miu-ll/robot-2/imagenes/explosionada_perfil.png

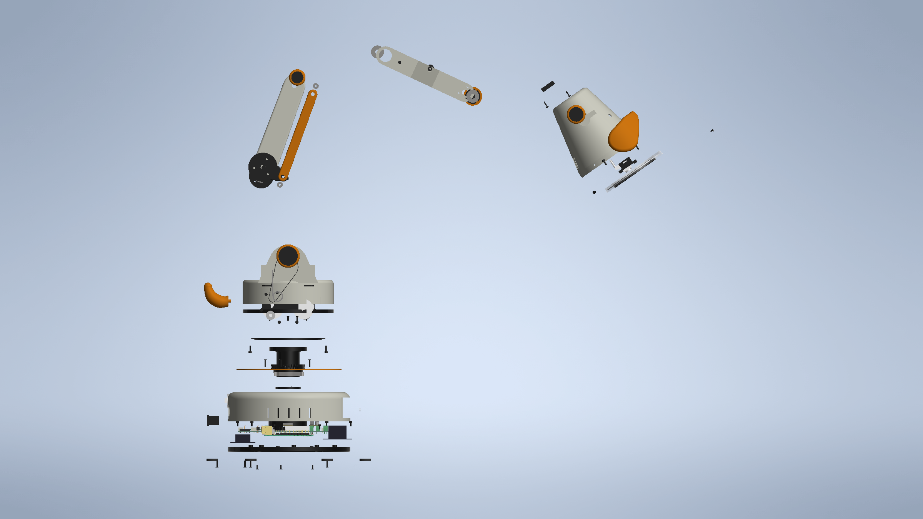
imagenes/explosionada_perfil.png
