miu-ll/robot-2/imagenes/foto_producto_alto.png

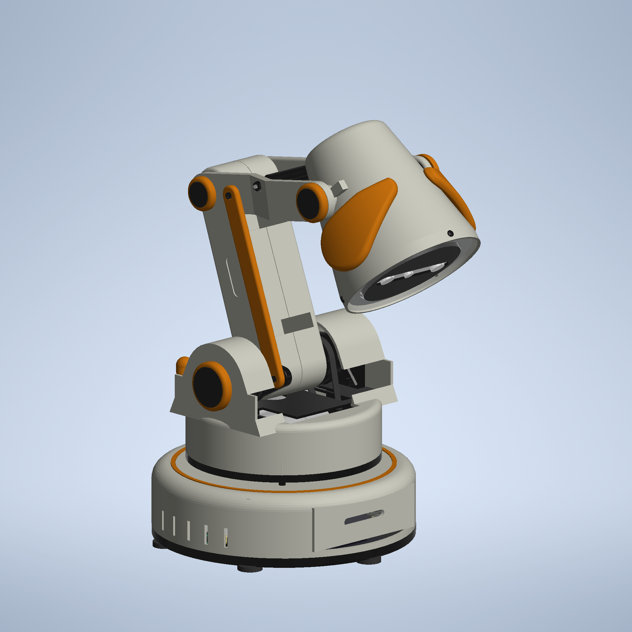
imagenes/foto_producto_alto.png
