miu-ll/robot-2/imagenes/explosionada_iso.png

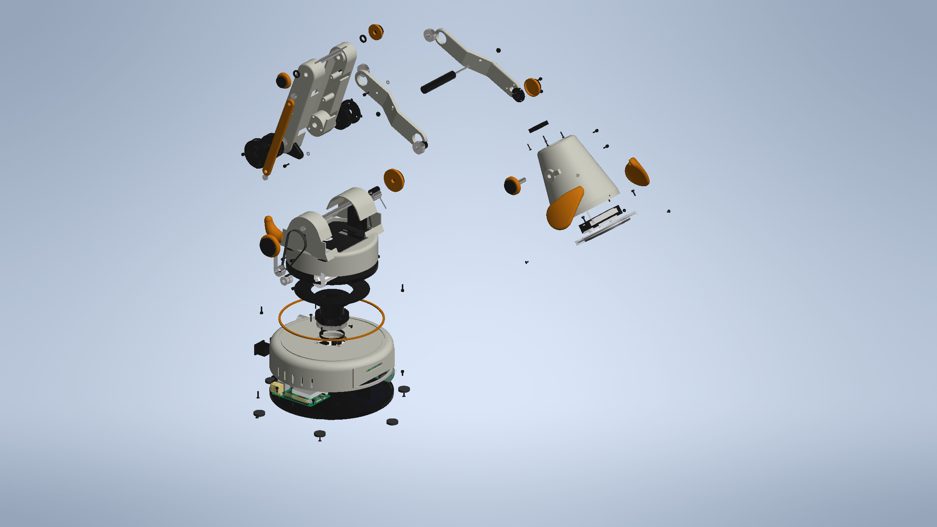
imagenes/explosionada_iso.png
