miu-ll/robot-2/imagenes/foto_producto_3-4.png

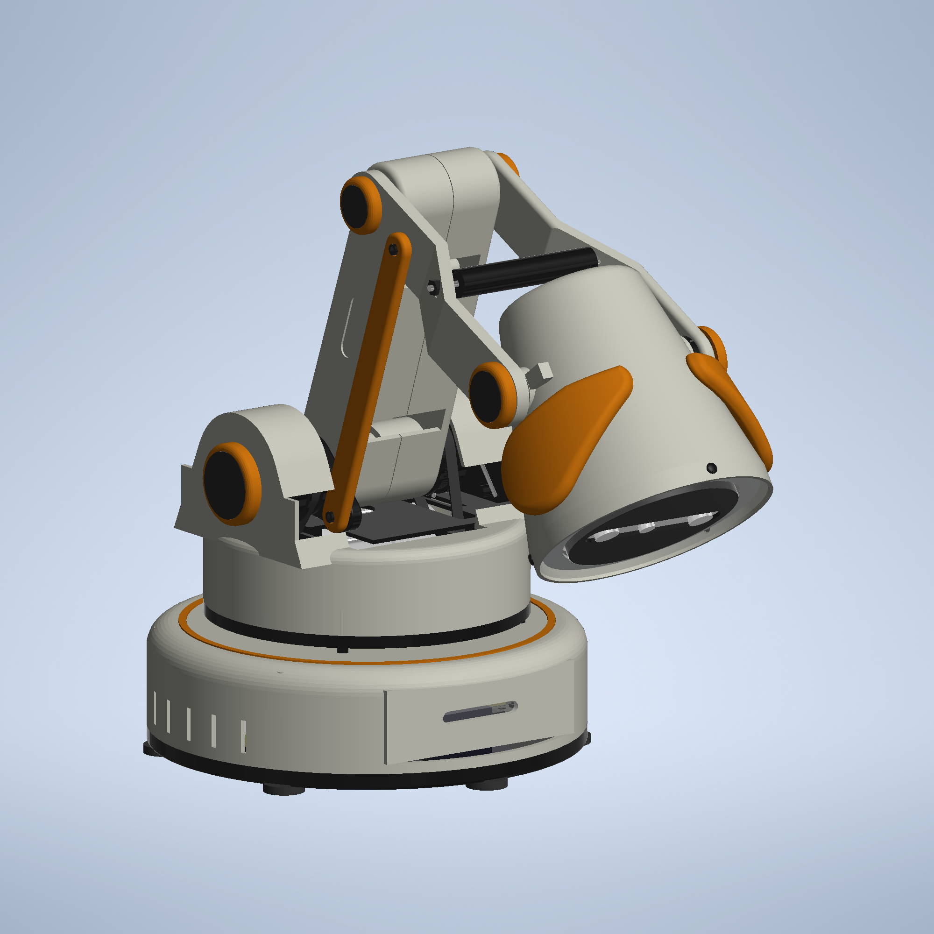
imagenes/foto_producto_3-4.png
