miu-ll/robot-2/imagenes/foto_producto_frente.png

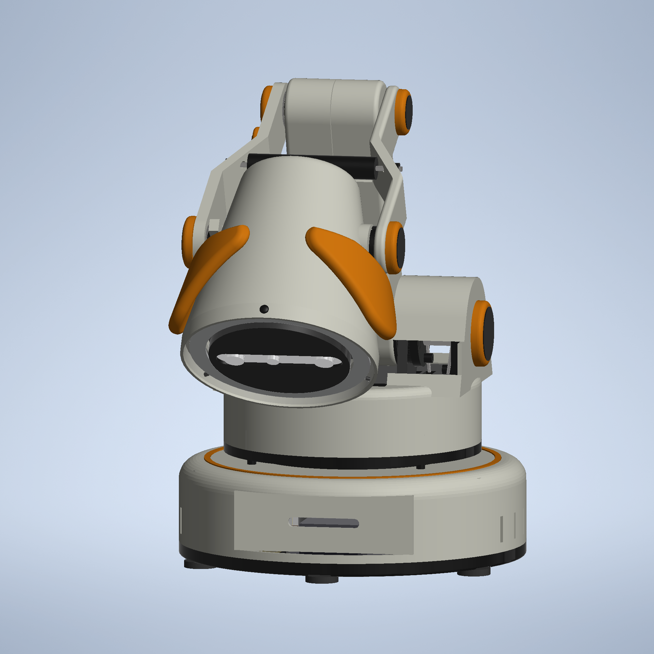
imagenes/foto_producto_frente.png
