miu-ll/robot-2/imagenes/rangos/rango_anotado_q1.png

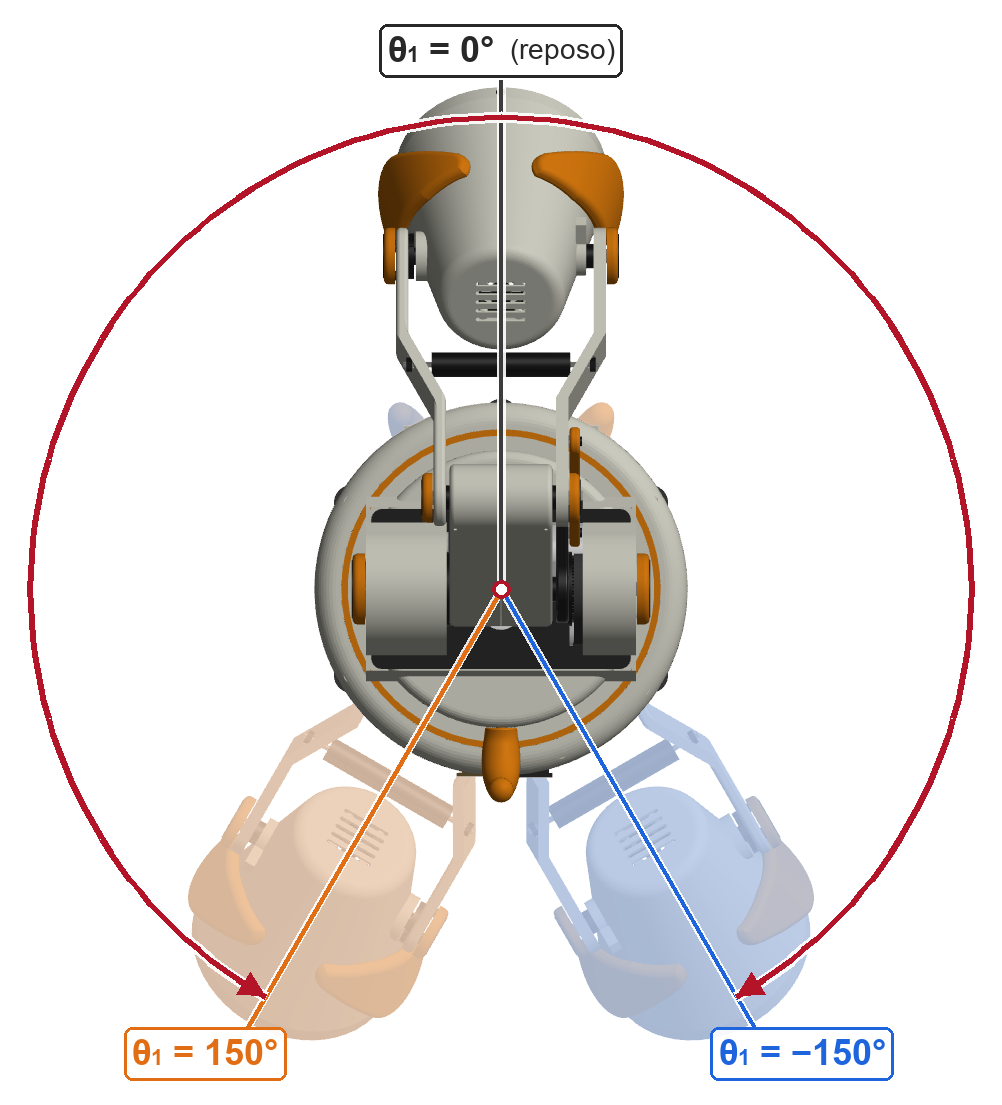
imagenes/rangos/rango_anotado_q1.png
