miu-ll/robot-2/imagenes/rangos/rango_anotado_q2.png

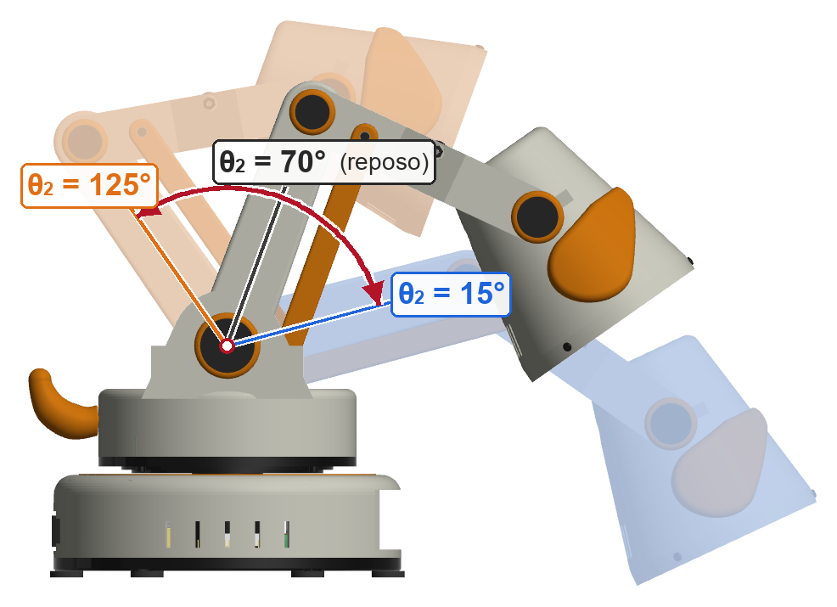
imagenes/rangos/rango_anotado_q2.png
