miu-ll/robot-2/imagenes/sistemas_dh.png

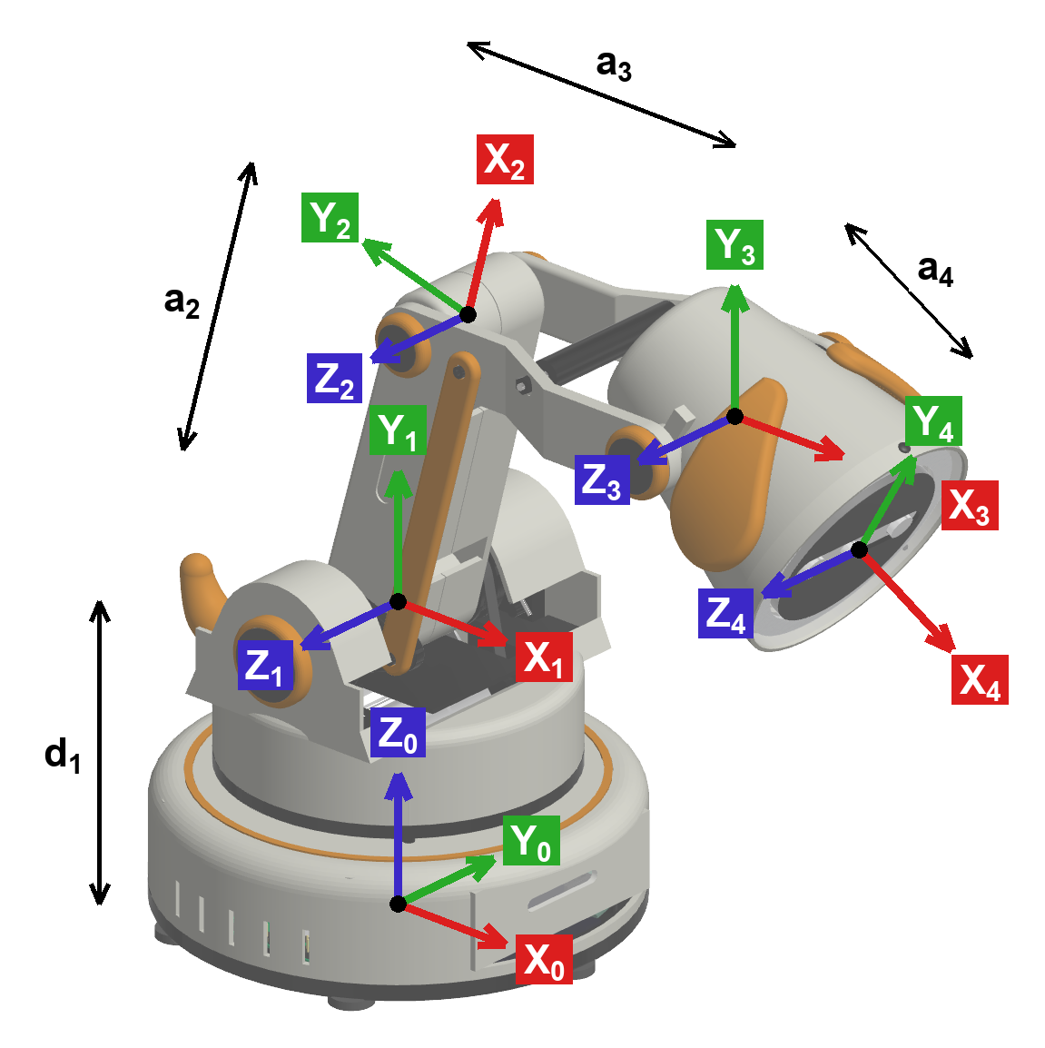
imagenes/sistemas_dh.png
