miu-ll/robot-2/imagenes/vistas/vista_frontal.png

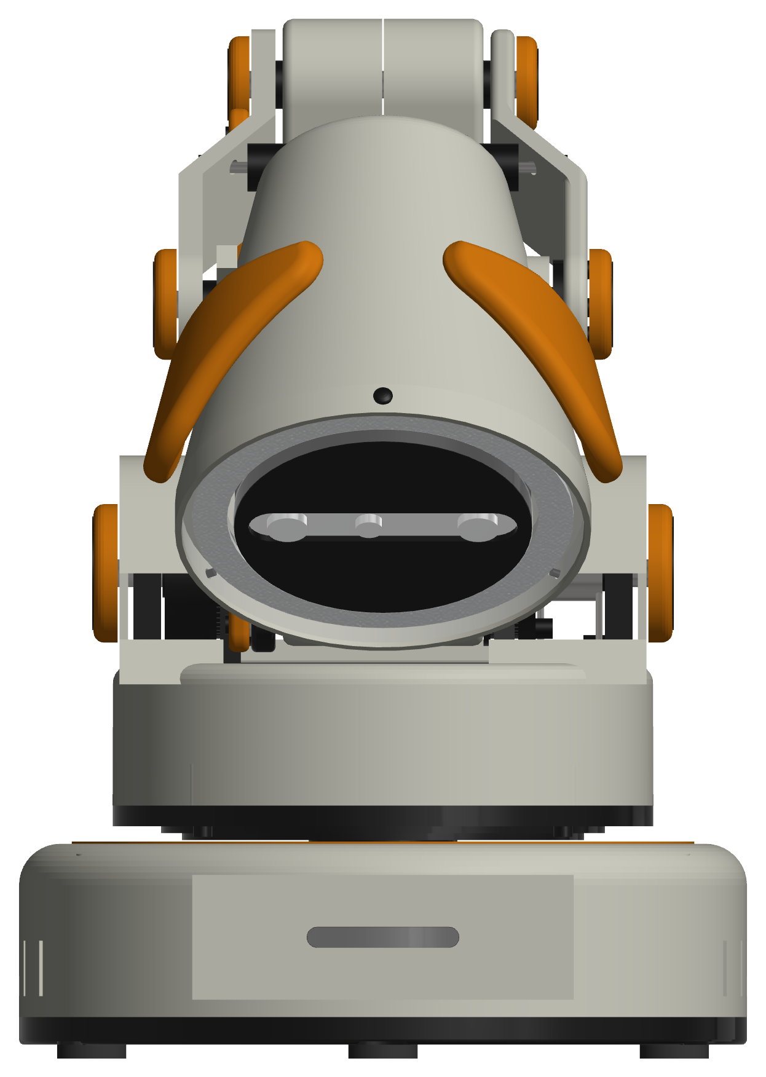
imagenes/vistas/vista_frontal.png
