miu-ll/robot-2/imagenes/vistas/vista_isometrica.png

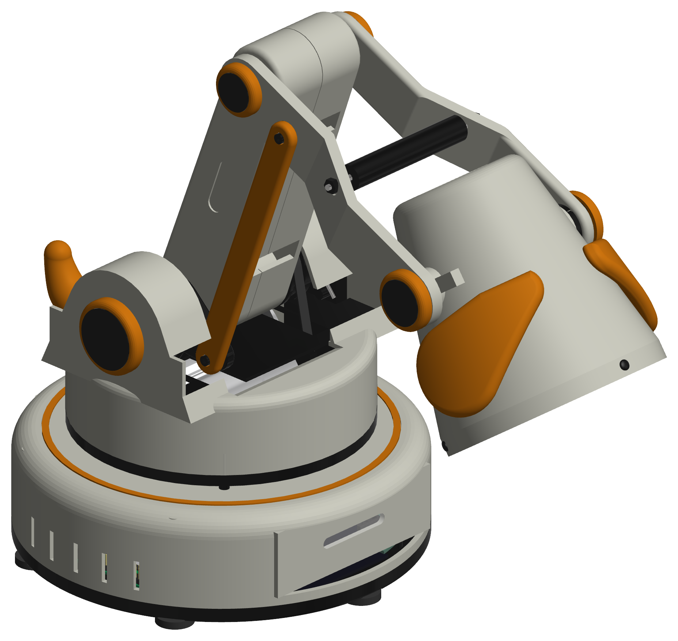
imagenes/vistas/vista_isometrica.png
