miu-ll/robot-2/imagenes/vistas/vista_perfil.png

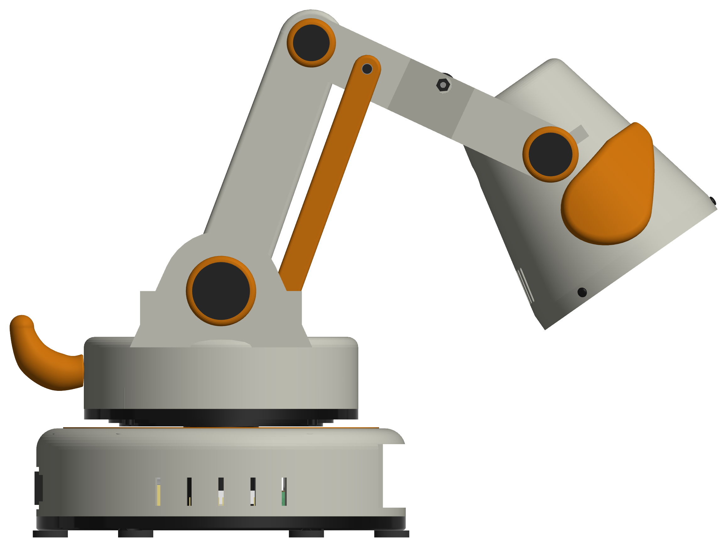
imagenes/vistas/vista_perfil.png
