miu-ll/robot-2/imagenes/vistas/vista_superior.png

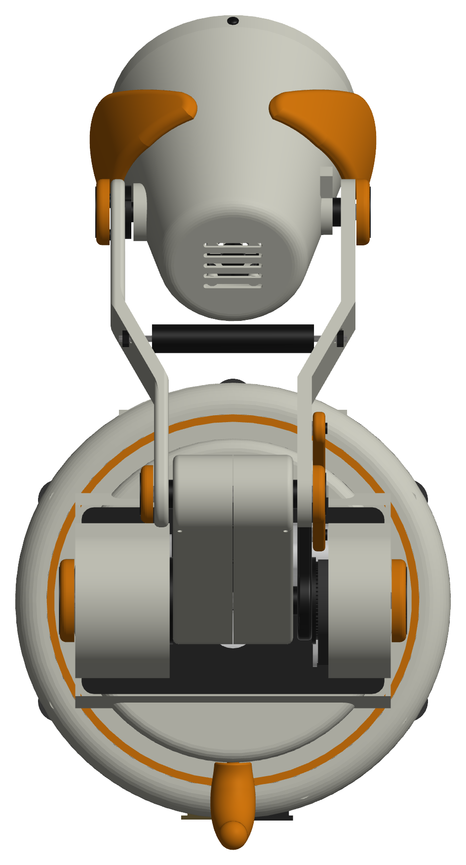
imagenes/vistas/vista_superior.png
