miu-ll/robot-2/electronica/Fabricacion/Lampara_4R_placa.step

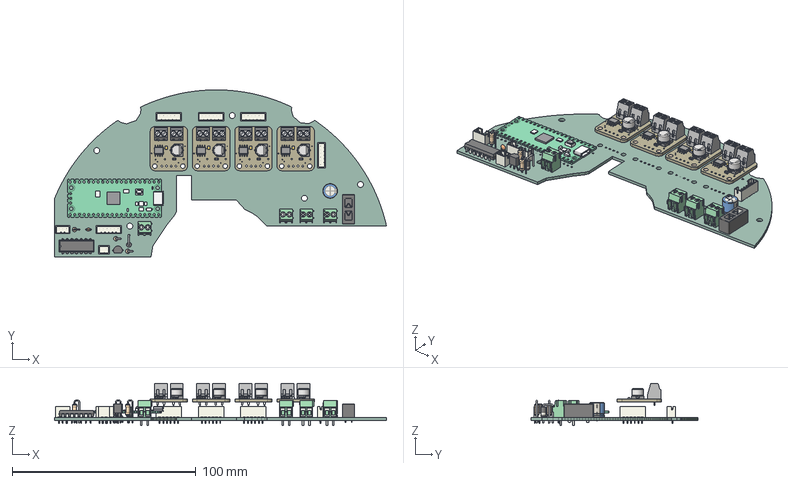
[picture p15: CAD file, 2026-10-04]
electronica/Fabricacion/Lampara_4R_placa.step
180.7 x 91.0 x 23.1 mm
Board x 4
HSOP8 x 4
0805-NO x 4
PANASONIC_D x 4
0805-THM x 4
TERMBLOCK_1X2-3.5MM x 8
TerminalBlock_Phoenix_PT-1,5-2-3.5-H_1x02_P3.50mm_Horizontal x 4
JST_PH_B2B-PH-K_1x02_P2.00mm_Vertical
CP_Radial_D8.0mm_P3.50mm
Fuseholder_Blade_Mini_Keystone_3568
JST_PH_B6B-PH-K_1x06_P2.00mm_Vertical x 5
R_Axial_DIN0207_L6.3mm_D2.5mm_P2.54mm_Vertical x 3
C_Disc_D3.0mm_W1.6mm_P2.50mm
JST_PH_B3B-PH-K_1x03_P2.00mm_Vertical
TO-92_Inline_Wide
DIP-14_W7.62mm
D_DO-41_SOD81_P5.08mm_Vertical_AnodeUp
Lampara_4R_PCB
