miu-ll/robot-2/electronica/modelos_3d/3190_DRV8871_Breakout.step

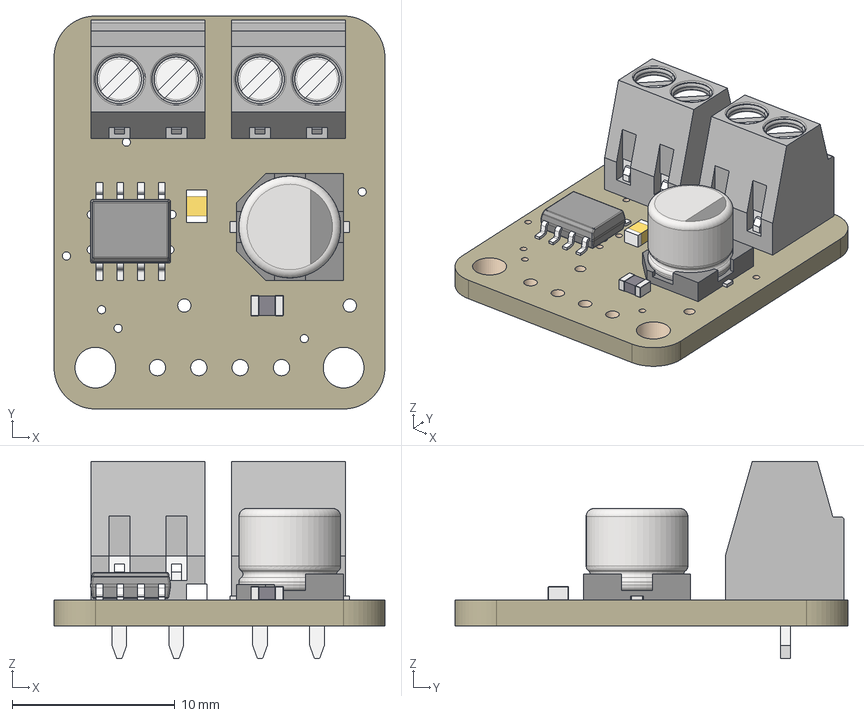
[picture p16: CAD file, 2026-10-04]
electronica/modelos_3d/3190_DRV8871_Breakout.step
20.3 x 24.1 x 12.1 mm
Board
DRV8871
0.1uF/50V
22uF/63V
30K
POWER x 2
