miu-ll/robot-2/electronica/modelos_3d/Pico-R3_color.step

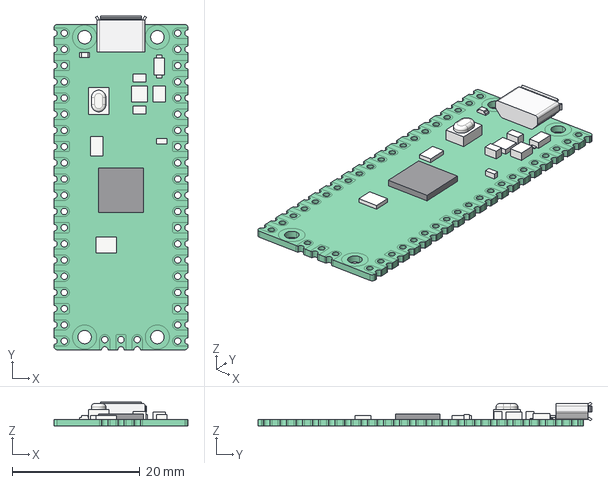
[picture p17: CAD file, 2026-10-04]
electronica/modelos_3d/Pico-R3_color.step
21.0 x 52.3 x 3.73 mm
