miu-ll/robot-2/imagenes/montaje/montaje_sub_1.png

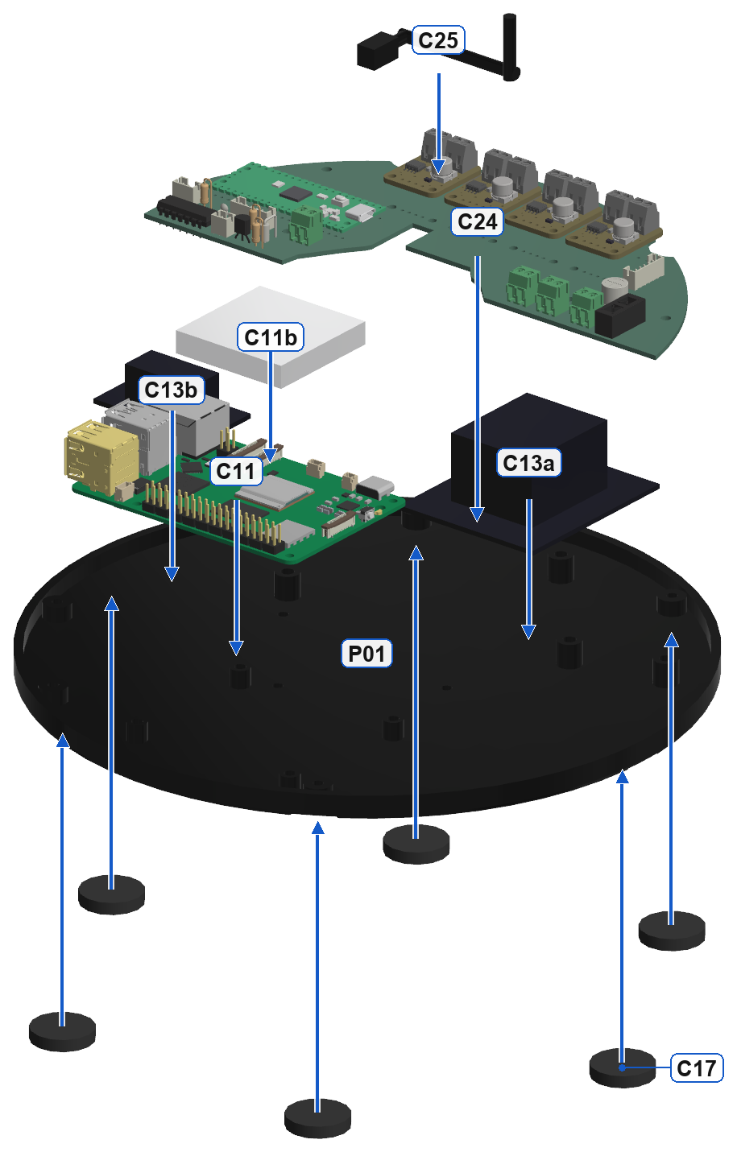
imagenes/montaje/montaje_sub_1.png
