miu-ll/robot-2/imagenes/montaje/montaje_sub_2.png

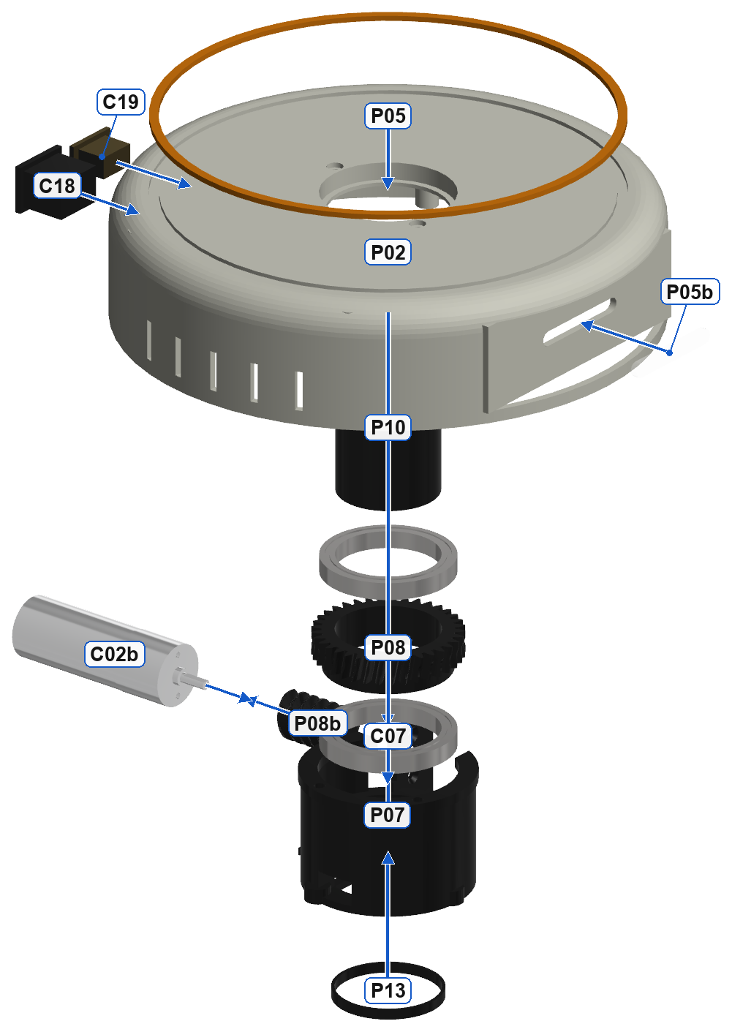
imagenes/montaje/montaje_sub_2.png
