miu-ll/robot-2/imagenes/montaje/montaje_sub_3.png

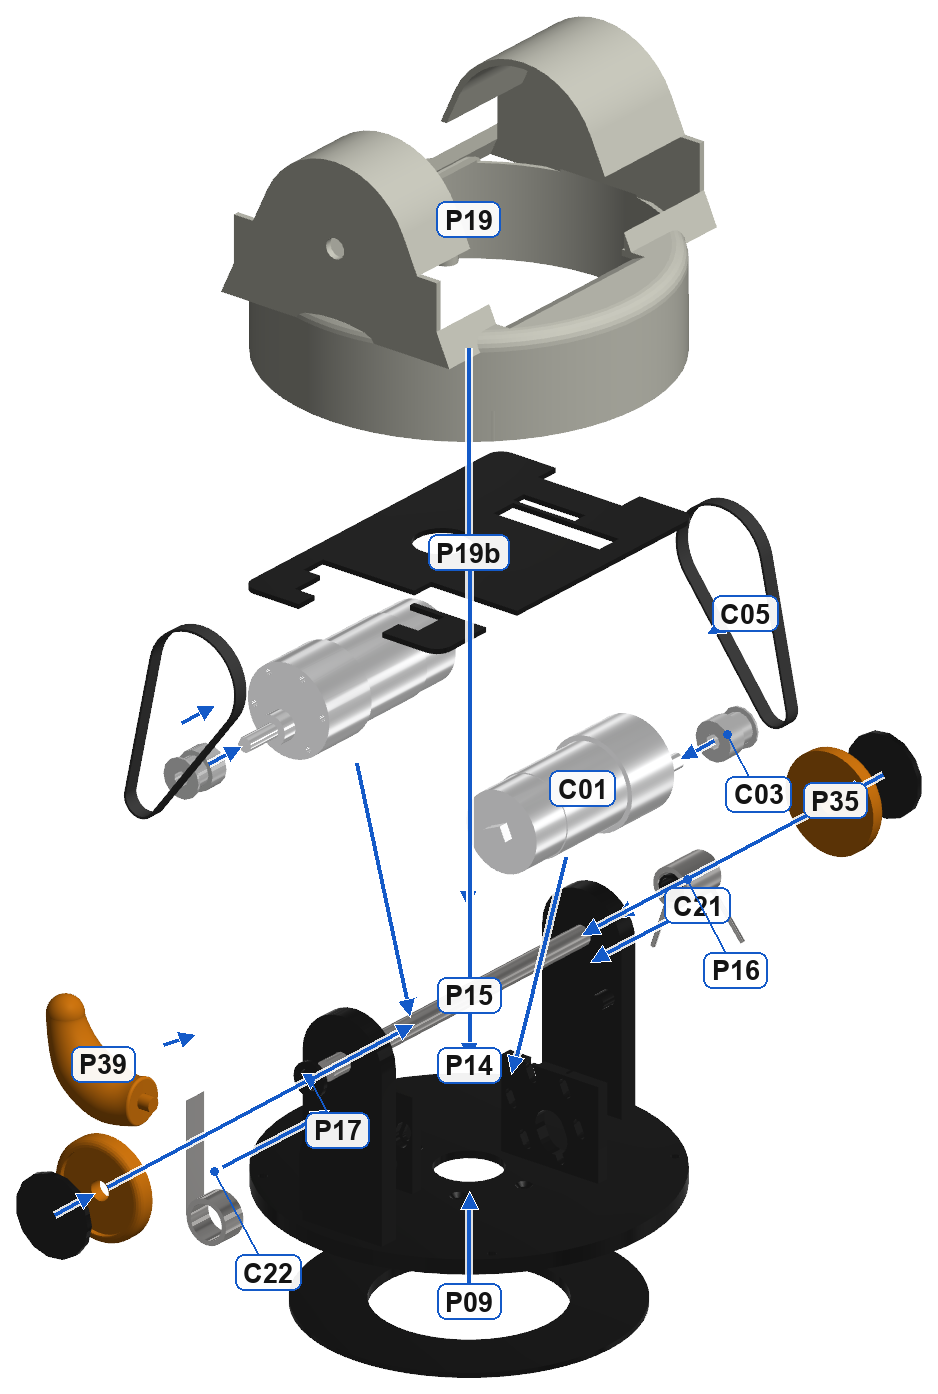
imagenes/montaje/montaje_sub_3.png
