miu-ll/robot-2/imagenes/montaje/montaje_sub_4.png

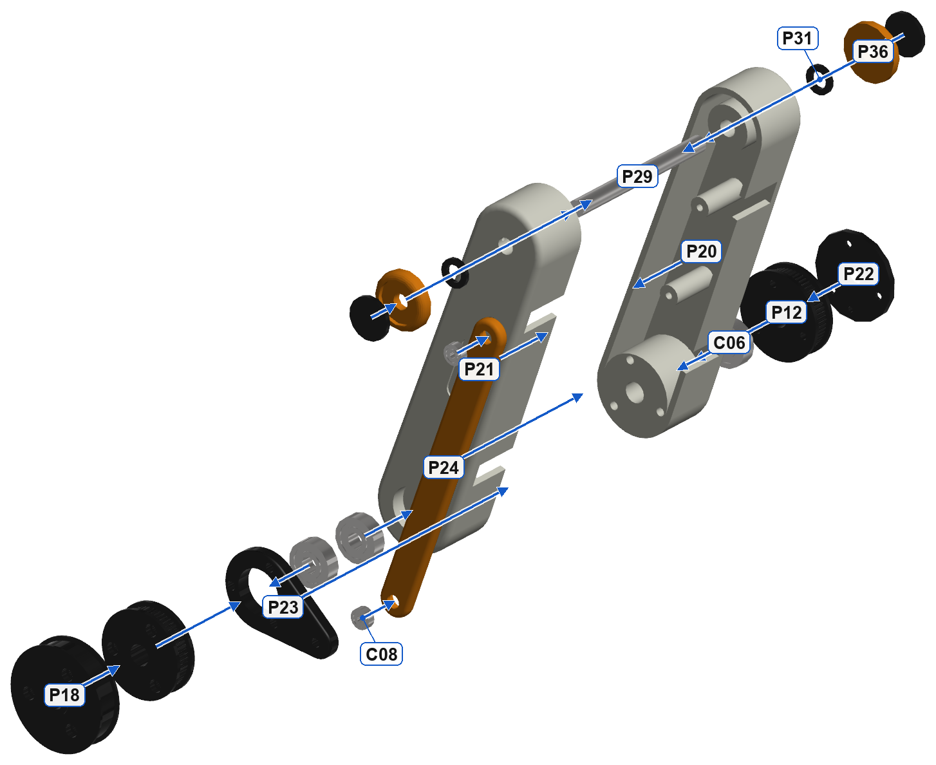
imagenes/montaje/montaje_sub_4.png
