miu-ll/robot-2/imagenes/montaje/montaje_sub_5.png

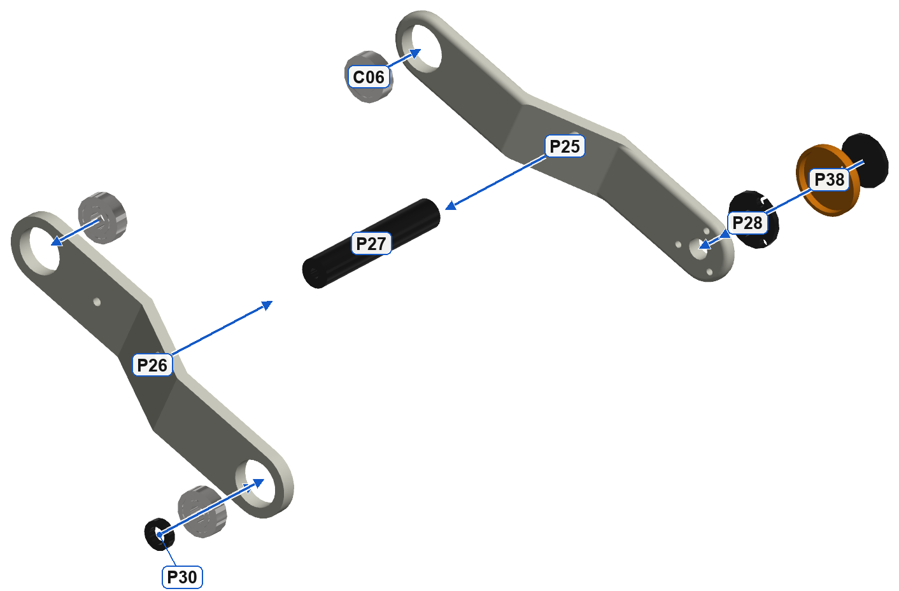
imagenes/montaje/montaje_sub_5.png
