miu-ll/robot-2/imagenes/montaje/montaje_sub_6.png

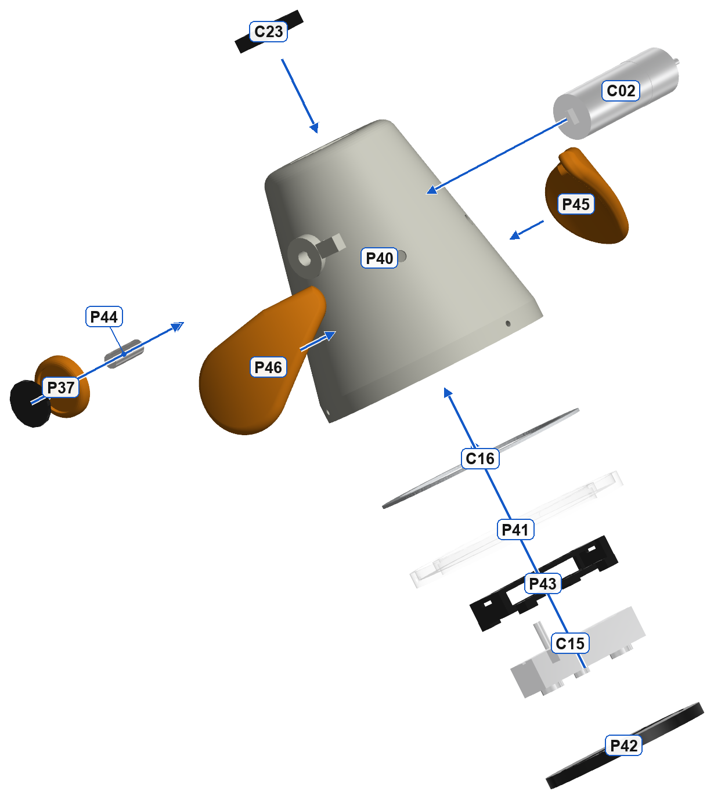
imagenes/montaje/montaje_sub_6.png
