miu-ll/robot-2/electronica/Lampara_4R_esquematico.pdf

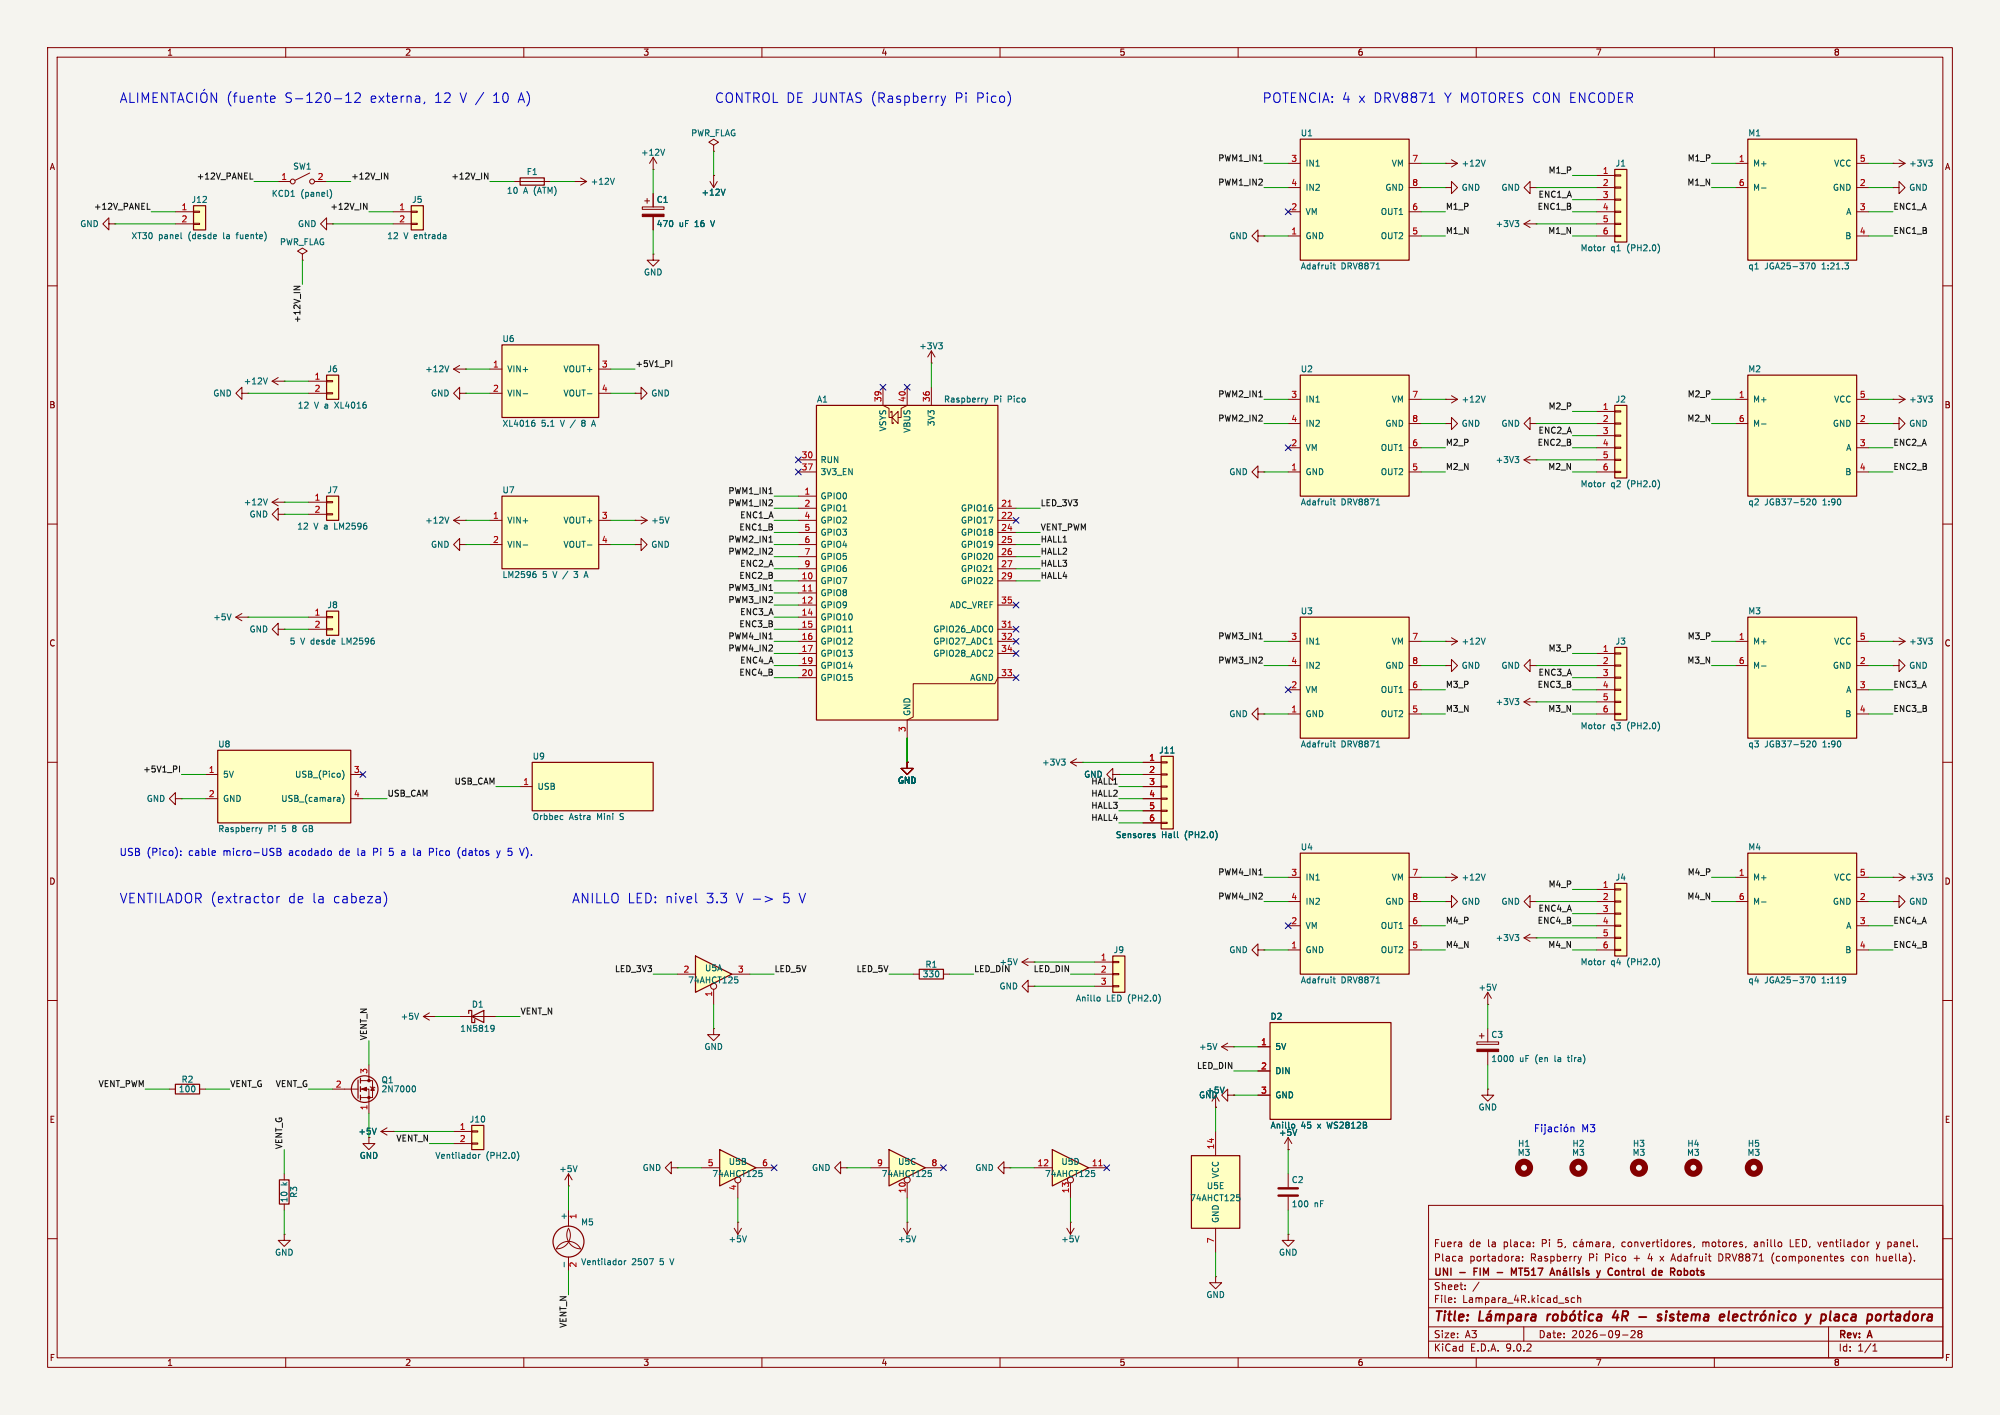
[picture p24: page 1]

POTENCIA: 4 x DRV8871 Y MOTORES CON ENCODER
PWM1_IN2 PWM2_IN1 PWM1_IN1

J12 XT30 panel (desde la fuente)

+3V3 USB 1 U9 Orbbec Astra Mini S

3 3V3 36 GPIO16 21 GPIO17 22 GPIO18 24 GPIO19 25 GPIO20 26 GPIO21 27 GPIO22 29 ADC_VREF 35 GPIO26_ADC0 31 GPIO27_ADC1 32 GPIO28_ADC2 34 AGND 33 A1 Raspberry Pi Pico GND

1000 uF (en la tira) GND

Id: 1/1 Title: þÿLámpara þÿrobótica 4R - sistema þÿelectrónico y placa portadora
