miu-ll/robot-2/planos/Planos_piezas_Lampara_4R.pdf

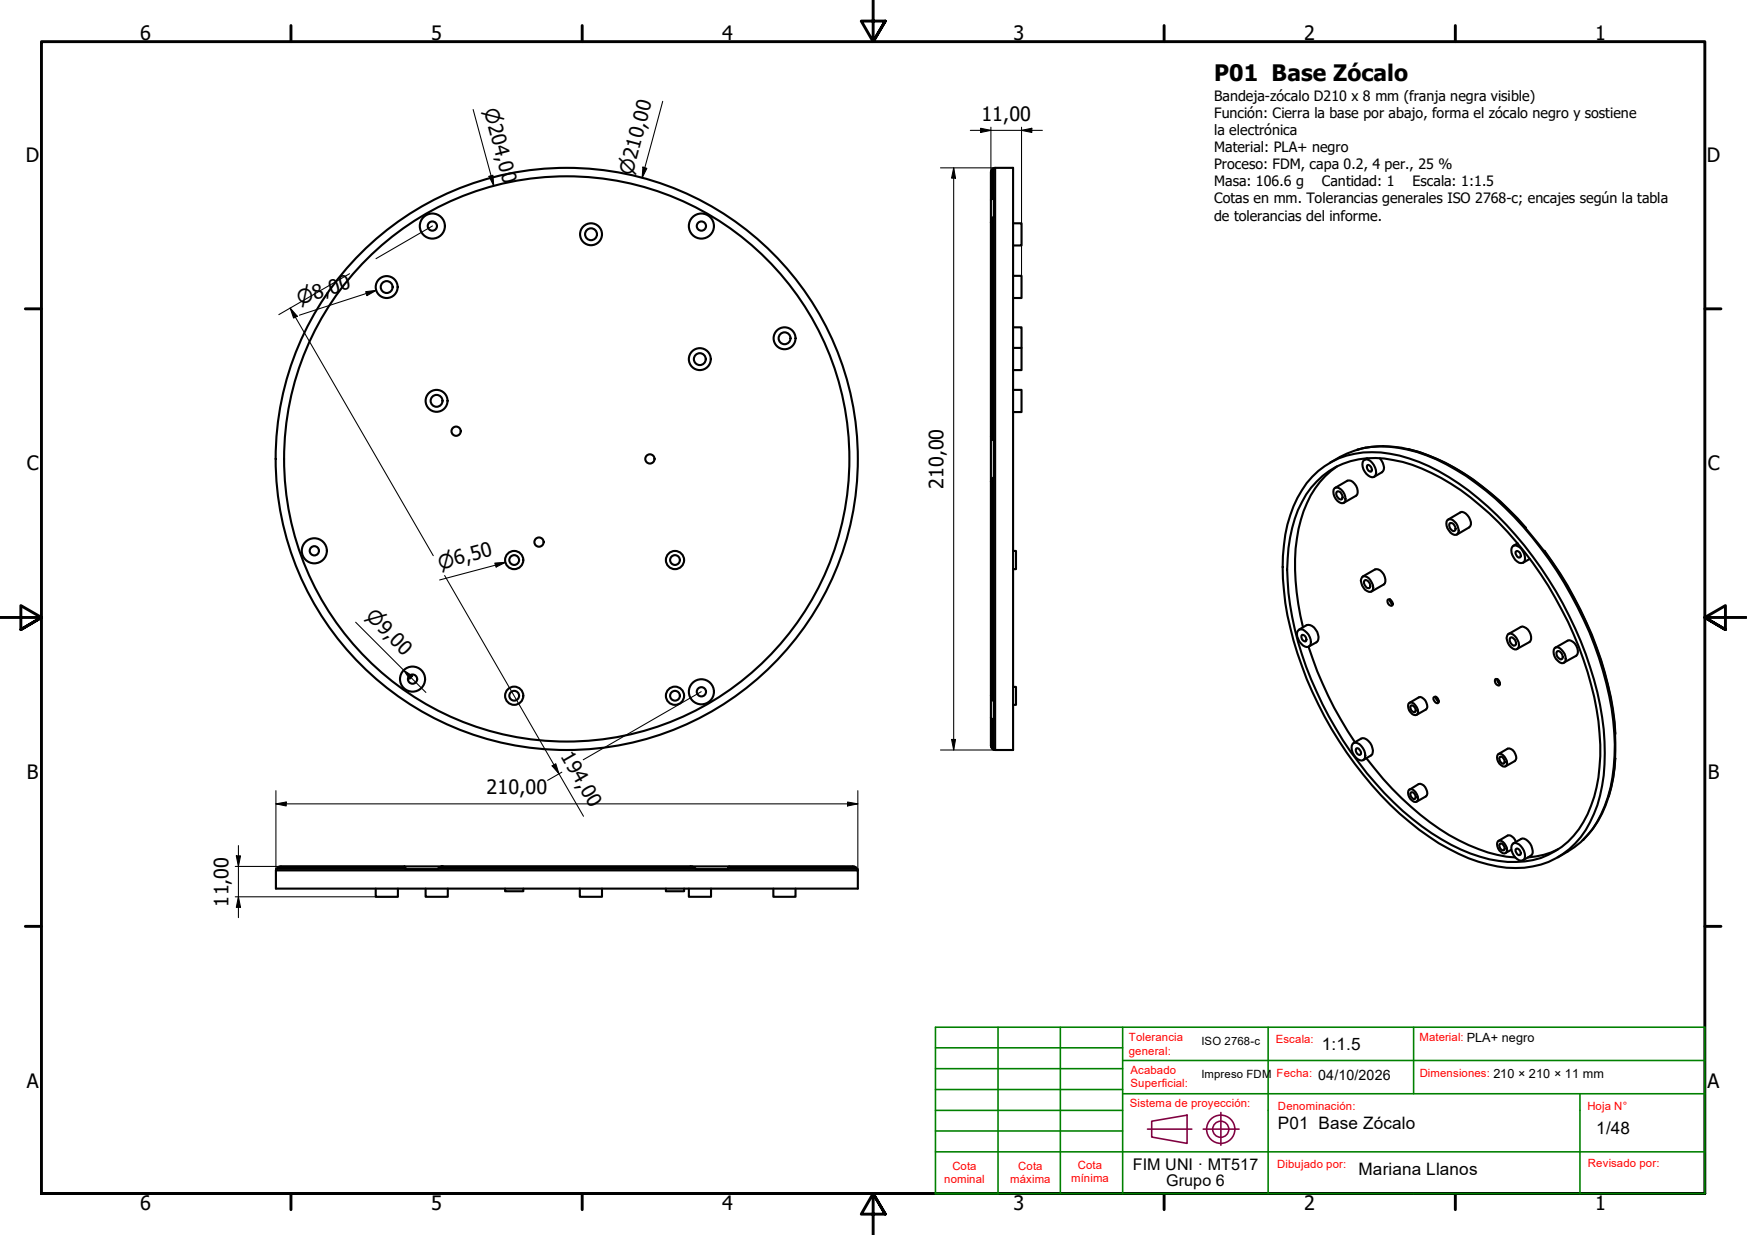
[picture p25: page 1]
Revisado por: ibujado por:; Mariana Llanos; FIM UNI · MT517 Grupo 6; P01 Base Zócalo; Masa: 106.6 g; Cantidad: 1; Escala: 1:1.5

Bandeja-zócalo D210 x 8 mm (franja negra visible)
Función: Cierra la base por abajo, forma el zócalo negro y sostiene
la electrónica
Material: PLA+ negro
Proceso: FDM, capa 0.2, 4 per., 25 %
Cotas en mm. Tolerancias generales ISO 2768-c; encajes según la tabla
de tolerancias del informe.

Tolerancia ISO 2768-c general: | Escala: 1:1.5 | Material: PLA+ negro

Acabado Impreso FDM Superficial: | Fecha: 04/10/2026 | Dimensiones: 210 × 210 × 11 mm

Sistema de proyección: | Denominación: P01 Base Zócalo | Hoja N° 1/48

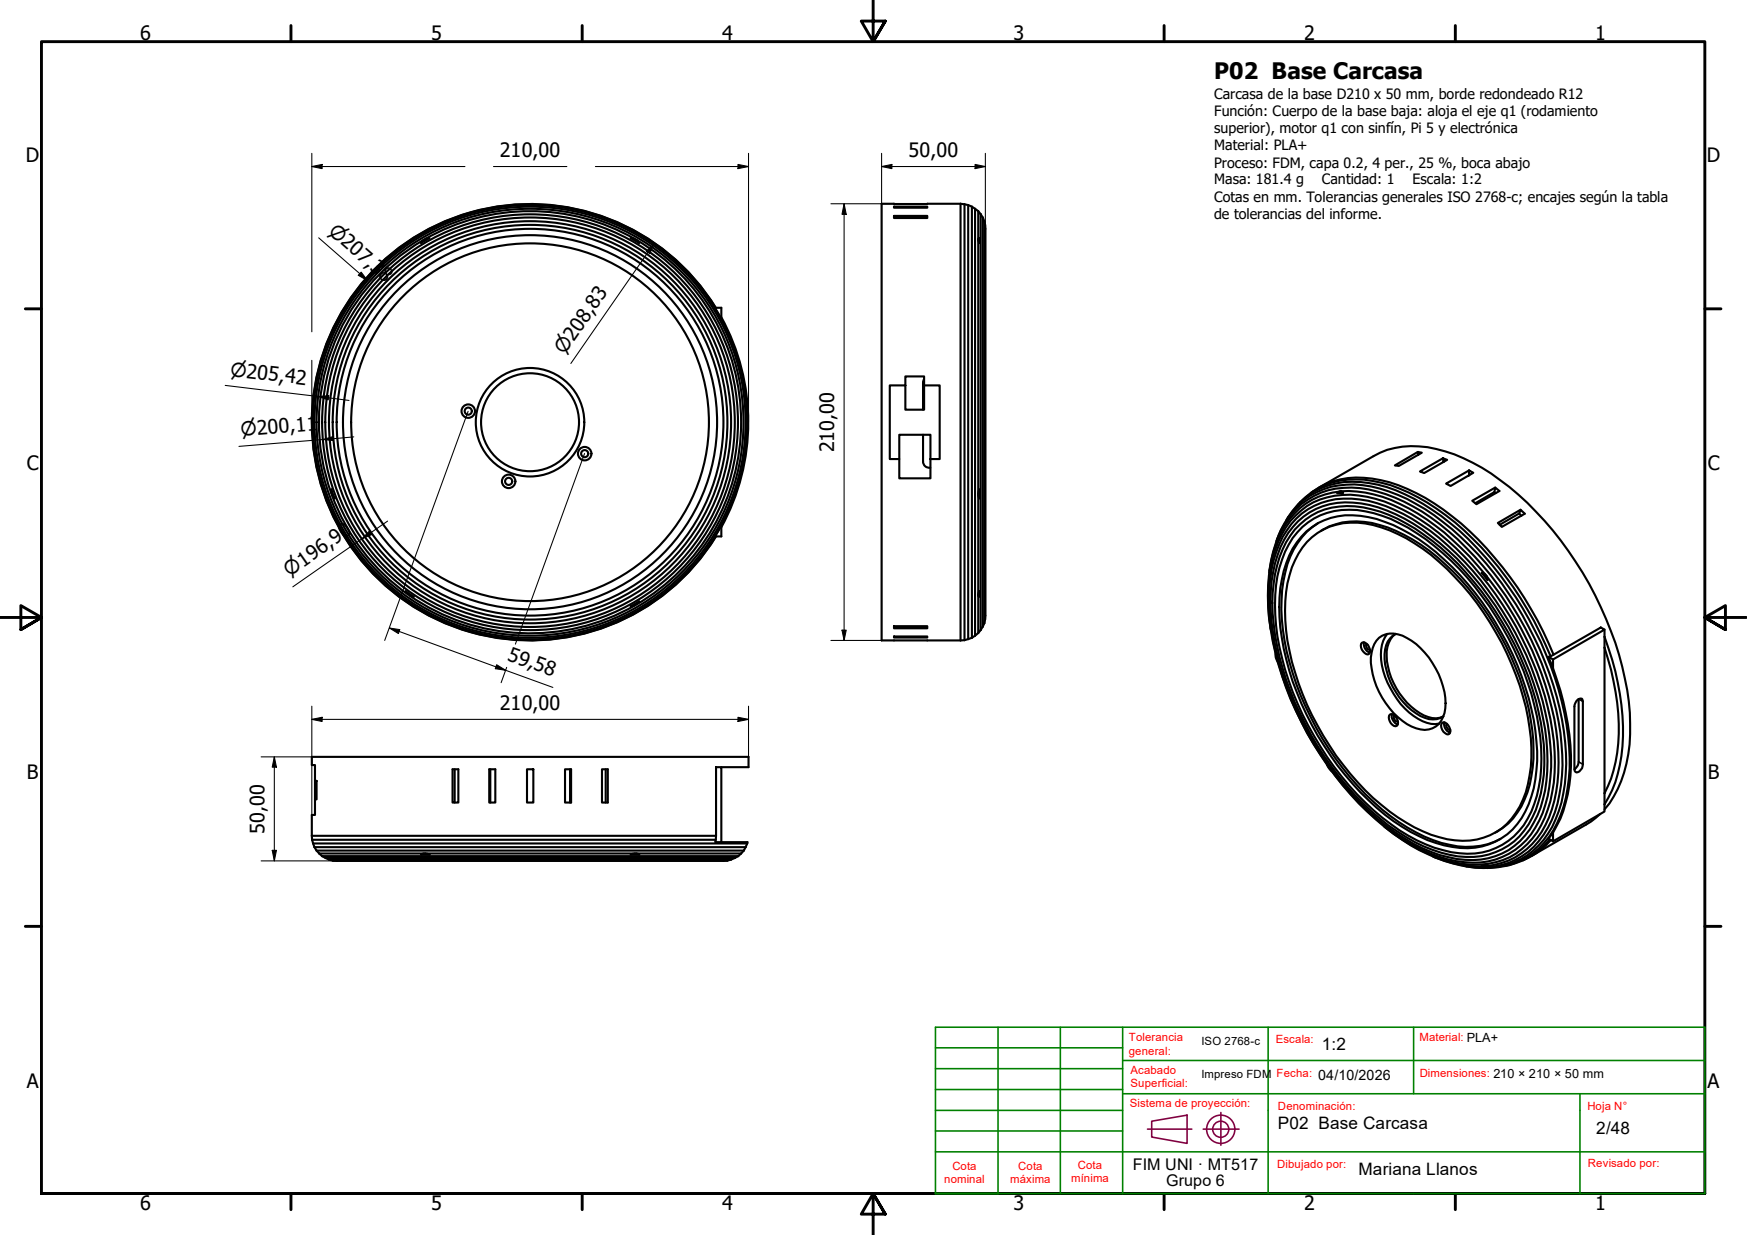
[picture p26: page 2]
Masa: 181.4 g; Cantidad: 1; Escala: 1:2

P02 Base Carcasa
Carcasa de la base D210 x 50 mm, borde redondeado R12
Función: Cuerpo de la base baja: aloja el eje q1 (rodamiento
superior), motor q1 con sinfín, Pi 5 y electrónica
Material: PLA+
Proceso: FDM, capa 0.2, 4 per., 25 %, boca abajo
Cotas en mm. Tolerancias generales ISO 2768-c; encajes según la tabla
de tolerancias del informe.

Tolerancia ISO 2768-c general: | Escala: 1:2 | Material: PLA+

Acabado Impreso FDM Superficial: | Fecha: 04/10/2026 | Dimensiones: 210 × 210 × 50 mm

Sistema de proyección: | Denominación: P02 Base Carcasa | Hoja N° 2/48

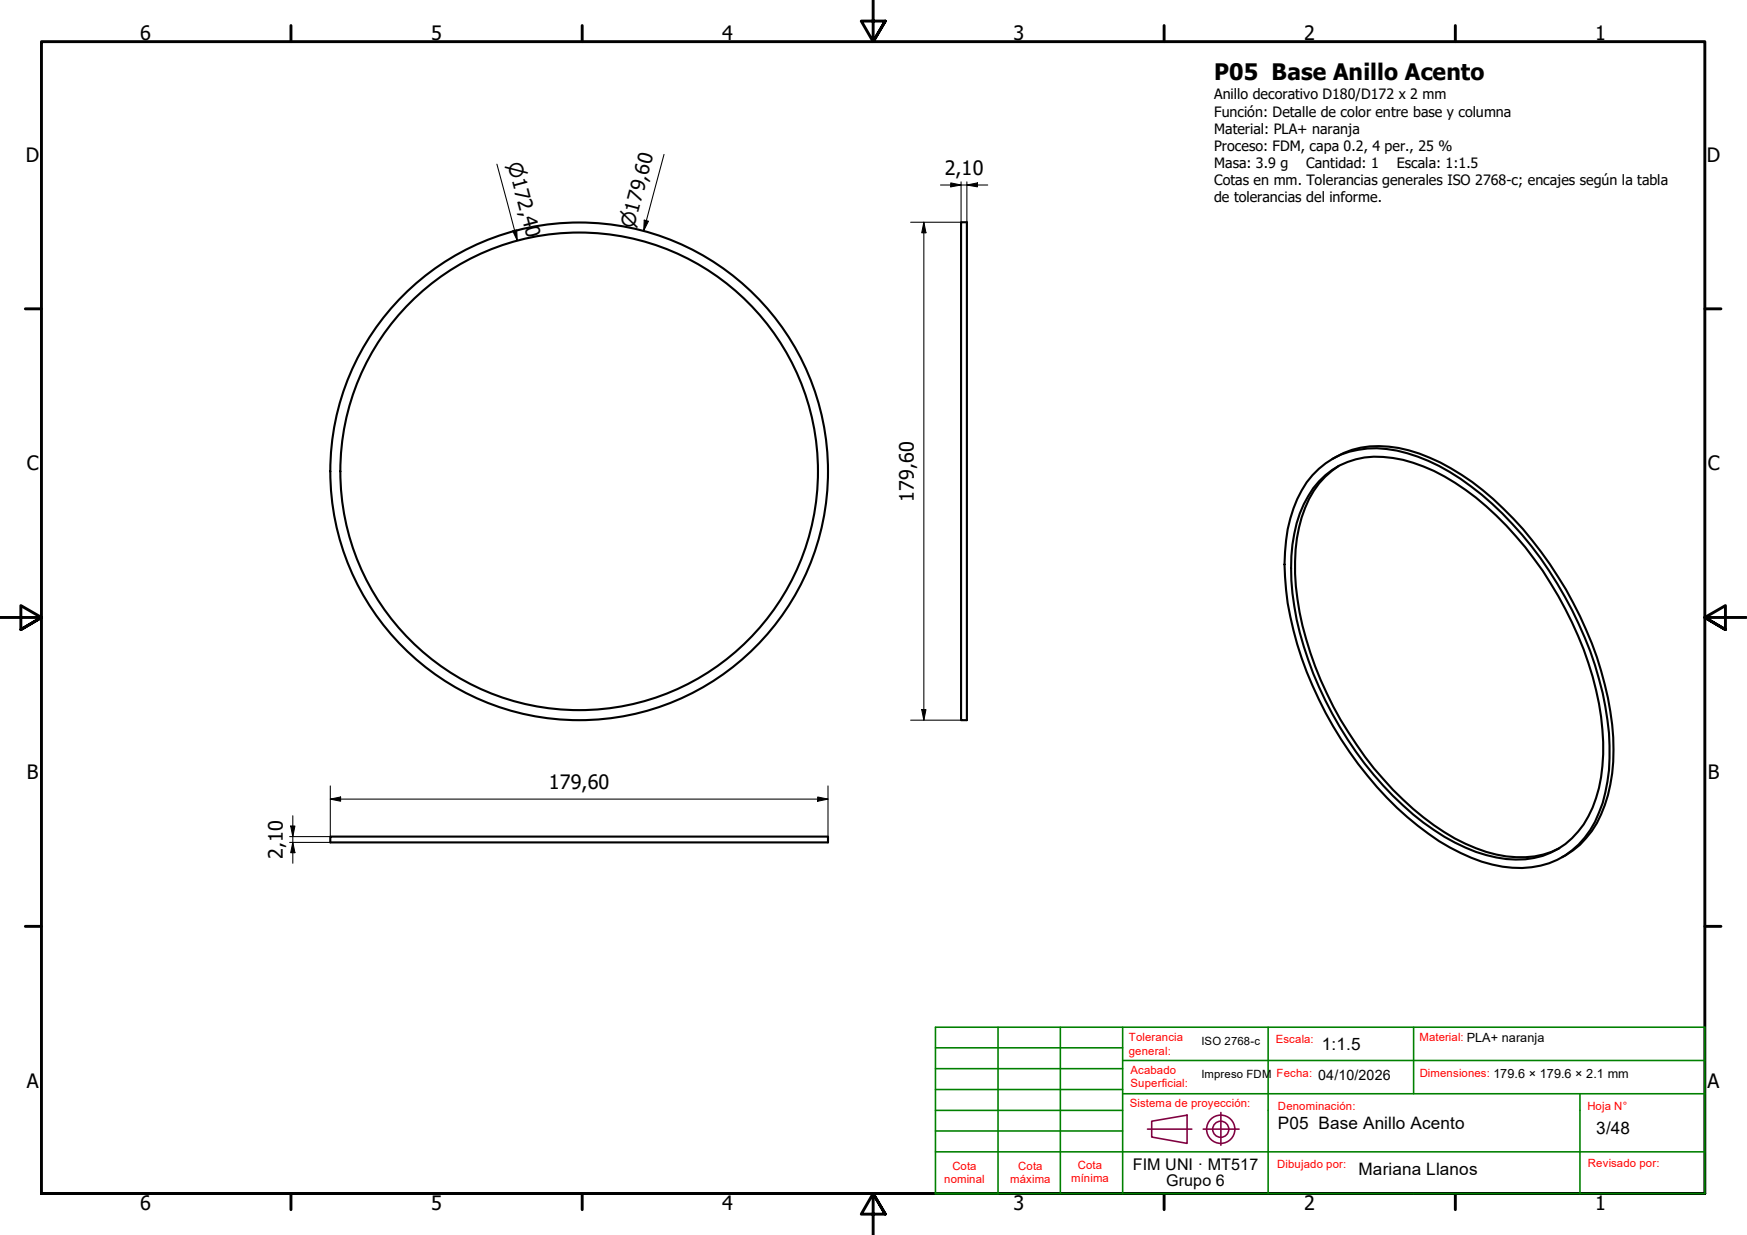
[picture p27: page 3]
Masa: 3.9 g; Cantidad: 1; Escala: 1:1.5

P05 Base Anillo Acento
Anillo decorativo D180/D172 x 2 mm
Función: Detalle de color entre base y columna
Material: PLA+ naranja
Proceso: FDM, capa 0.2, 4 per., 25 %
Cotas en mm. Tolerancias generales ISO 2768-c; encajes según la tabla
de tolerancias del informe.

Tolerancia ISO 2768-c general: | Escala: 1:1.5 | Material: PLA+ naranja

Acabado Impreso FDM Superficial: | Fecha: 04/10/2026 | Dimensiones: 179.6 × 179.6 × 2.1 mm

Sistema de proyección: | Denominación: P05 Base Anillo Acento | Hoja N° 3/48

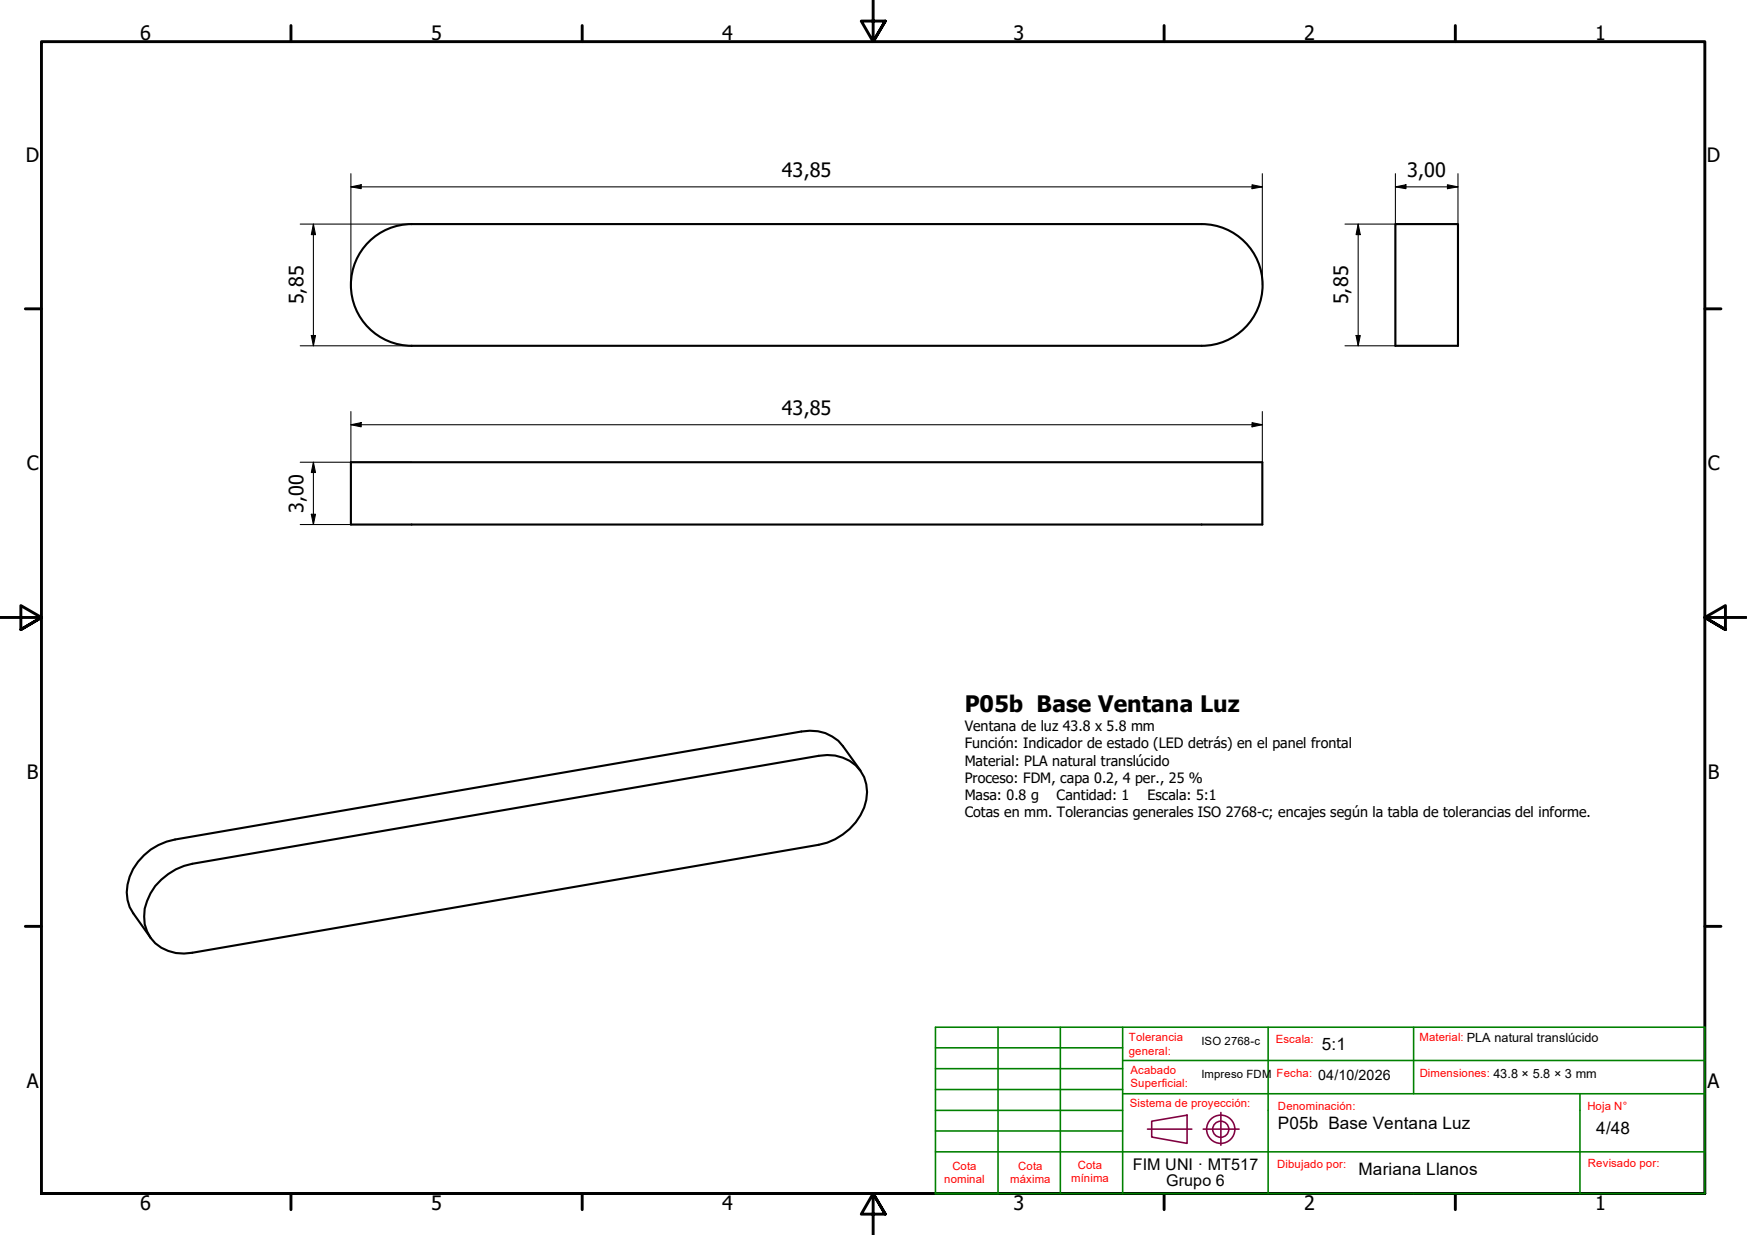
[picture p28: page 4]
Masa: 0.8 g; Cantidad: 1; Escala: 5:1

P05b Base Ventana Luz
Ventana de luz 43.8 x 5.8 mm
Función: Indicador de estado (LED detrás) en el panel frontal
Material: PLA natural translúcido
Proceso: FDM, capa 0.2, 4 per., 25 %
Cotas en mm. Tolerancias generales ISO 2768-c; encajes según la tabla de tolerancias del informe.

Tolerancia ISO 2768-c general: | Escala: 5:1 | Material: PLA natural translúcido

Acabado Impreso FDM Superficial: | Fecha: 04/10/2026 | Dimensiones: 43.8 × 5.8 × 3 mm

Sistema de proyección: | Denominación: P05b Base Ventana Luz | Hoja N° 4/48

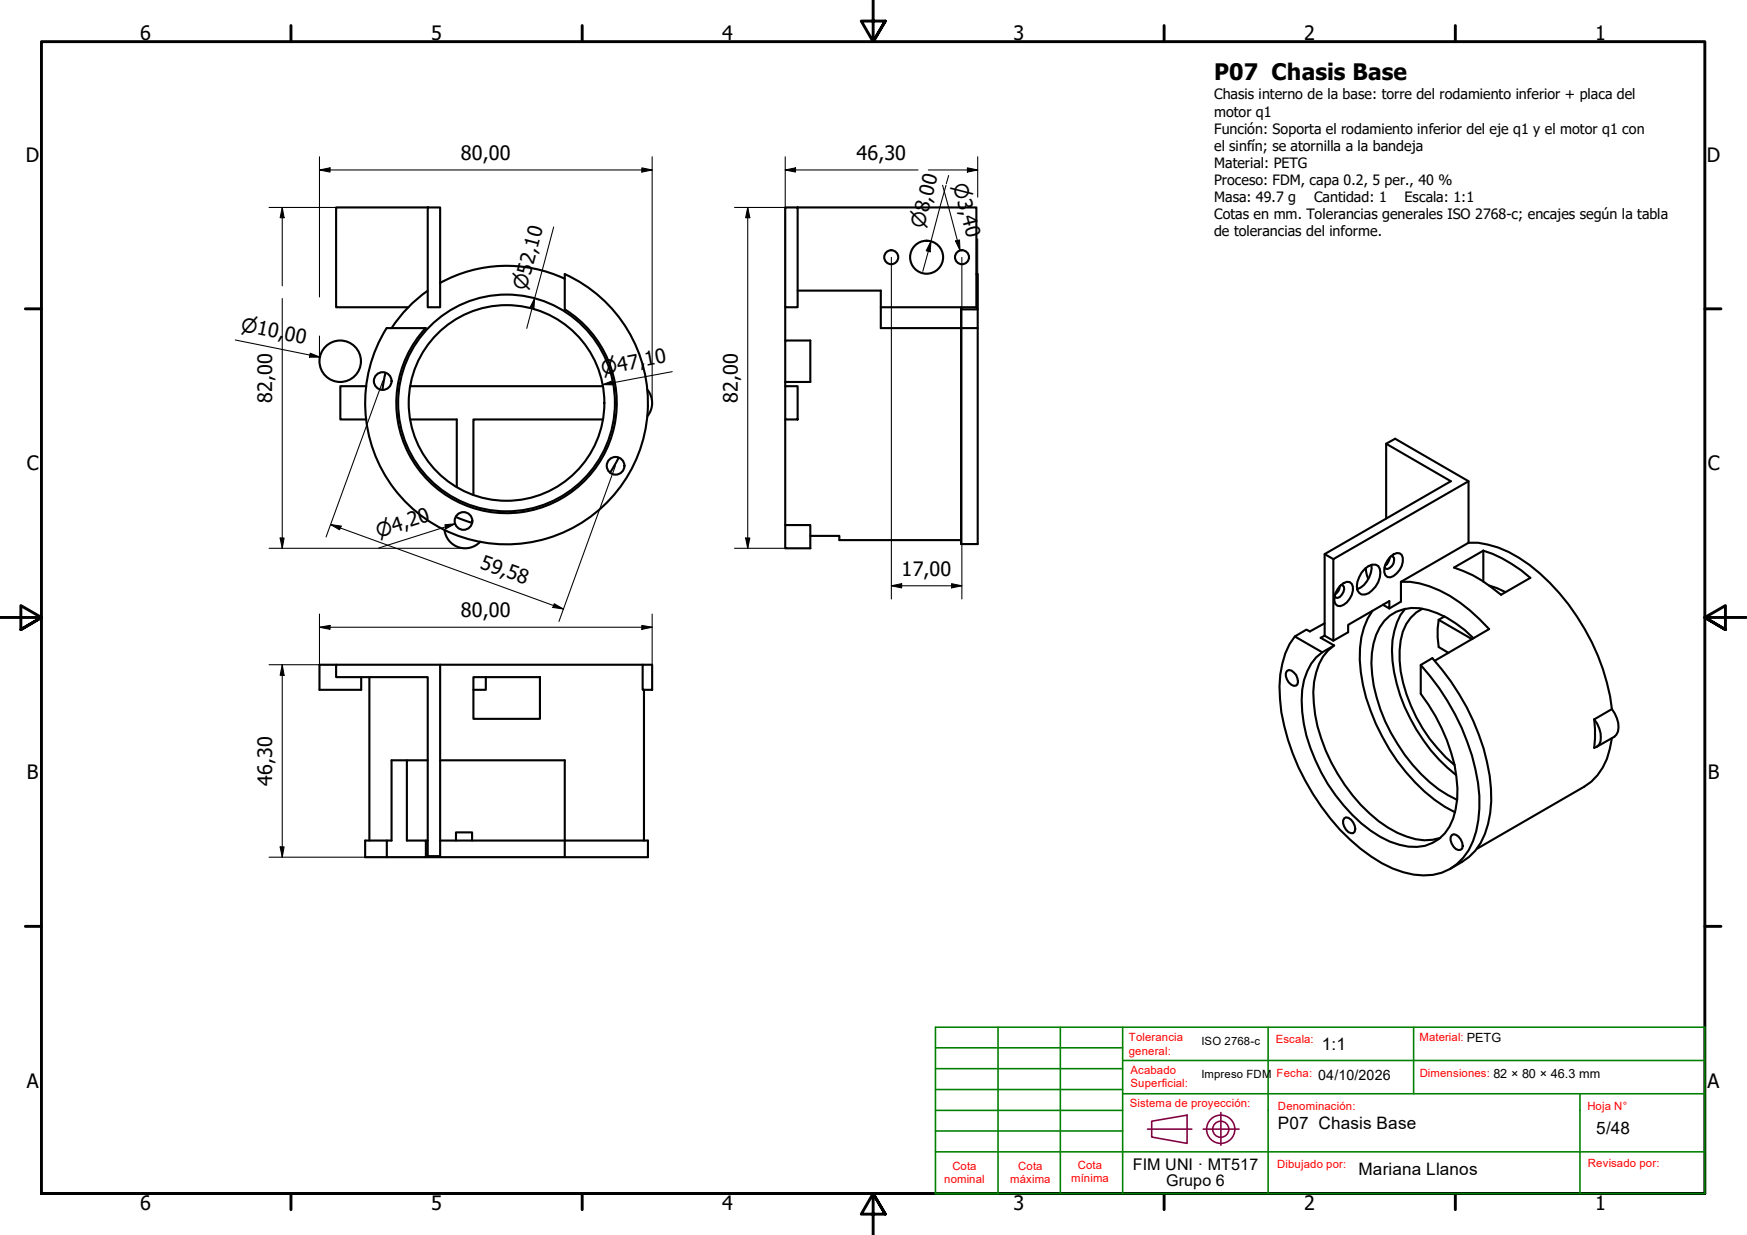
[picture p29: page 5]
Masa: 49.7 g; Cantidad: 1; Escala: 1:1

P07 Chasis Base
Chasis interno de la base: torre del rodamiento inferior + placa del
motor q1
Función: Soporta el rodamiento inferior del eje q1 y el motor q1 con
el sinfín; se atornilla a la bandeja
Material: PETG
Proceso: FDM, capa 0.2, 5 per., 40 %
Cotas en mm. Tolerancias generales ISO 2768-c; encajes según la tabla
de tolerancias del informe.

Tolerancia ISO 2768-c general: | Escala: 1:1 | Material: PETG

Acabado Impreso FDM Superficial: | Fecha: 04/10/2026 | Dimensiones: 82 × 80 × 46.3 mm

Sistema de proyección: | Denominación: P07 Chasis Base | Hoja N° 5/48

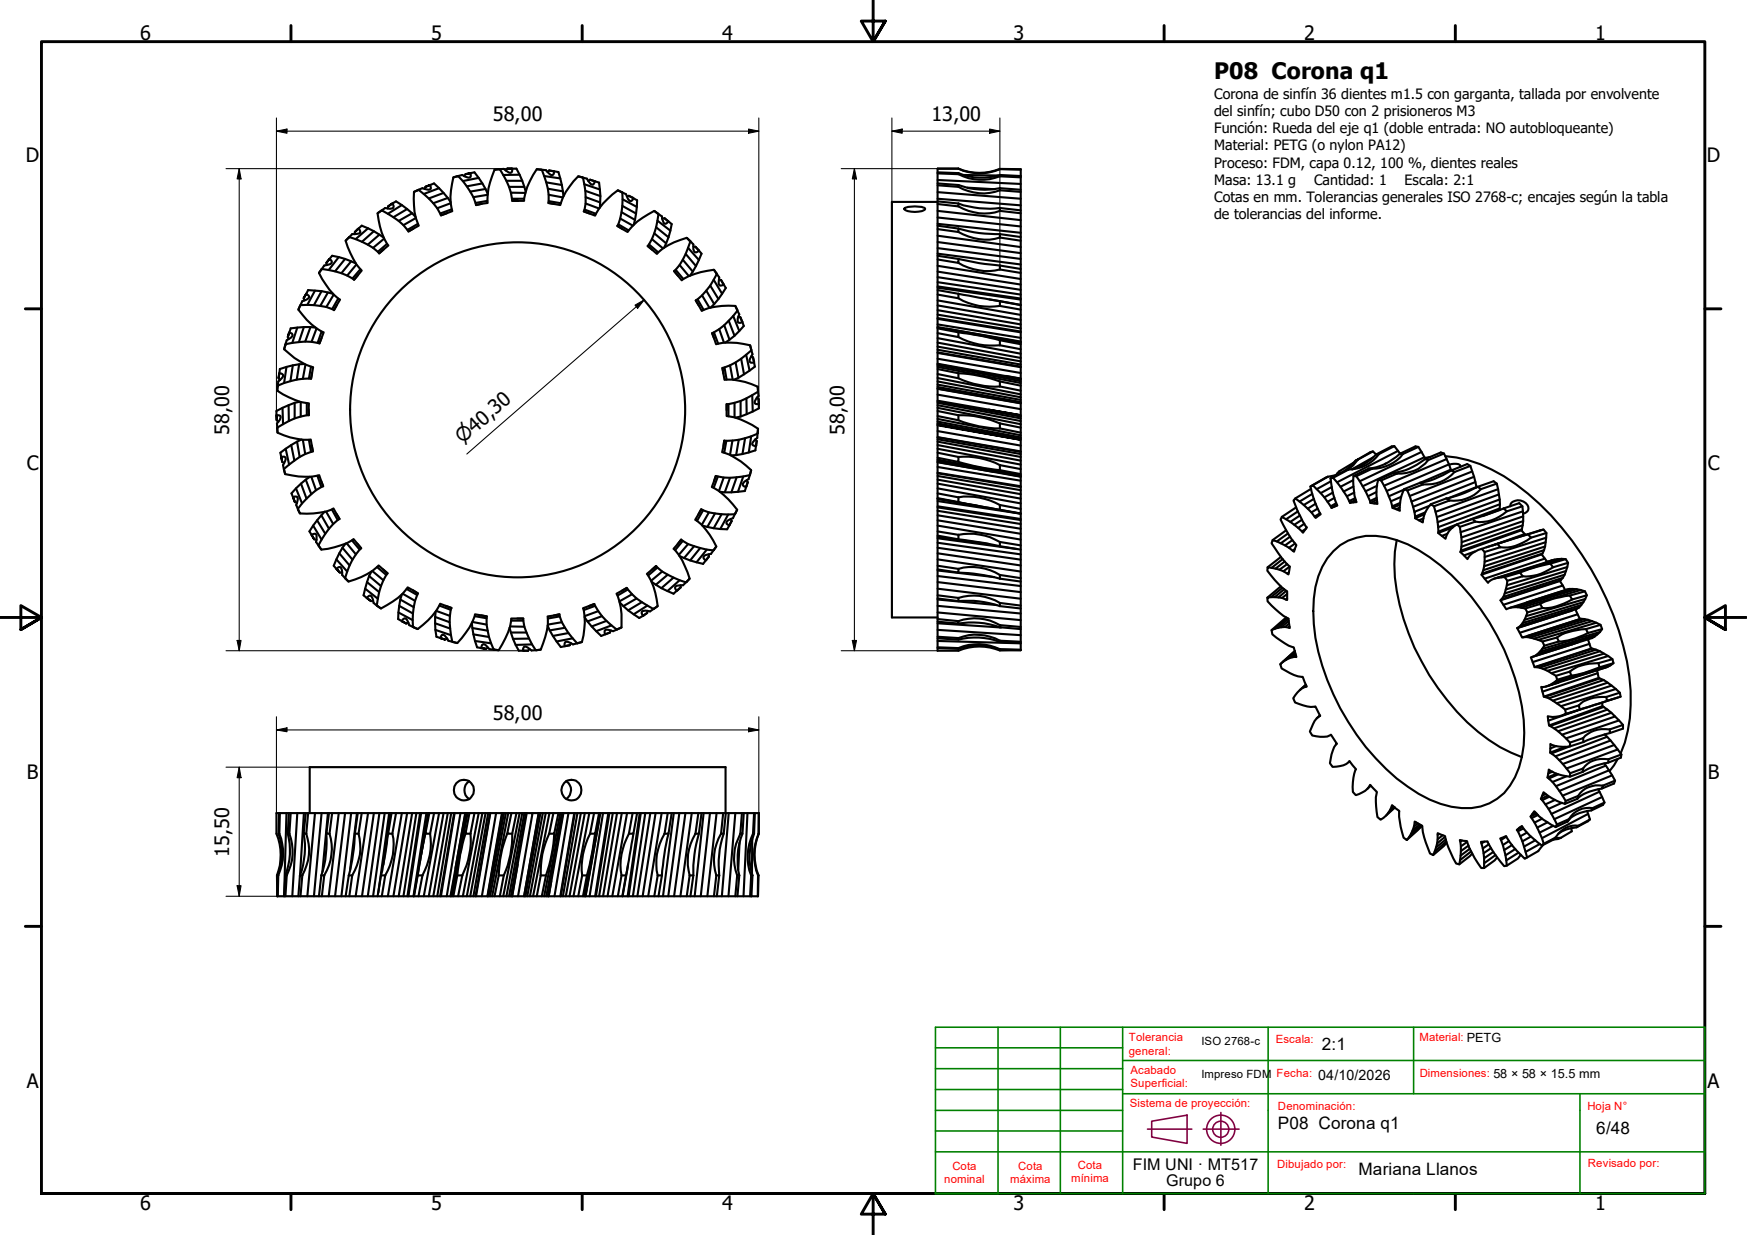
[picture p30: page 6]
Masa: 13.1 g; Cantidad: 1; Escala: 2:1

P08 Corona q1
Corona de sinfín 36 dientes m1.5 con garganta, tallada por envolvente
del sinfín; cubo D50 con 2 prisioneros M3
Función: Rueda del eje q1 (doble entrada: NO autobloqueante)
Material: PETG (o nylon PA12)
Proceso: FDM, capa 0.12, 100 %, dientes reales
Cotas en mm. Tolerancias generales ISO 2768-c; encajes según la tabla
de tolerancias del informe.

Tolerancia ISO 2768-c general: | Escala: 2:1 | Material: PETG

Acabado Impreso FDM Superficial: | Fecha: 04/10/2026 | Dimensiones: 58 × 58 × 15.5 mm

Sistema de proyección: | Denominación: P08 Corona q1 | Hoja N° 6/48

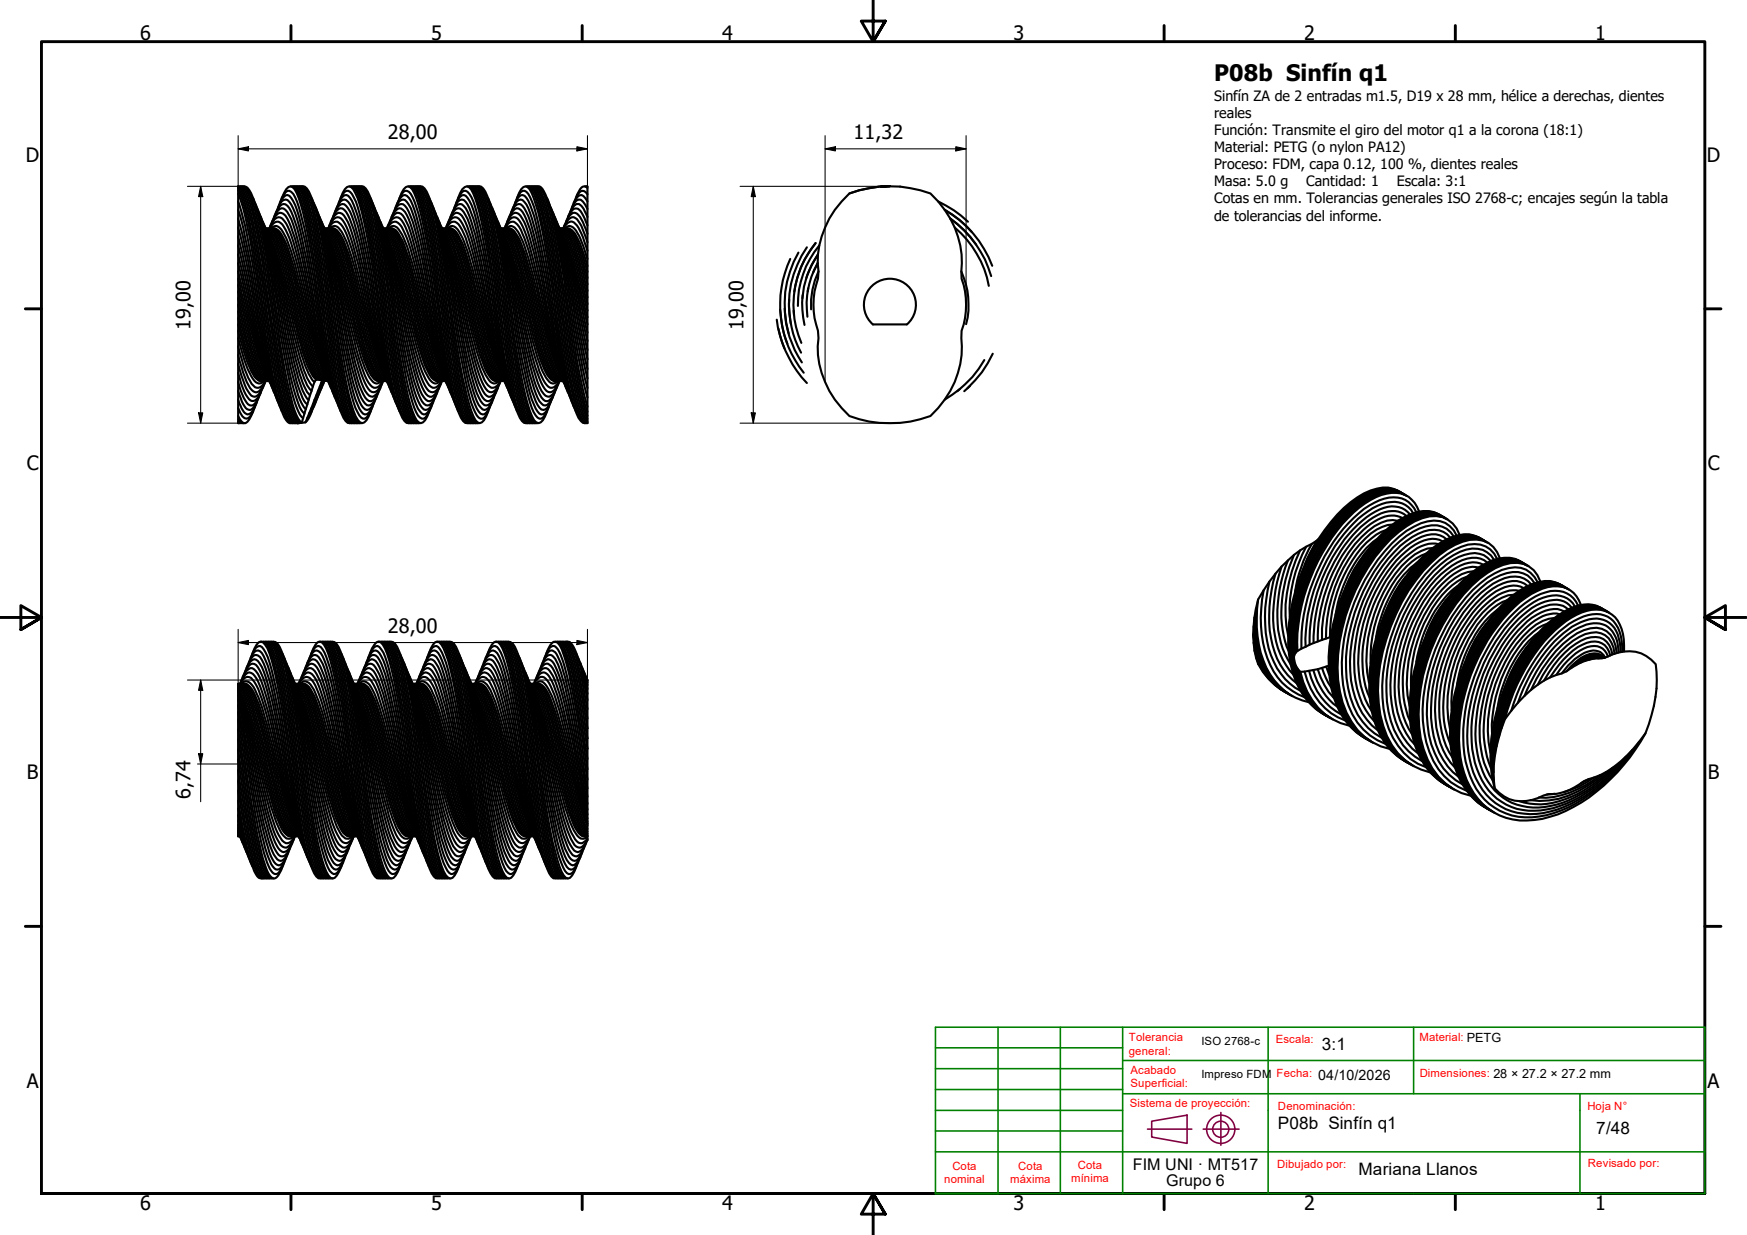
[picture p31: page 7]
P08b Sinfín q1; Masa: 5.0 g; Cantidad: 1; Escala: 3:1

Sinfín ZA de 2 entradas m1.5, D19 x 28 mm, hélice a derechas, dientes
reales
Función: Transmite el giro del motor q1 a la corona (18:1)
Material: PETG (o nylon PA12)
Proceso: FDM, capa 0.12, 100 %, dientes reales
Cotas en mm. Tolerancias generales ISO 2768-c; encajes según la tabla
de tolerancias del informe.

Tolerancia ISO 2768-c general: | Escala: 3:1 | Material: PETG

Acabado Impreso FDM Superficial: | Fecha: 04/10/2026 | Dimensiones: 28 × 27.2 × 27.2 mm

Sistema de proyección: | Denominación: P08b Sinfín q1 | Hoja N° 7/48

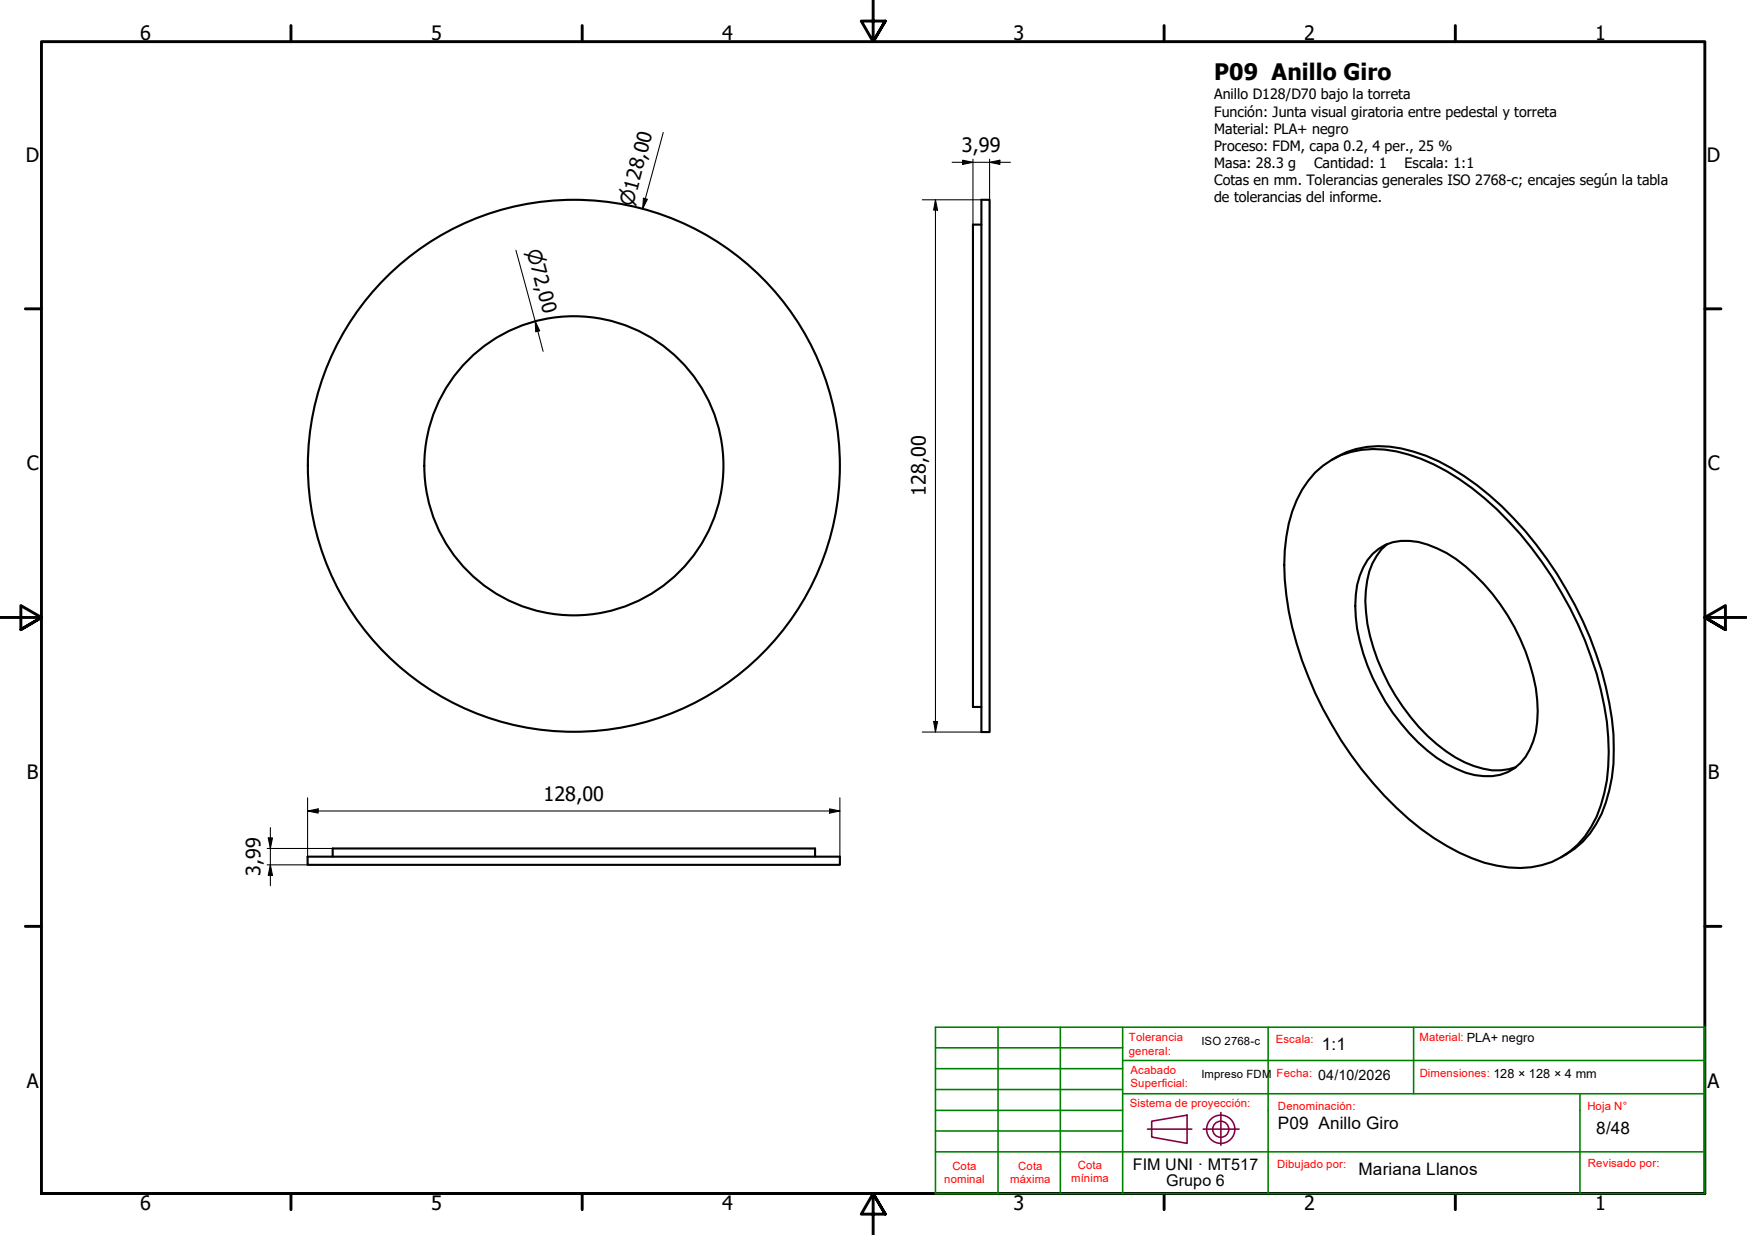
[picture p32: page 8]
Masa: 28.3 g; Cantidad: 1; Escala: 1:1

P09 Anillo Giro
Anillo D128/D70 bajo la torreta
Función: Junta visual giratoria entre pedestal y torreta
Material: PLA+ negro
Proceso: FDM, capa 0.2, 4 per., 25 %
Cotas en mm. Tolerancias generales ISO 2768-c; encajes según la tabla
de tolerancias del informe.

Tolerancia ISO 2768-c general: | Escala: 1:1 | Material: PLA+ negro

Acabado Impreso FDM Superficial: | Fecha: 04/10/2026 | Dimensiones: 128 × 128 × 4 mm

Sistema de proyección: | Denominación: P09 Anillo Giro | Hoja N° 8/48

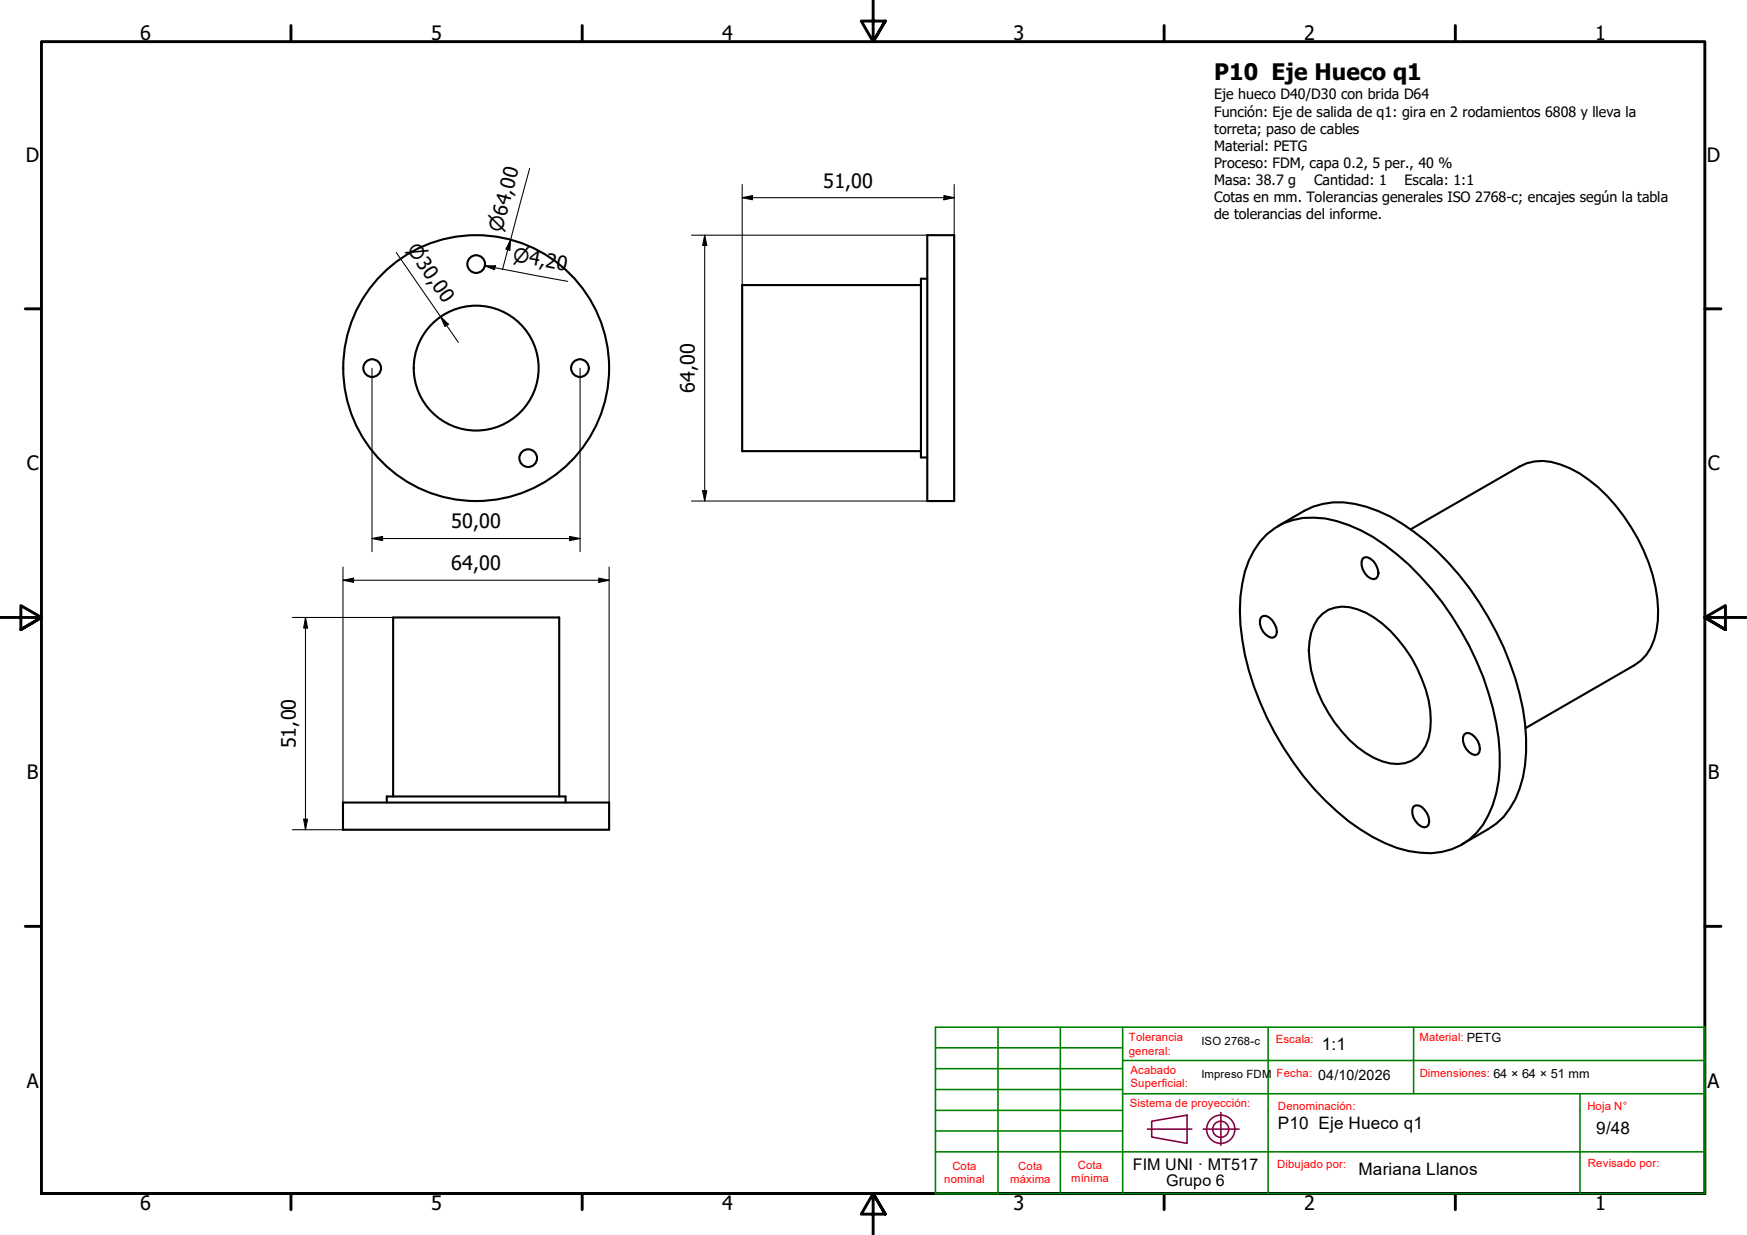
[picture p33: page 9]
Masa: 38.7 g; Cantidad: 1; Escala: 1:1

P10 Eje Hueco q1
Eje hueco D40/D30 con brida D64
Función: Eje de salida de q1: gira en 2 rodamientos 6808 y lleva la
torreta; paso de cables
Material: PETG
Proceso: FDM, capa 0.2, 5 per., 40 %
Cotas en mm. Tolerancias generales ISO 2768-c; encajes según la tabla
de tolerancias del informe.

Tolerancia ISO 2768-c general: | Escala: 1:1 | Material: PETG

Acabado Impreso FDM Superficial: | Fecha: 04/10/2026 | Dimensiones: 64 × 64 × 51 mm

Sistema de proyección: | Denominación: P10 Eje Hueco q1 | Hoja N° 9/48

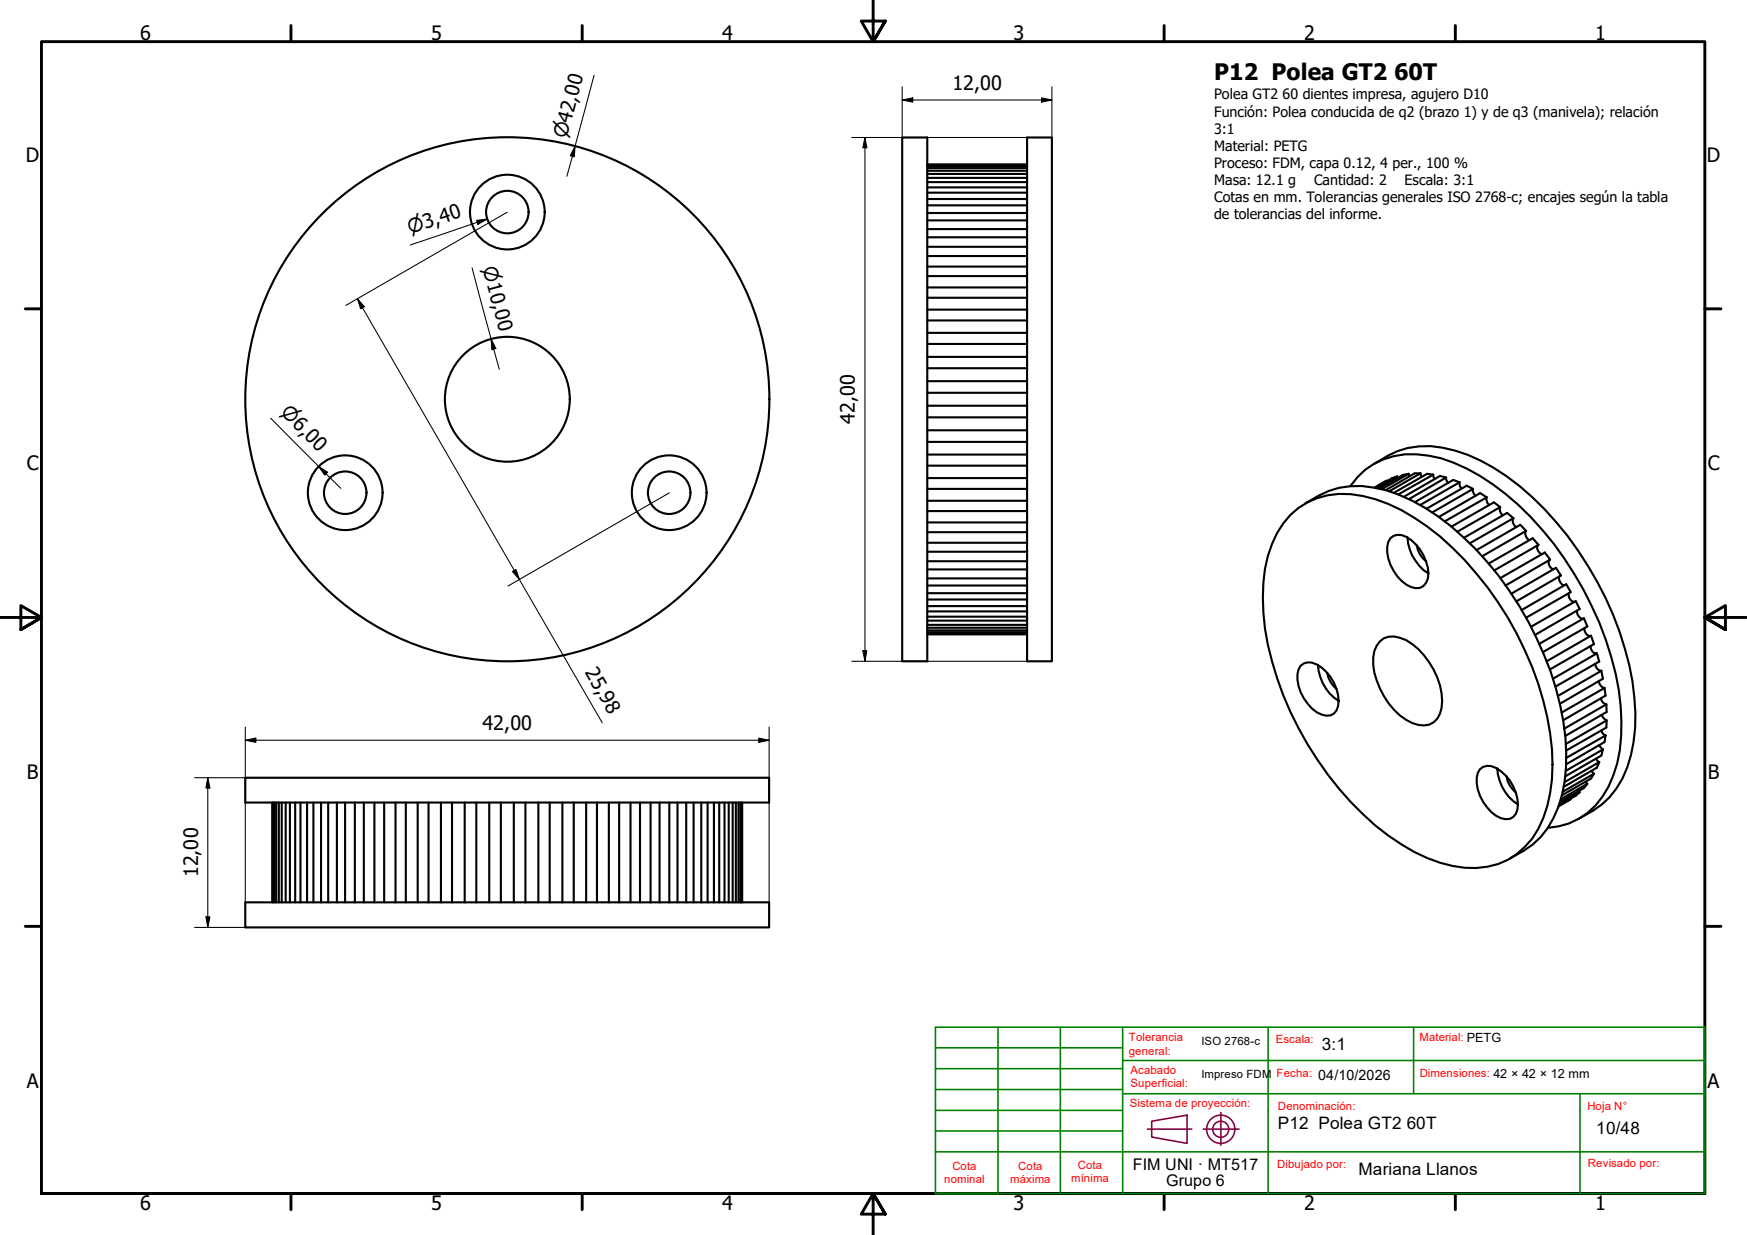
[picture p34: page 10]
Masa: 12.1 g; Cantidad: 2; Escala: 3:1

P12 Polea GT2 60T
Polea GT2 60 dientes impresa, agujero D10
Función: Polea conducida de q2 (brazo 1) y de q3 (manivela); relación
Material: PETG
Proceso: FDM, capa 0.12, 4 per., 100 %
Cotas en mm. Tolerancias generales ISO 2768-c; encajes según la tabla
de tolerancias del informe.

Tolerancia ISO 2768-c general: | Escala: 3:1 | Material: PETG

Acabado Impreso FDM Superficial: | Fecha: 04/10/2026 | Dimensiones: 42 × 42 × 12 mm

Sistema de proyección: | Denominación: P12 Polea GT2 60T | Hoja N° 10/48

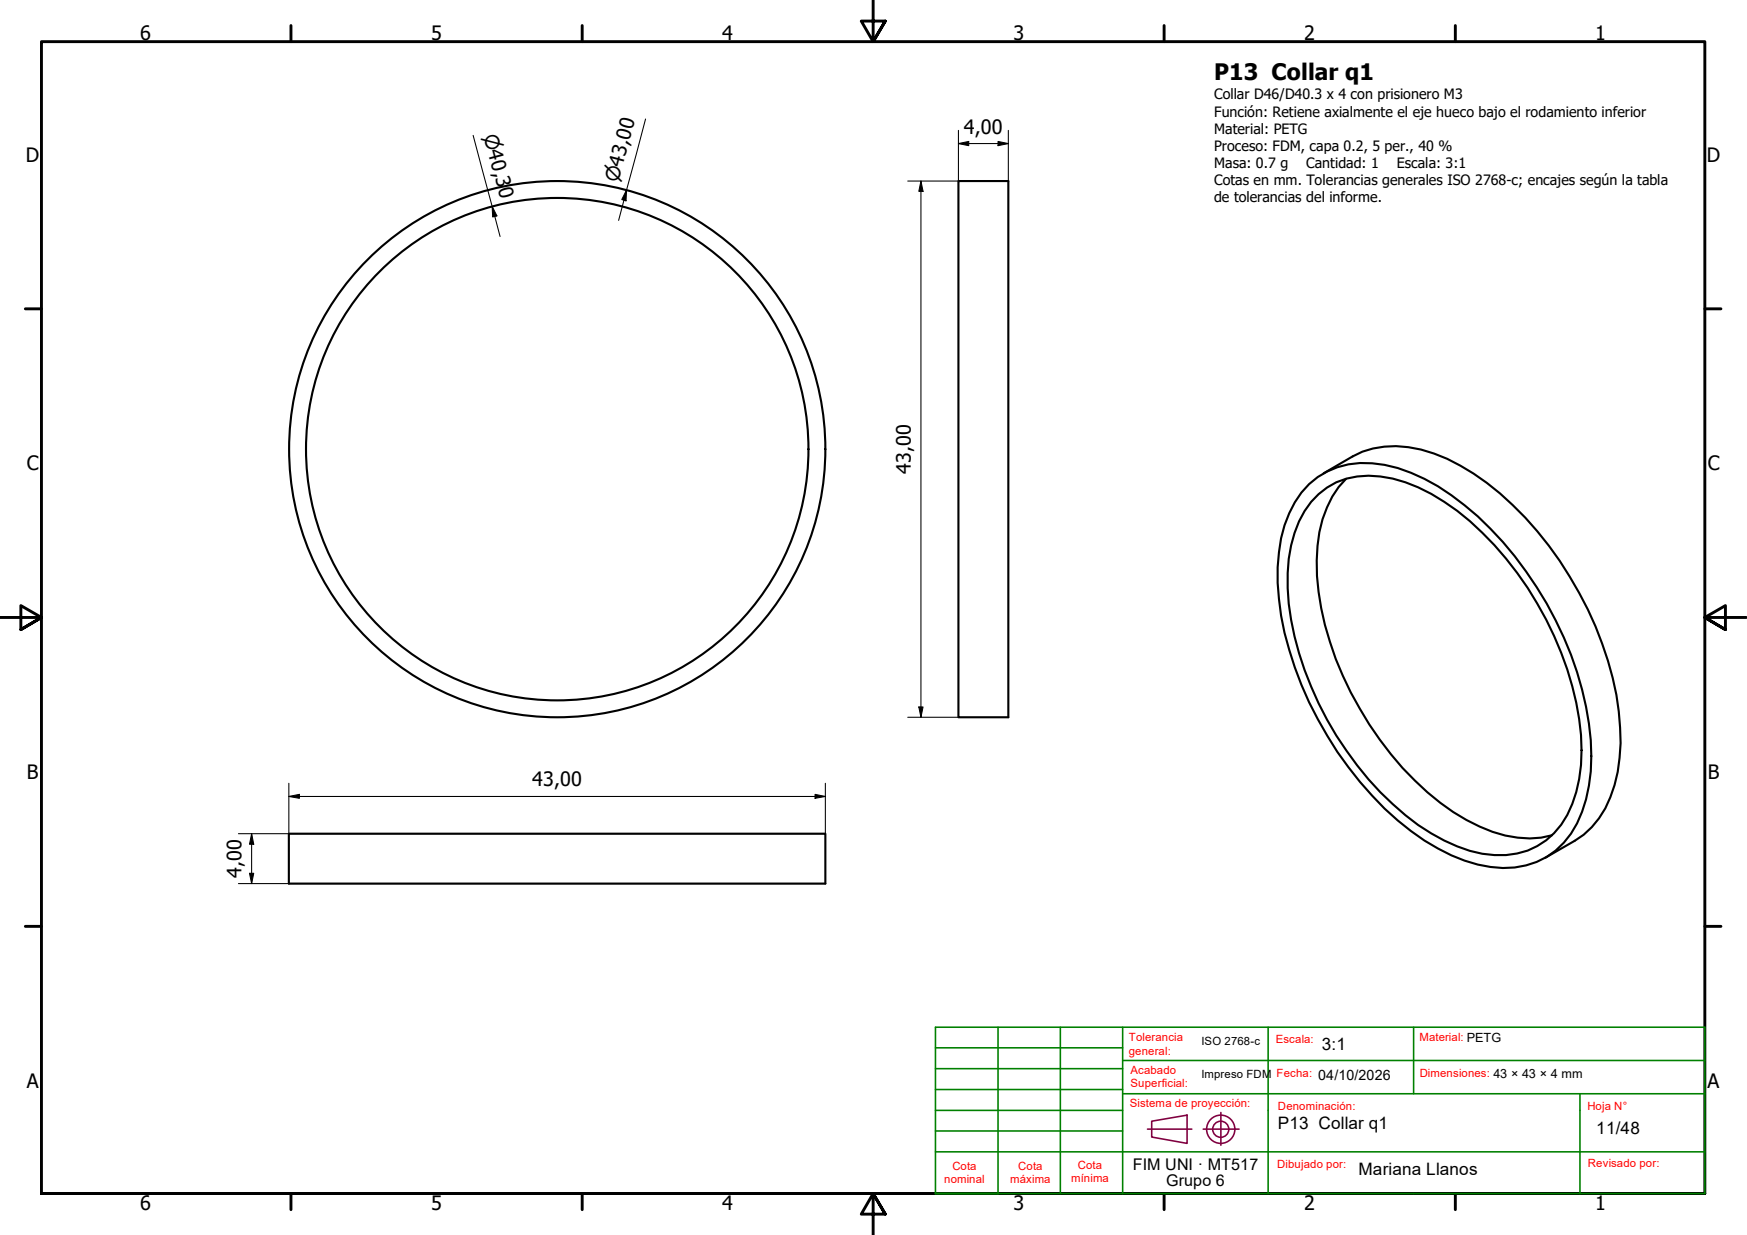
[picture p35: page 11]
Masa: 0.7 g; Cantidad: 1; Escala: 3:1

P13 Collar q1
Collar D46/D40.3 x 4 con prisionero M3
Función: Retiene axialmente el eje hueco bajo el rodamiento inferior
Material: PETG
Proceso: FDM, capa 0.2, 5 per., 40 %
Cotas en mm. Tolerancias generales ISO 2768-c; encajes según la tabla
de tolerancias del informe.

Tolerancia ISO 2768-c general: | Escala: 3:1 | Material: PETG

Acabado Impreso FDM Superficial: | Fecha: 04/10/2026 | Dimensiones: 43 × 43 × 4 mm

Sistema de proyección: | Denominación: P13 Collar q1 | Hoja N° 11/48

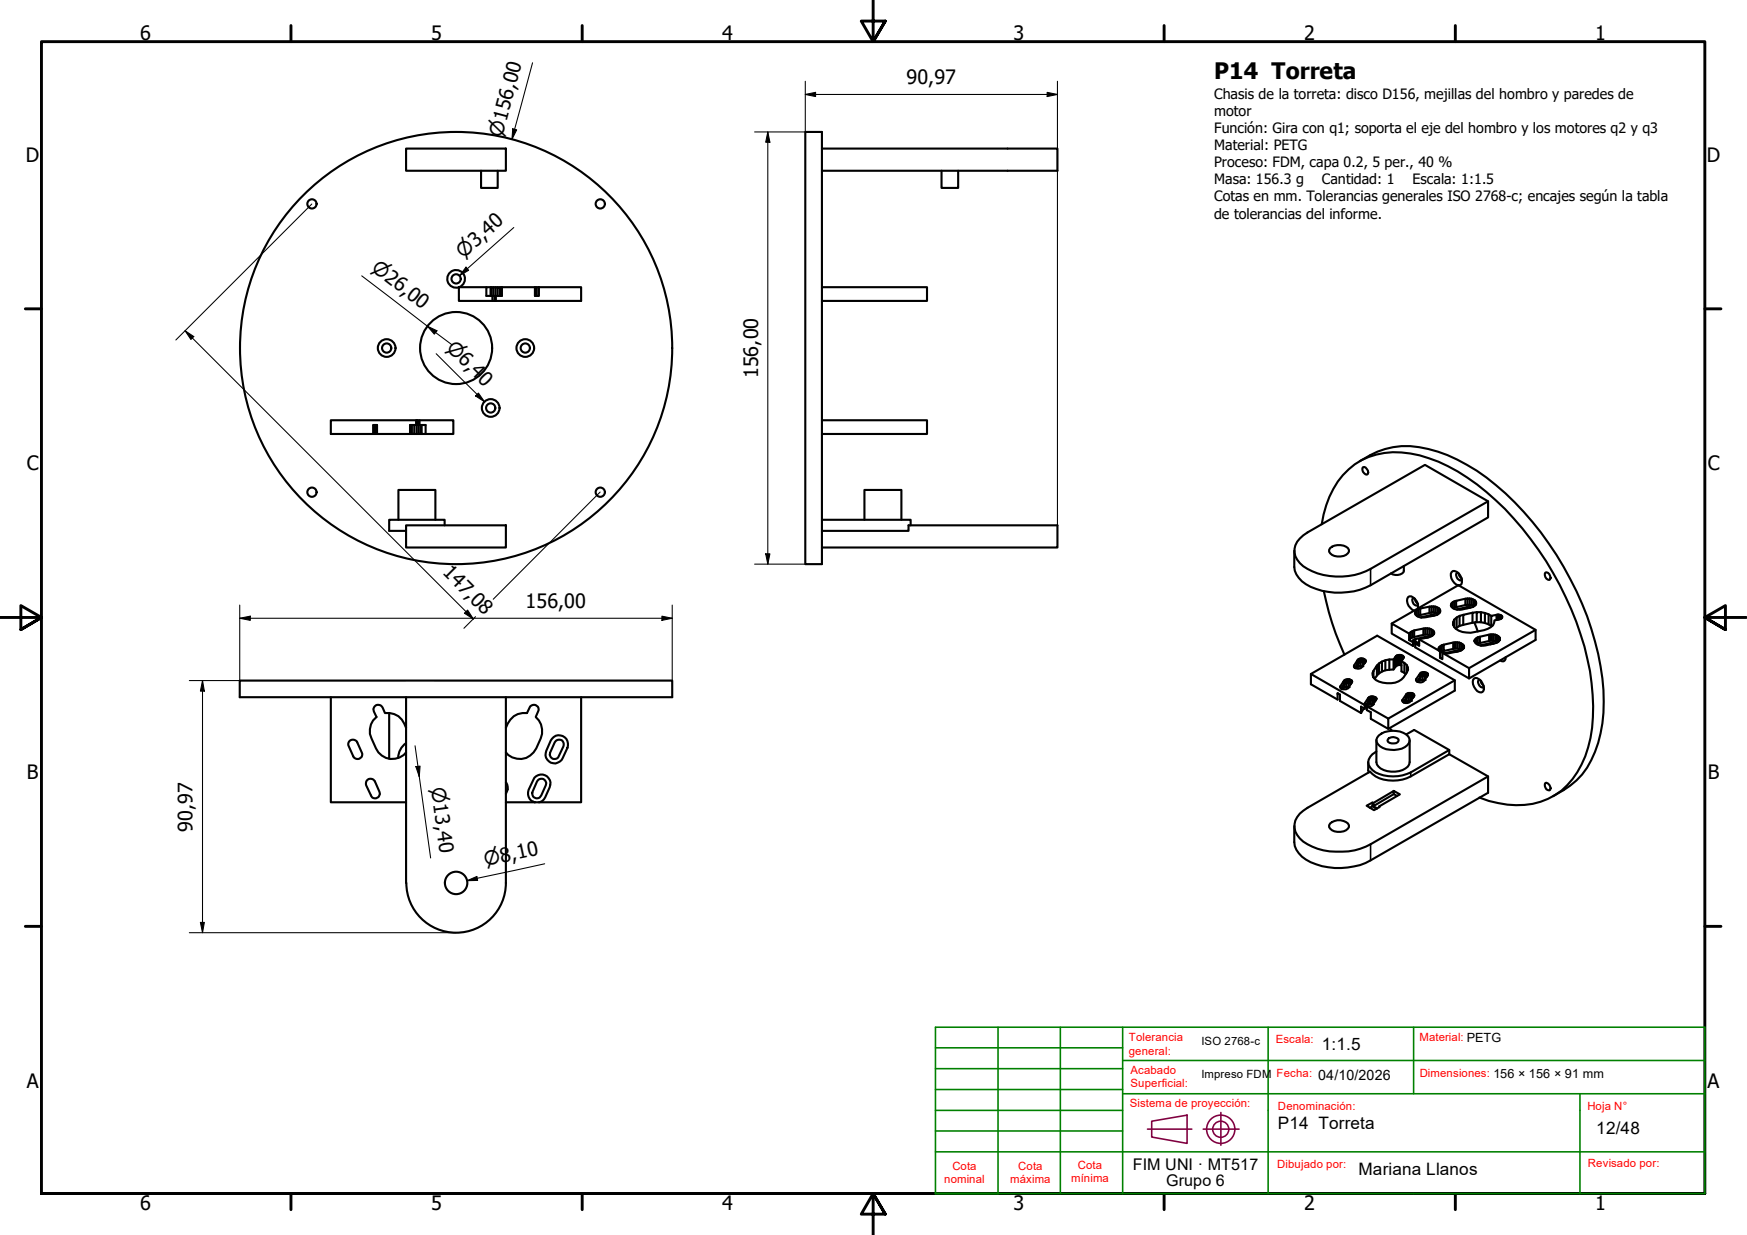
[picture p36: page 12]
Masa: 156.3 g; Cantidad: 1; Escala: 1:1.5

P14 Torreta
Chasis de la torreta: disco D156, mejillas del hombro y paredes de
motor
Función: Gira con q1; soporta el eje del hombro y los motores q2 y q3
Material: PETG
Proceso: FDM, capa 0.2, 5 per., 40 %
Cotas en mm. Tolerancias generales ISO 2768-c; encajes según la tabla
de tolerancias del informe.

Tolerancia ISO 2768-c general: | Escala: 1:1.5 | Material: PETG

Acabado Impreso FDM Superficial: | Fecha: 04/10/2026 | Dimensiones: 156 × 156 × 91 mm

Sistema de proyección: | Denominación: P14 Torreta | Hoja N° 12/48

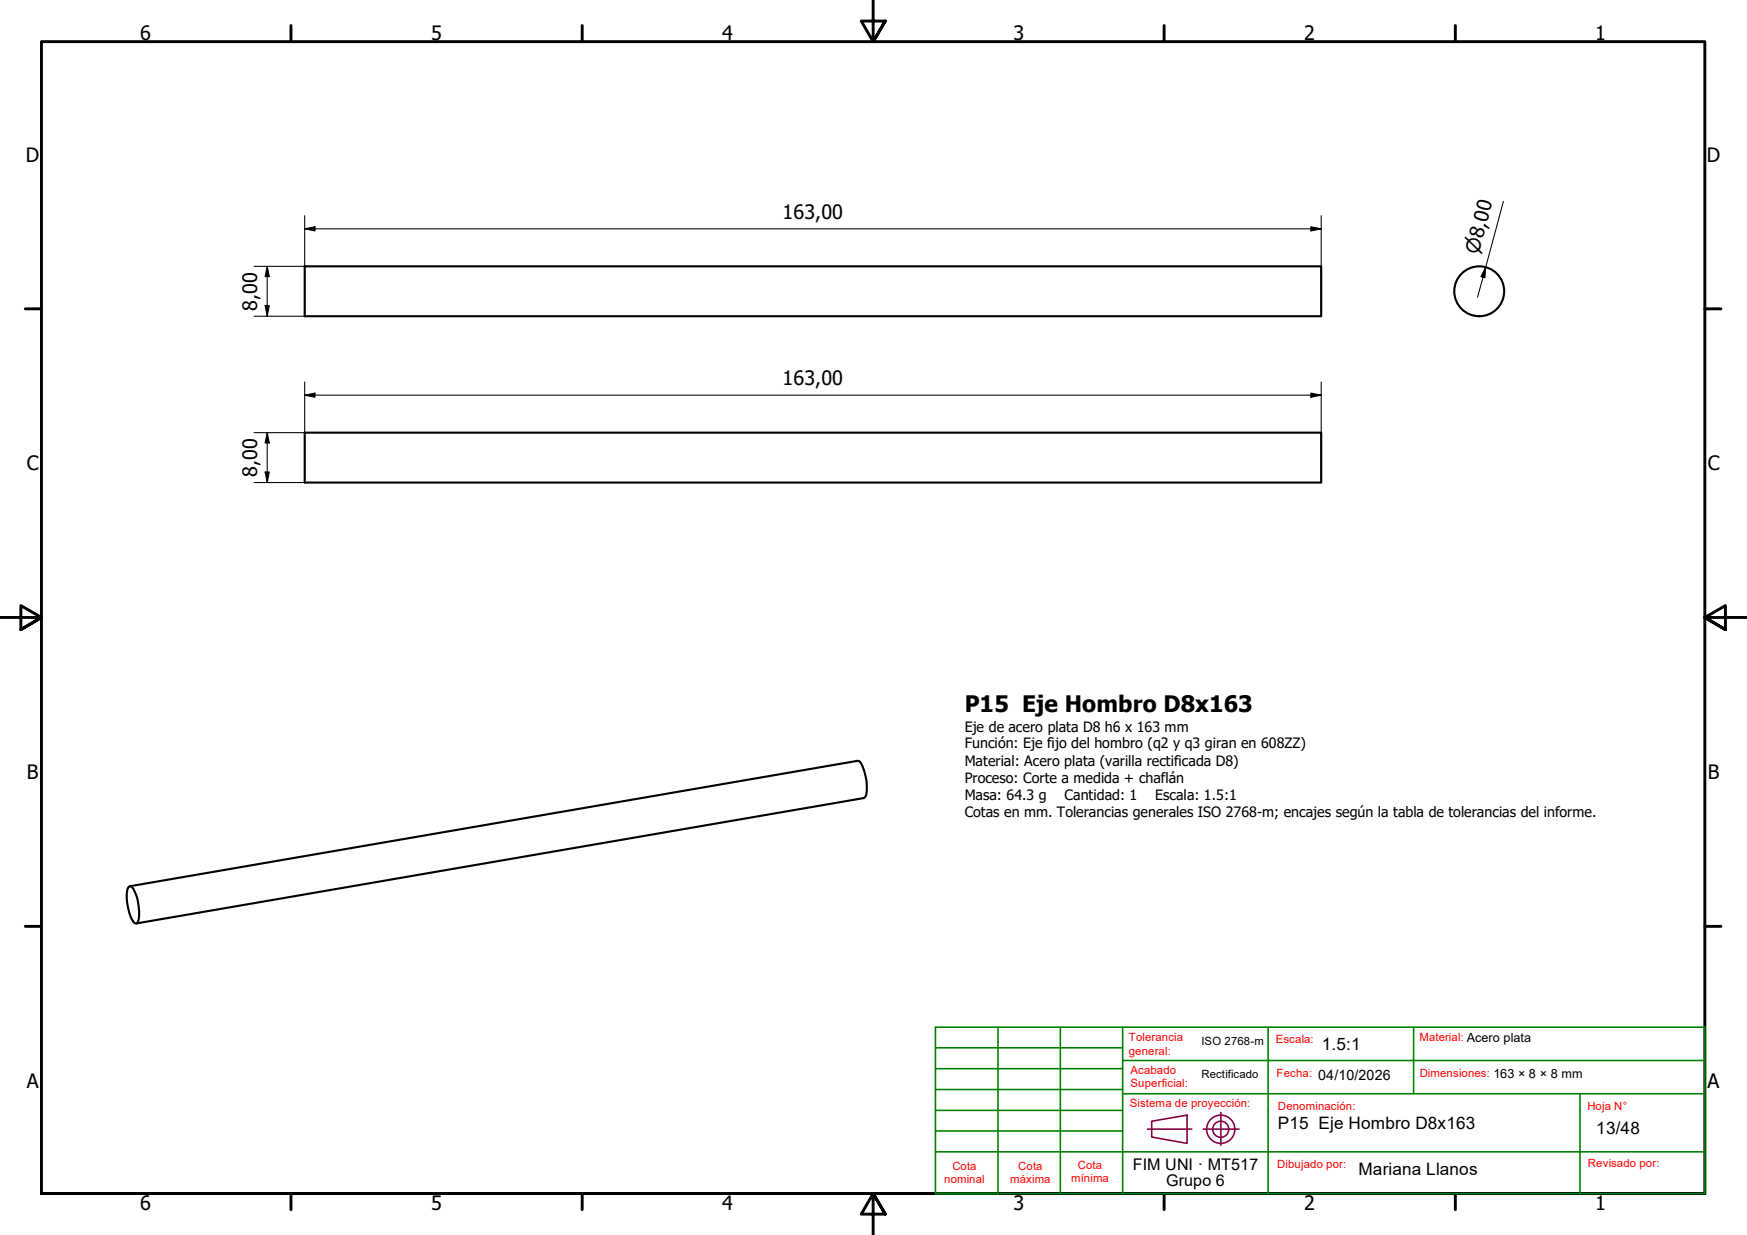
[picture p37: page 13]
Masa: 64.3 g; Cantidad: 1; Escala: 1.5:1

P15 Eje Hombro D8x163
Eje de acero plata D8 h6 x 163 mm
Función: Eje fijo del hombro (q2 y q3 giran en 608ZZ)
Material: Acero plata (varilla rectificada D8)
Proceso: Corte a medida + chaflán
Cotas en mm. Tolerancias generales ISO 2768-m; encajes según la tabla de tolerancias del informe.

Tolerancia ISO 2768-m general: | Escala: 1.5:1 | Material: Acero plata

Acabado Rectificado Superficial: | Fecha: 04/10/2026 | Dimensiones: 163 × 8 × 8 mm

Sistema de proyección: | Denominación: P15 Eje Hombro D8x163 | Hoja N° 13/48

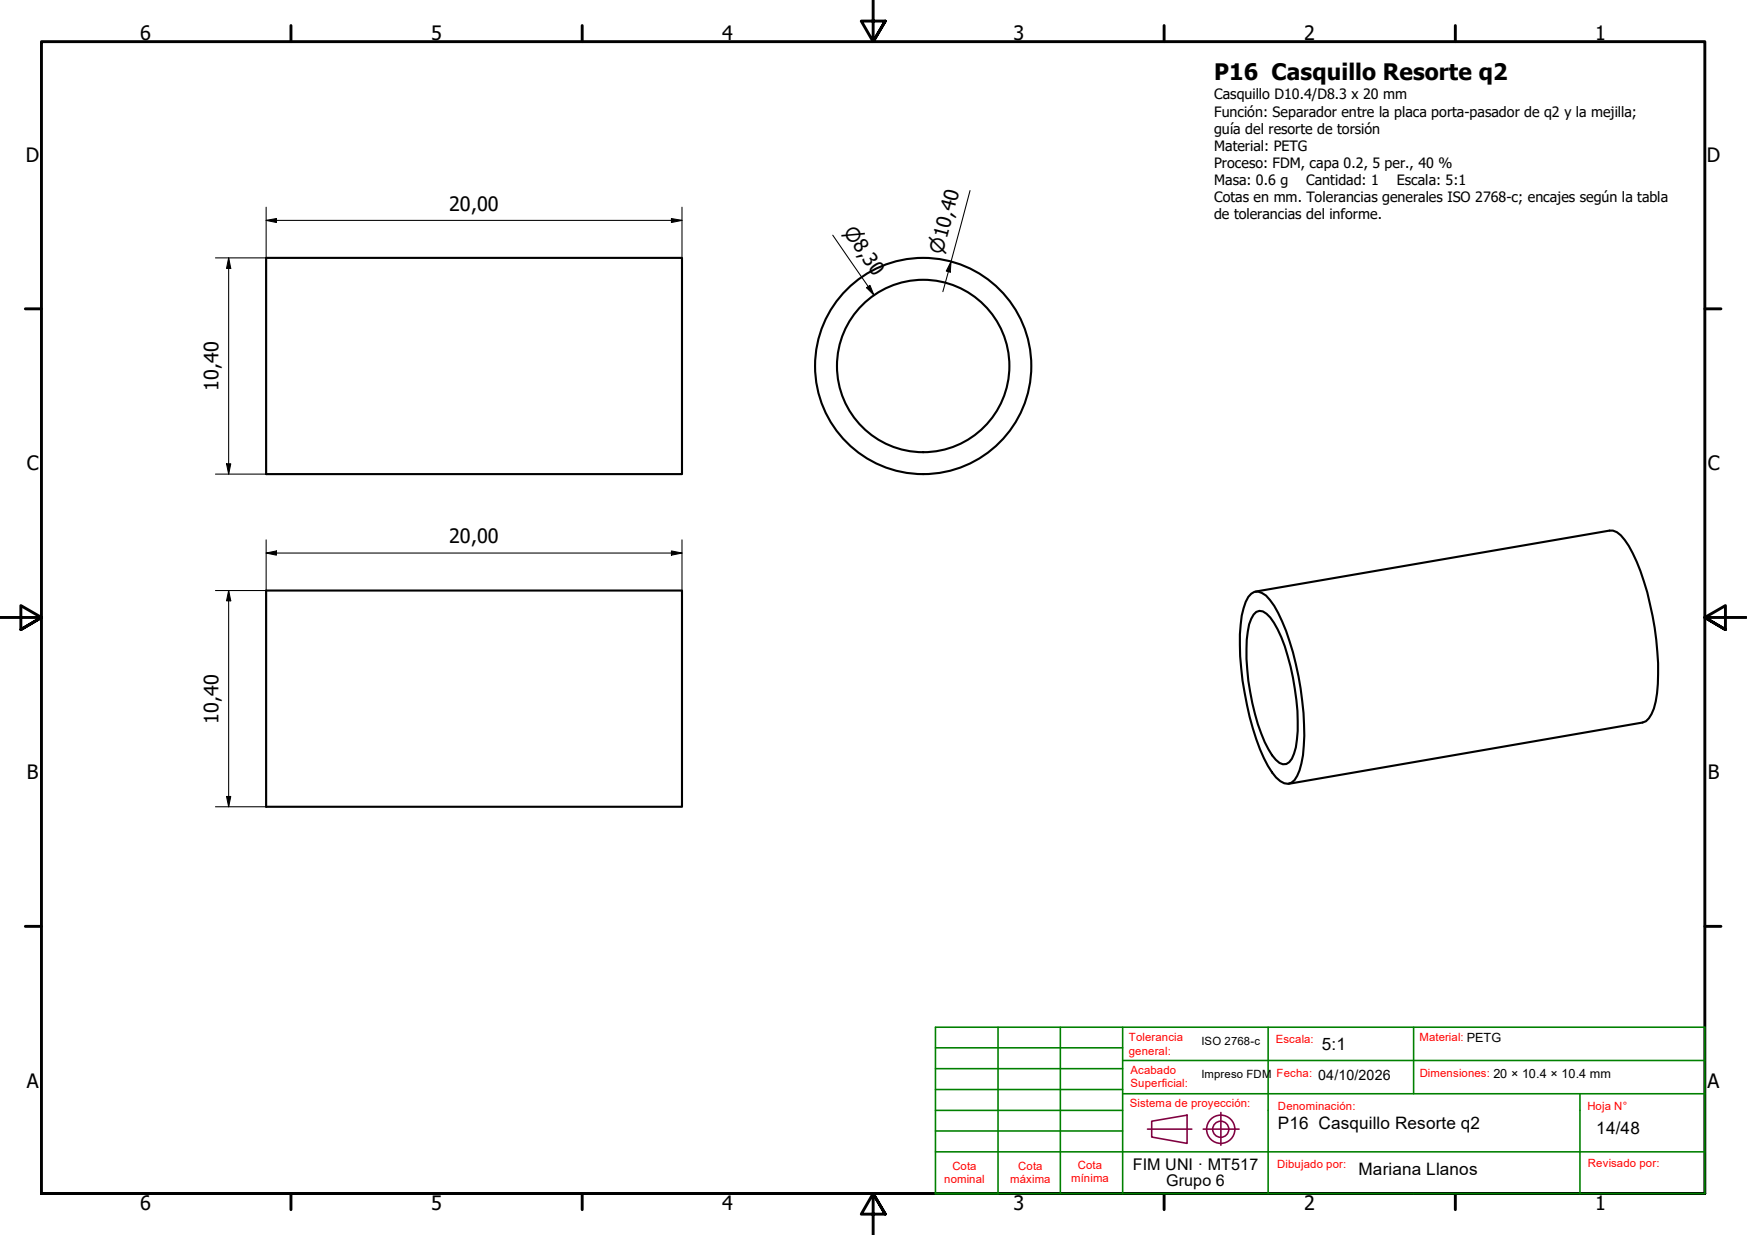
[picture p38: page 14]
Masa: 0.6 g; Cantidad: 1; Escala: 5:1

P16 Casquillo Resorte q2
Casquillo D10.4/D8.3 x 20 mm
Función: Separador entre la placa porta-pasador de q2 y la mejilla;
guía del resorte de torsión
Material: PETG
Proceso: FDM, capa 0.2, 5 per., 40 %
Cotas en mm. Tolerancias generales ISO 2768-c; encajes según la tabla
de tolerancias del informe.

Tolerancia ISO 2768-c general: | Escala: 5:1 | Material: PETG

Acabado Impreso FDM Superficial: | Fecha: 04/10/2026 | Dimensiones: 20 × 10.4 × 10.4 mm

Sistema de proyección: | Denominación: P16 Casquillo Resorte q2 | Hoja N° 14/48

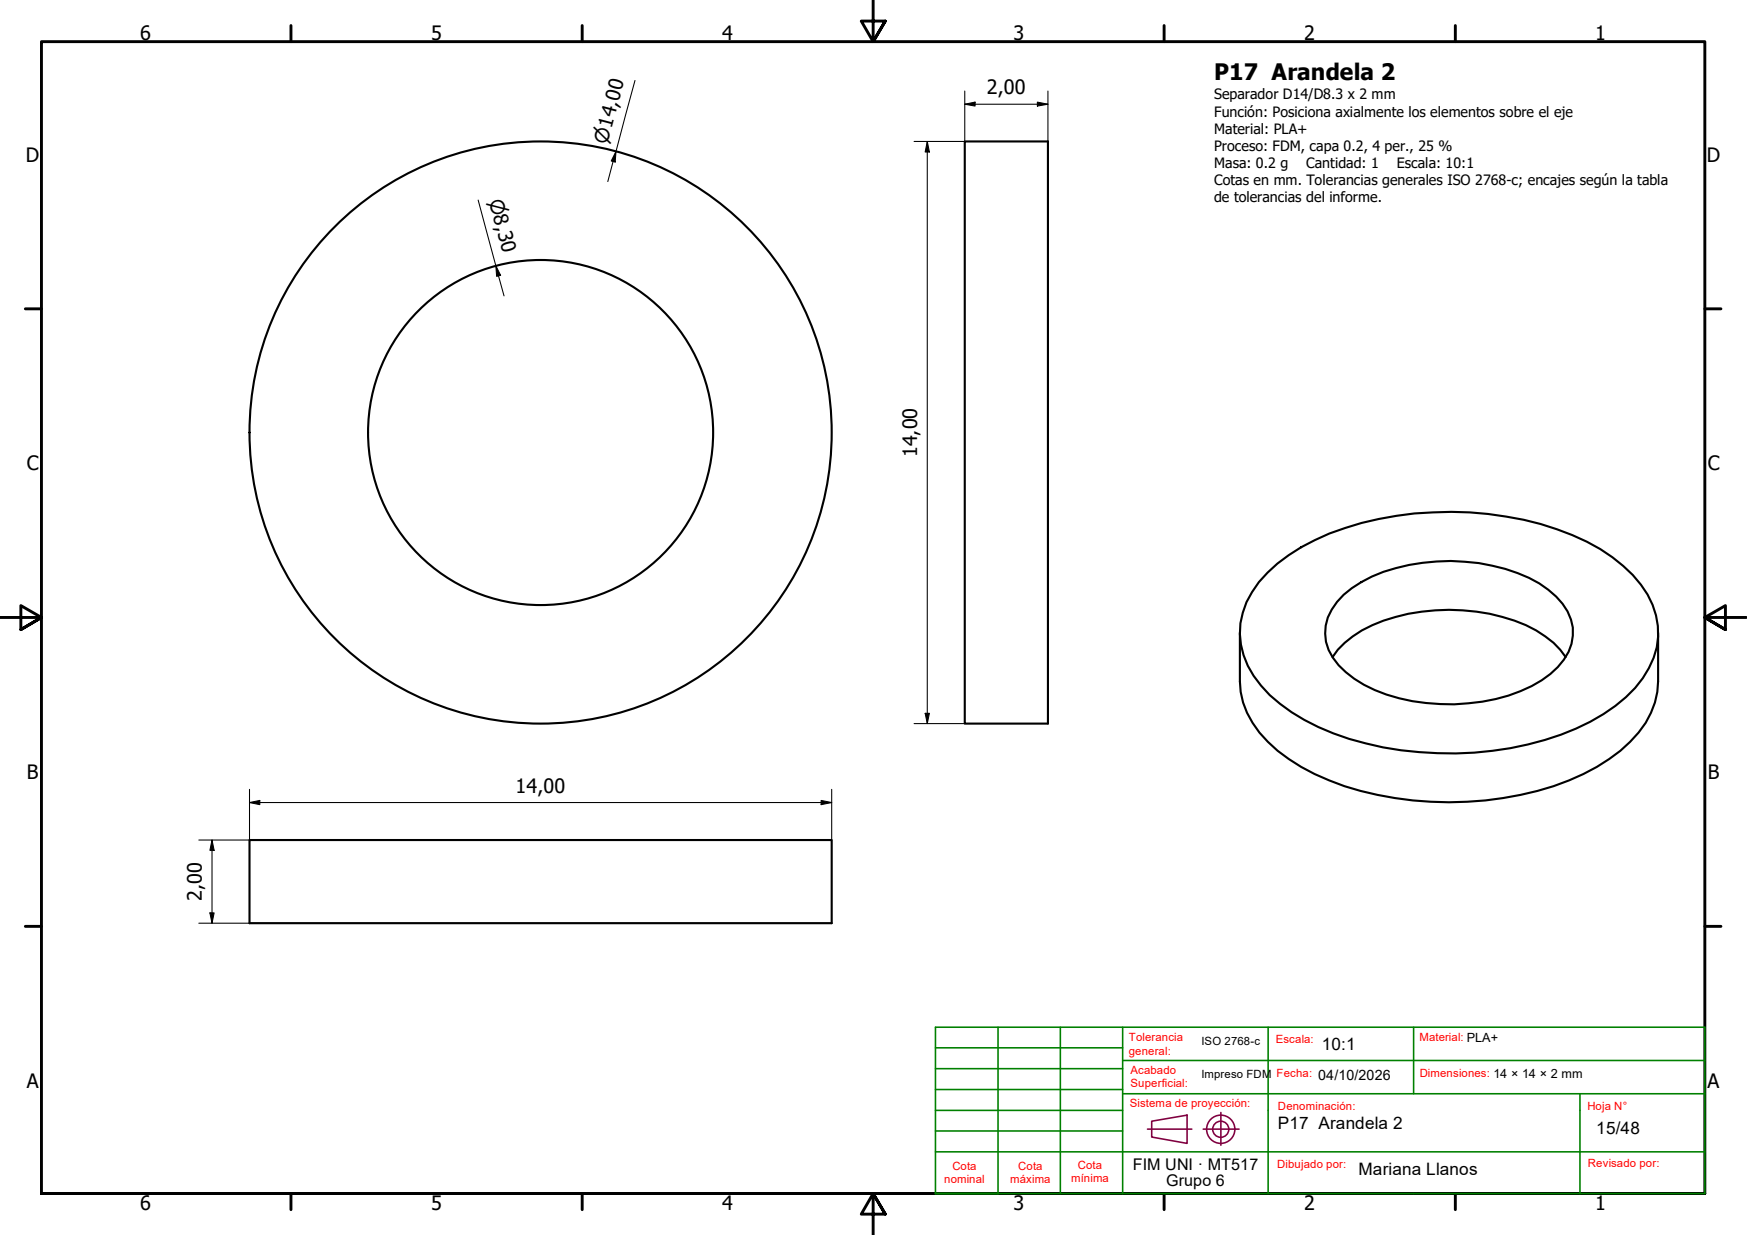
[picture p39: page 15]
Masa: 0.2 g; Cantidad: 1; Escala: 10:1

P17 Arandela 2
Separador D14/D8.3 x 2 mm
Función: Posiciona axialmente los elementos sobre el eje
Material: PLA+
Proceso: FDM, capa 0.2, 4 per., 25 %
Cotas en mm. Tolerancias generales ISO 2768-c; encajes según la tabla
de tolerancias del informe.

Tolerancia ISO 2768-c general: | Escala: 10:1 | Material: PLA+

Acabado Impreso FDM Superficial: | Fecha: 04/10/2026 | Dimensiones: 14 × 14 × 2 mm

Sistema de proyección: | Denominación: P17 Arandela 2 | Hoja N° 15/48

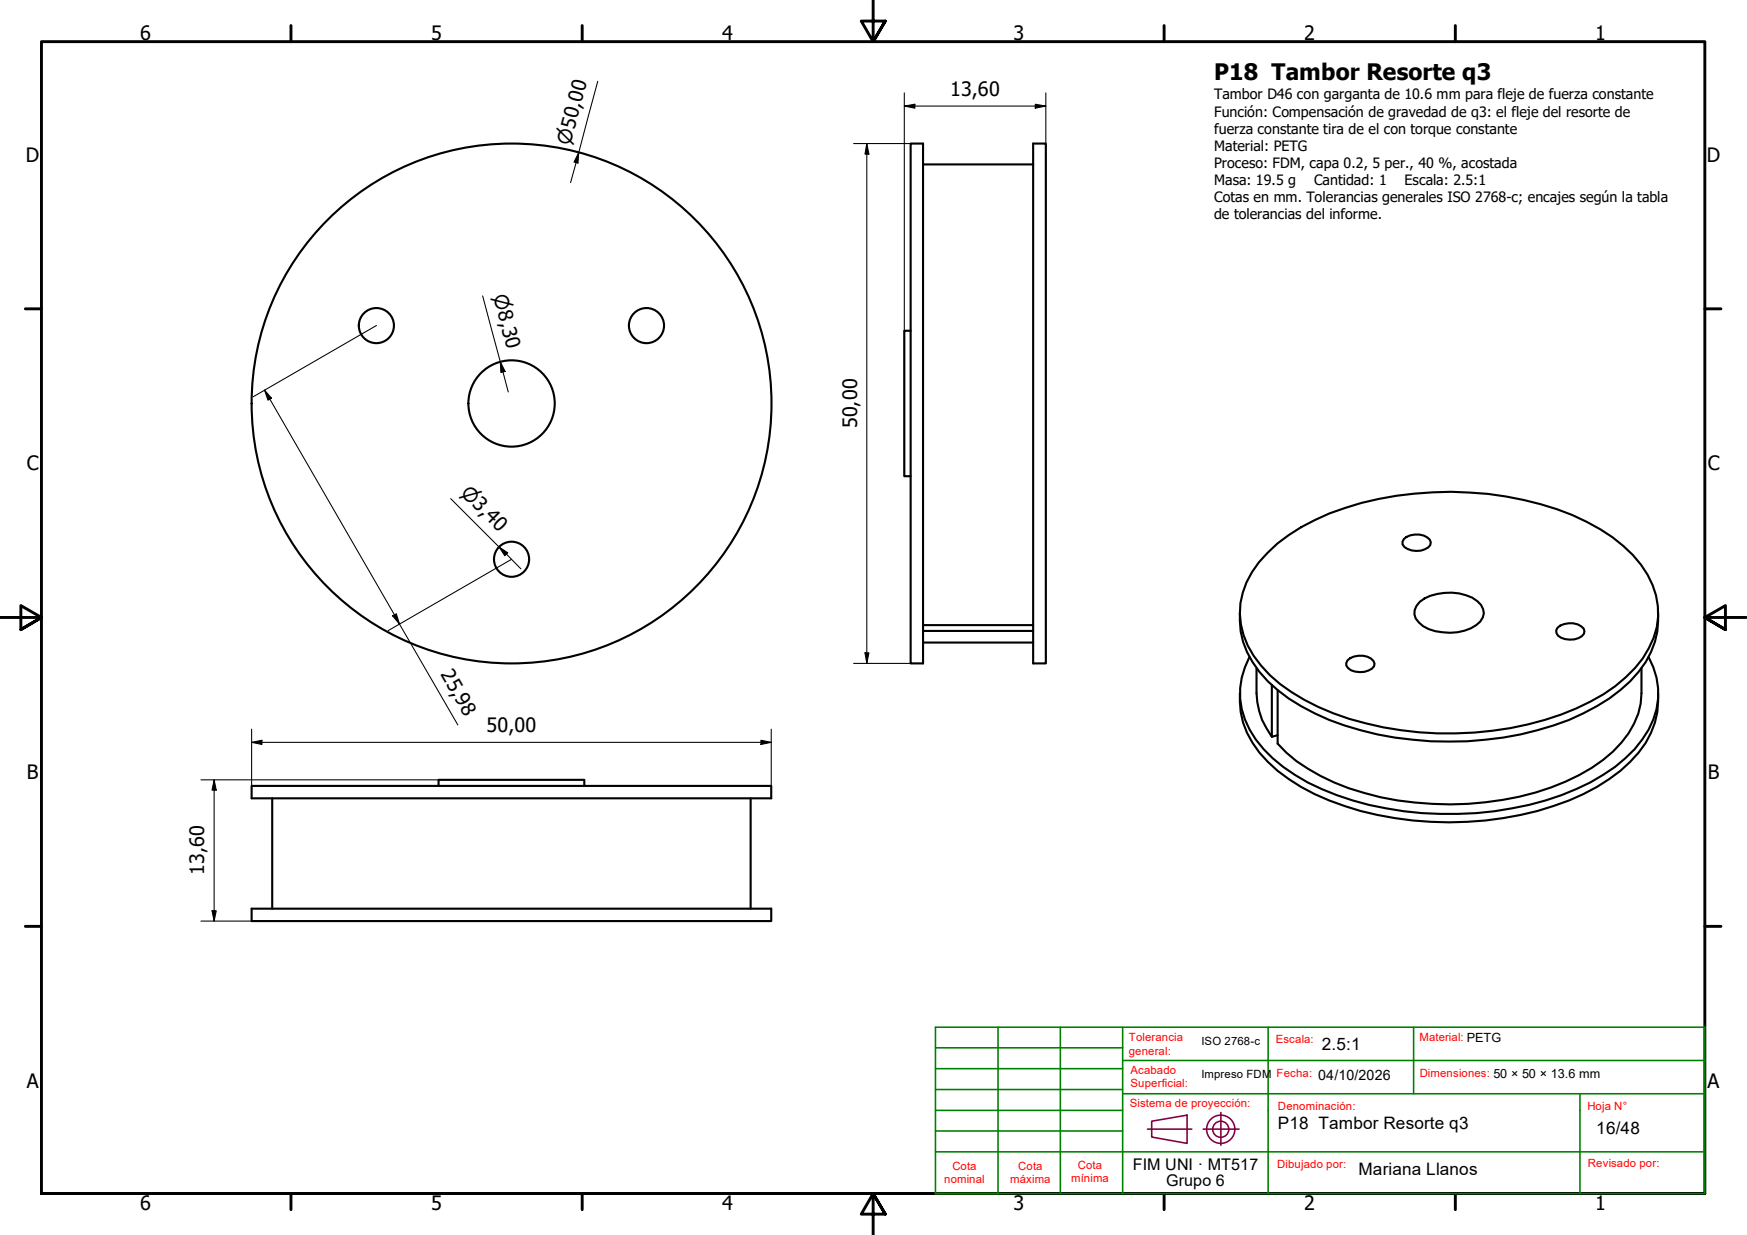
[picture p40: page 16]
Masa: 19.5 g; Cantidad: 1; Escala: 2.5:1

P18 Tambor Resorte q3
Tambor D46 con garganta de 10.6 mm para fleje de fuerza constante
Función: Compensación de gravedad de q3: el fleje del resorte de
fuerza constante tira de el con torque constante
Material: PETG
Proceso: FDM, capa 0.2, 5 per., 40 %, acostada
Cotas en mm. Tolerancias generales ISO 2768-c; encajes según la tabla
de tolerancias del informe.

Tolerancia ISO 2768-c general: | Escala: 2.5:1 | Material: PETG

Acabado Impreso FDM Superficial: | Fecha: 04/10/2026 | Dimensiones: 50 × 50 × 13.6 mm

Sistema de proyección: | Denominación: P18 Tambor Resorte q3 | Hoja N° 16/48

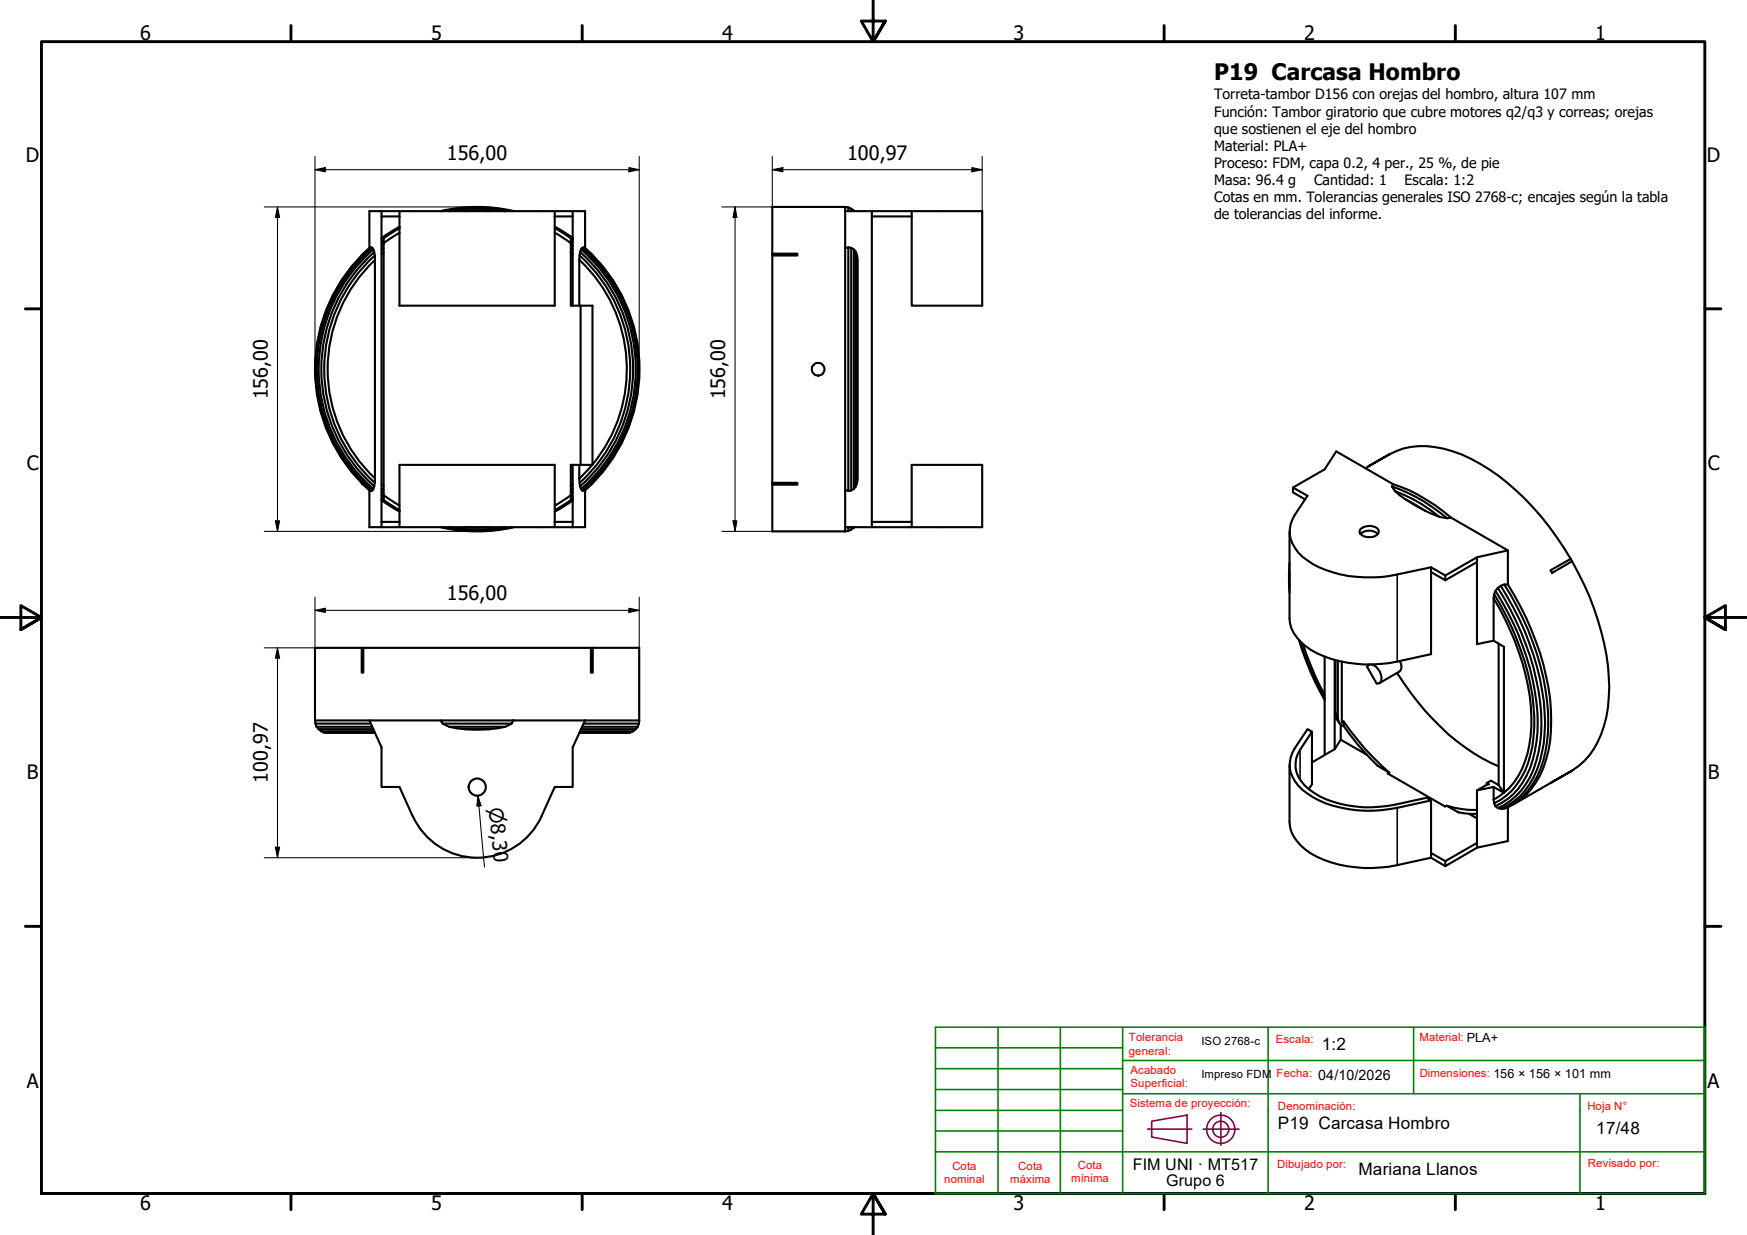
[picture p41: page 17]
Masa: 96.4 g; Cantidad: 1; Escala: 1:2

P19 Carcasa Hombro
Torreta-tambor D156 con orejas del hombro, altura 107 mm
Función: Tambor giratorio que cubre motores q2/q3 y correas; orejas
que sostienen el eje del hombro
Material: PLA+
Proceso: FDM, capa 0.2, 4 per., 25 %, de pie
Cotas en mm. Tolerancias generales ISO 2768-c; encajes según la tabla
de tolerancias del informe.

Tolerancia ISO 2768-c general: | Escala: 1:2 | Material: PLA+

Acabado Impreso FDM Superficial: | Fecha: 04/10/2026 | Dimensiones: 156 × 156 × 101 mm

Sistema de proyección: | Denominación: P19 Carcasa Hombro | Hoja N° 17/48

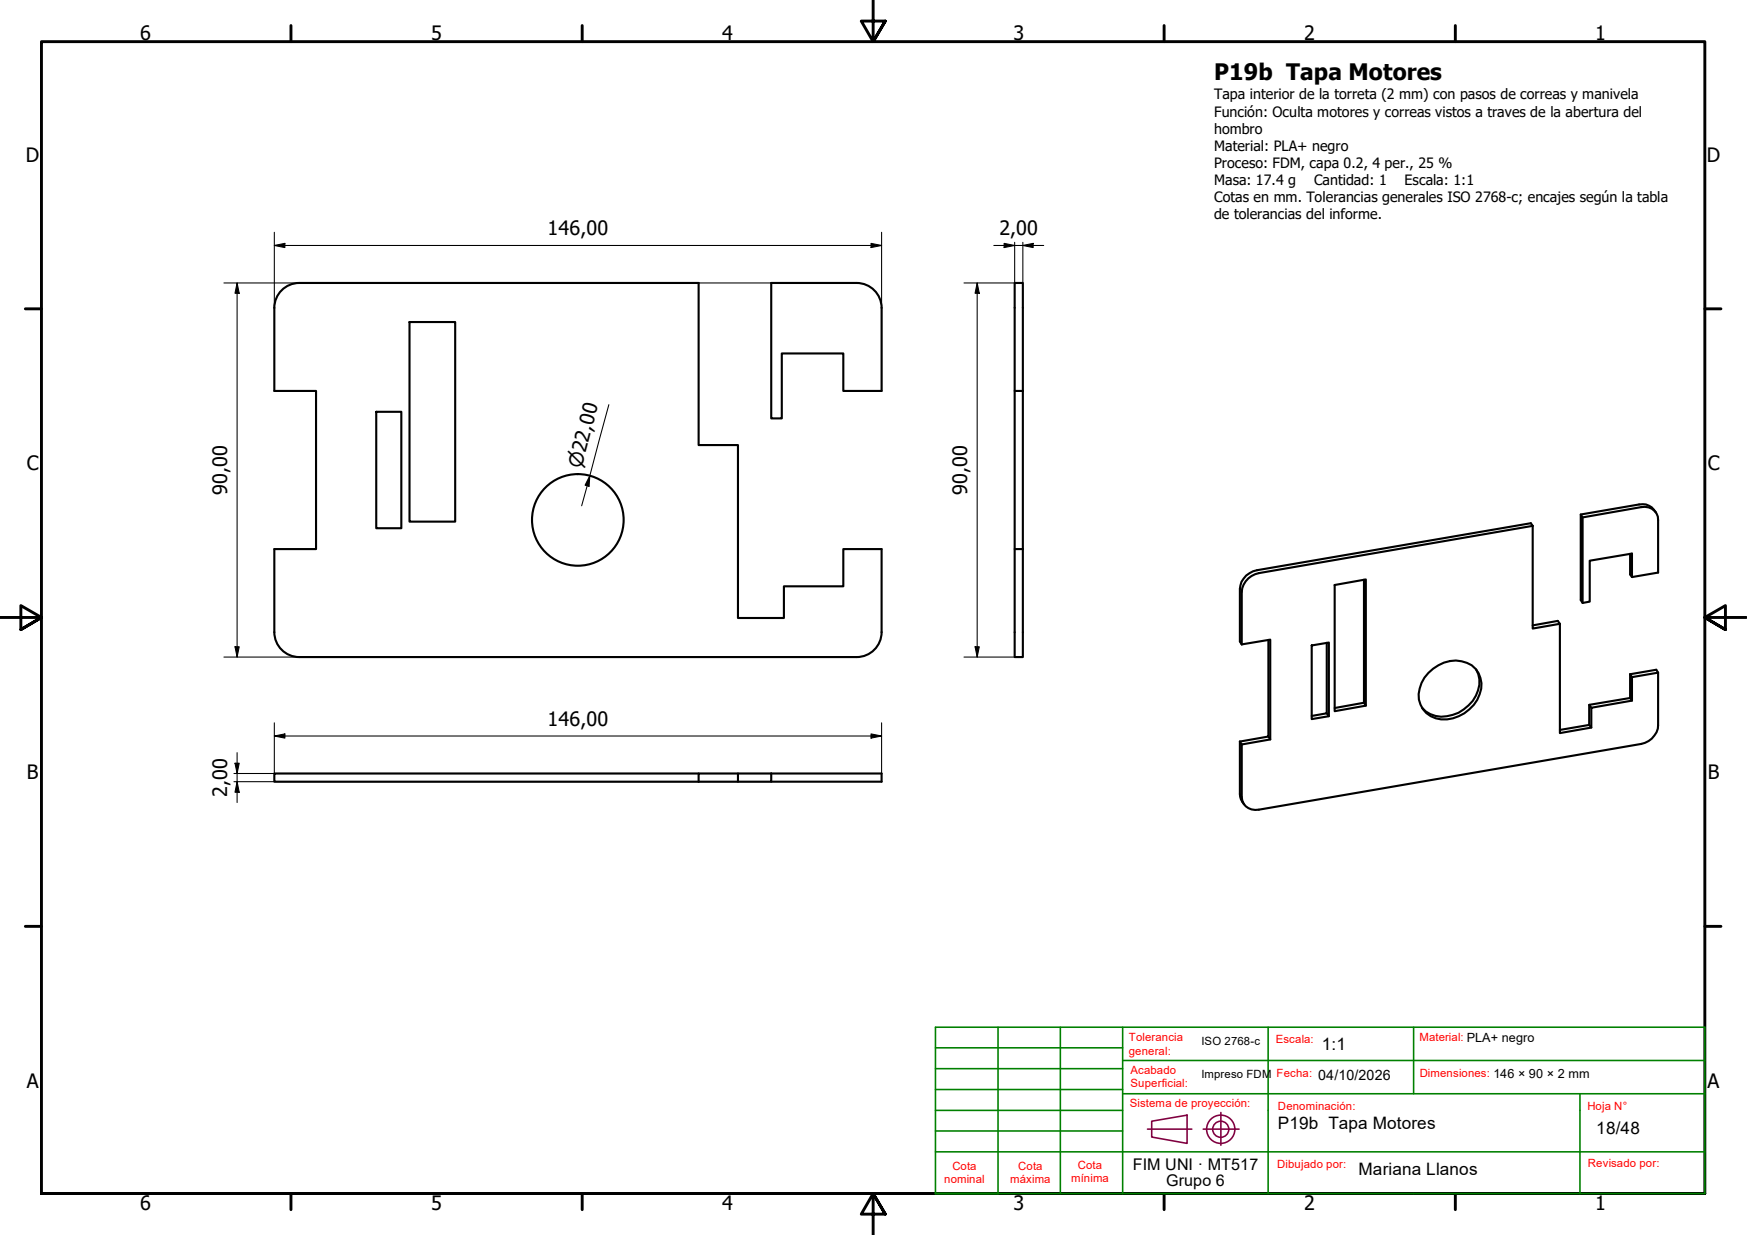
[picture p42: page 18]
Masa: 17.4 g; Cantidad: 1; Escala: 1:1

P19b Tapa Motores
Tapa interior de la torreta (2 mm) con pasos de correas y manivela
Función: Oculta motores y correas vistos a traves de la abertura del
hombro
Material: PLA+ negro
Proceso: FDM, capa 0.2, 4 per., 25 %
Cotas en mm. Tolerancias generales ISO 2768-c; encajes según la tabla
de tolerancias del informe.

Tolerancia ISO 2768-c general: | Escala: 1:1 | Material: PLA+ negro

Acabado Impreso FDM Superficial: | Fecha: 04/10/2026 | Dimensiones: 146 × 90 × 2 mm

Sistema de proyección: | Denominación: P19b Tapa Motores | Hoja N° 18/48

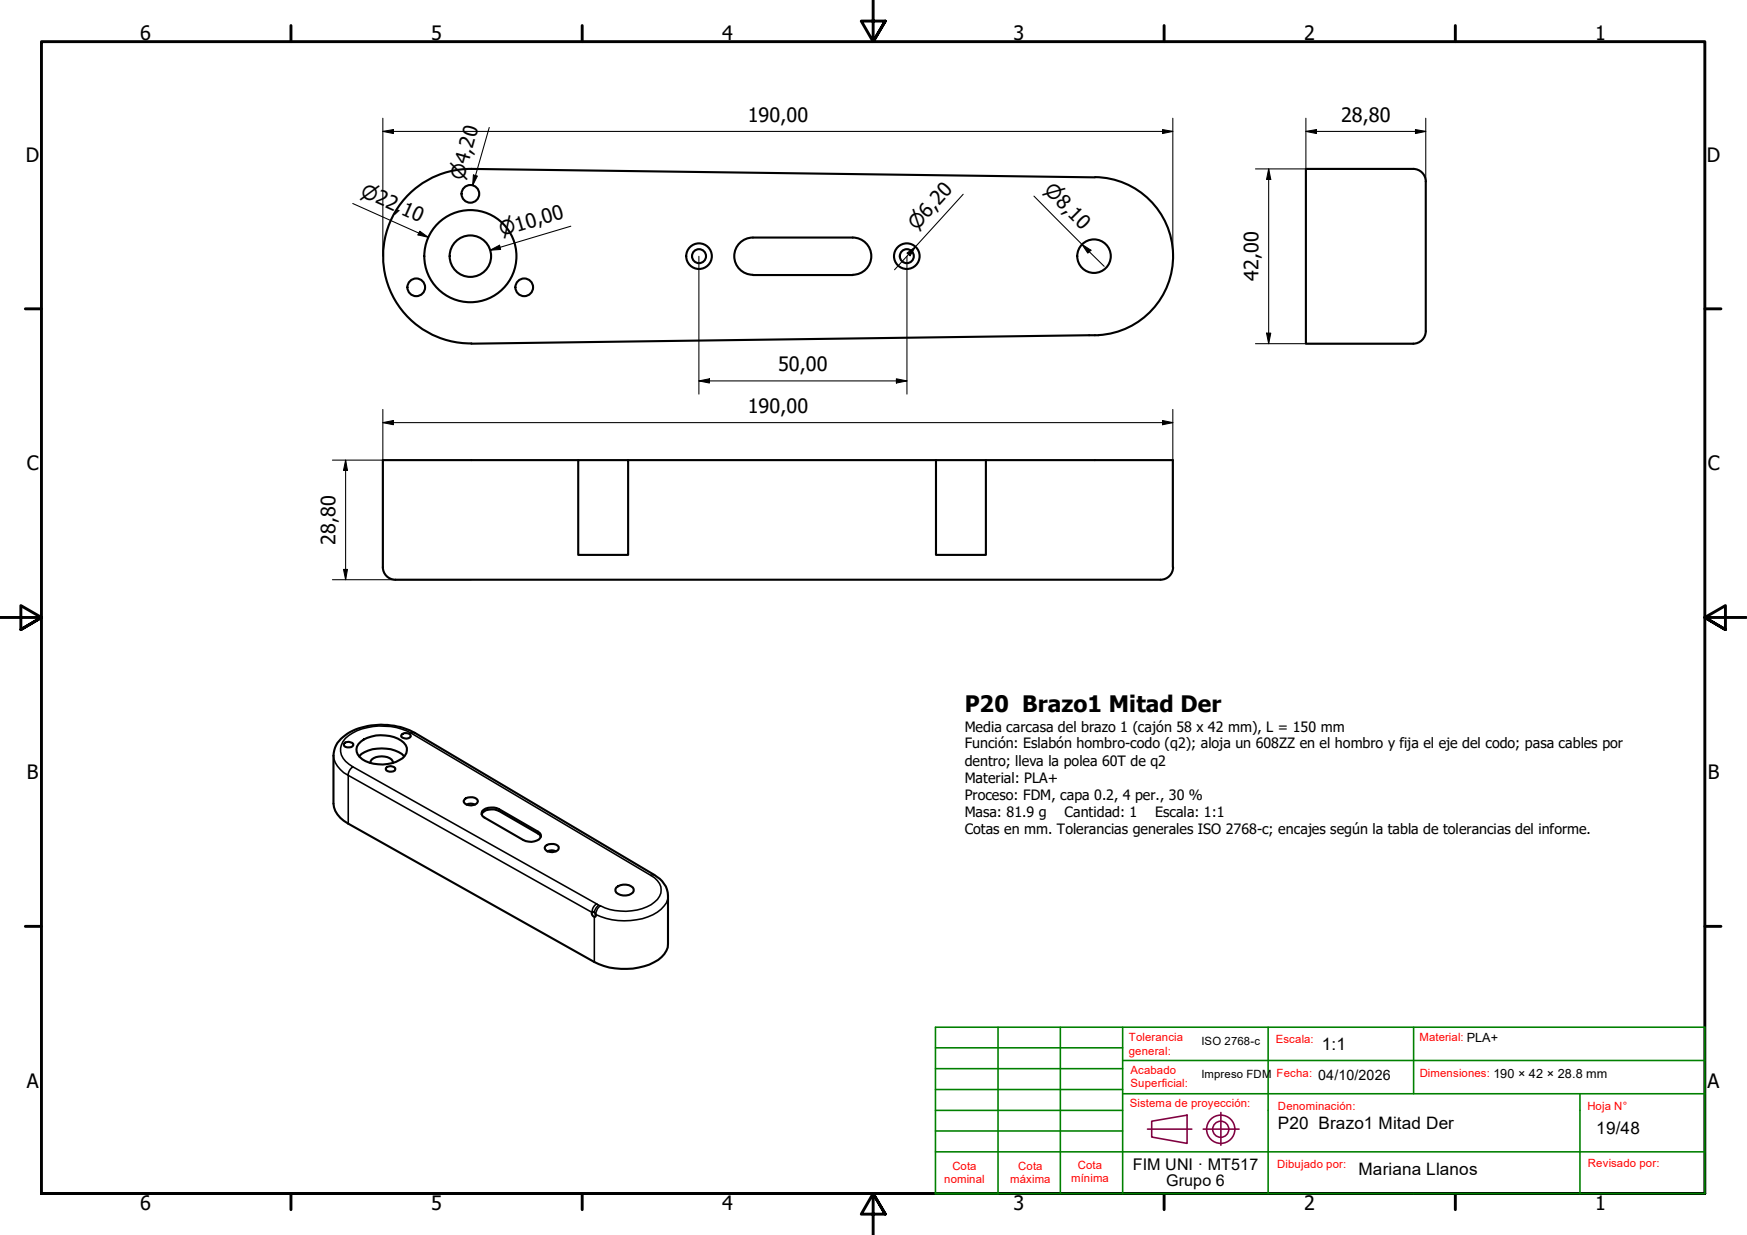
[picture p43: page 19]
Masa: 81.9 g; Cantidad: 1; Escala: 1:1

P20 Brazo1 Mitad Der
Media carcasa del brazo 1 (cajón 58 x 42 mm), L = 150 mm
Función: Eslabón hombro-codo (q2); aloja un 608ZZ en el hombro y fija el eje del codo; pasa cables por
dentro; lleva la polea 60T de q2
Material: PLA+
Proceso: FDM, capa 0.2, 4 per., 30 %
Cotas en mm. Tolerancias generales ISO 2768-c; encajes según la tabla de tolerancias del informe.

Tolerancia ISO 2768-c general: | Escala: 1:1 | Material: PLA+

Acabado Impreso FDM Superficial: | Fecha: 04/10/2026 | Dimensiones: 190 × 42 × 28.8 mm

Sistema de proyección: | Denominación: P20 Brazo1 Mitad Der | Hoja N° 19/48

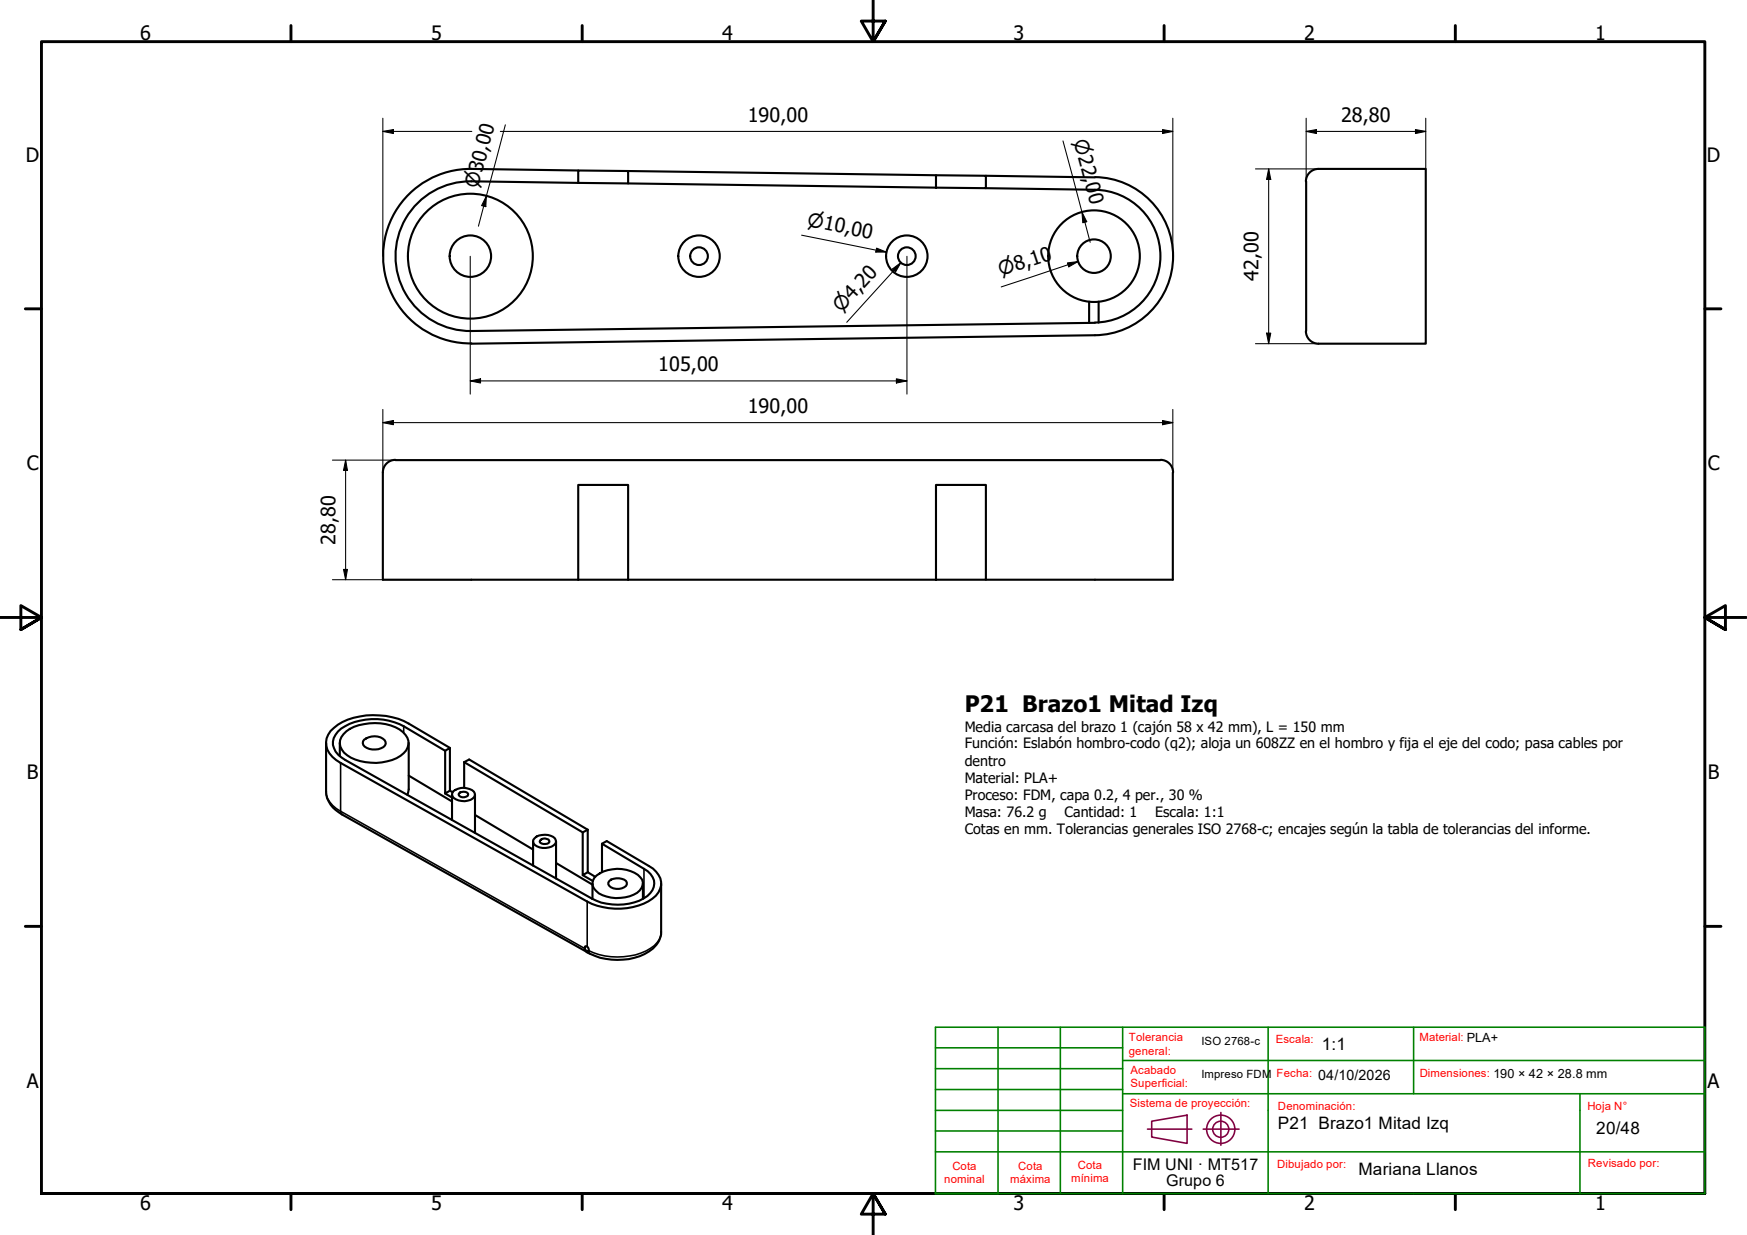
[picture p44: page 20]
Masa: 76.2 g; Cantidad: 1; Escala: 1:1

P21 Brazo1 Mitad Izq
Media carcasa del brazo 1 (cajón 58 x 42 mm), L = 150 mm
Función: Eslabón hombro-codo (q2); aloja un 608ZZ en el hombro y fija el eje del codo; pasa cables por
dentro
Material: PLA+
Proceso: FDM, capa 0.2, 4 per., 30 %
Cotas en mm. Tolerancias generales ISO 2768-c; encajes según la tabla de tolerancias del informe.

Tolerancia ISO 2768-c general: | Escala: 1:1 | Material: PLA+

Acabado Impreso FDM Superficial: | Fecha: 04/10/2026 | Dimensiones: 190 × 42 × 28.8 mm

Sistema de proyección: | Denominación: P21 Brazo1 Mitad Izq | Hoja N° 20/48

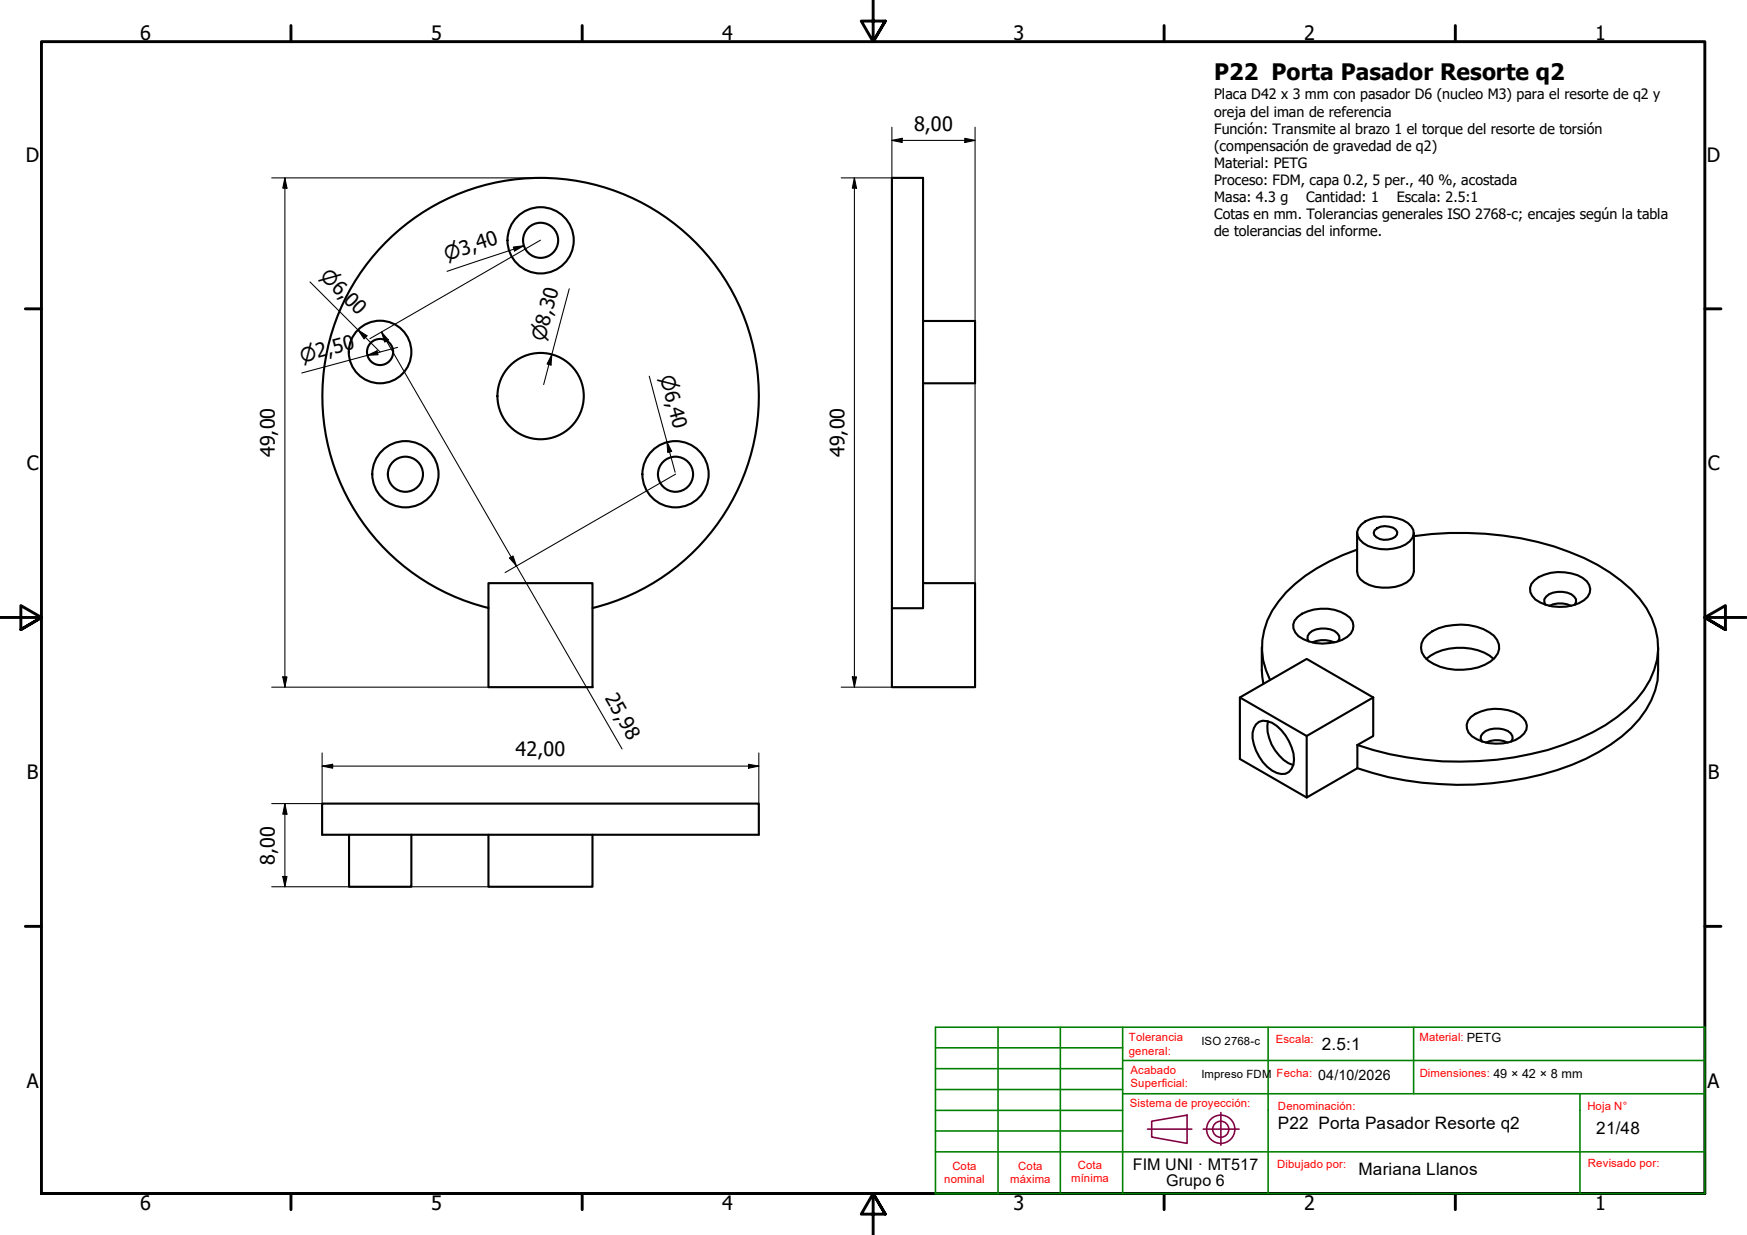
[picture p45: page 21]
Masa: 4.3 g; Cantidad: 1; Escala: 2.5:1

P22 Porta Pasador Resorte q2
Placa D42 x 3 mm con pasador D6 (nucleo M3) para el resorte de q2 y
oreja del iman de referencia
Función: Transmite al brazo 1 el torque del resorte de torsión
(compensación de gravedad de q2)
Material: PETG
Proceso: FDM, capa 0.2, 5 per., 40 %, acostada
Cotas en mm. Tolerancias generales ISO 2768-c; encajes según la tabla
de tolerancias del informe.

Tolerancia ISO 2768-c general: | Escala: 2.5:1 | Material: PETG

Acabado Impreso FDM Superficial: | Fecha: 04/10/2026 | Dimensiones: 49 × 42 × 8 mm

Sistema de proyección: | Denominación: P22 Porta Pasador Resorte q2 | Hoja N° 21/48

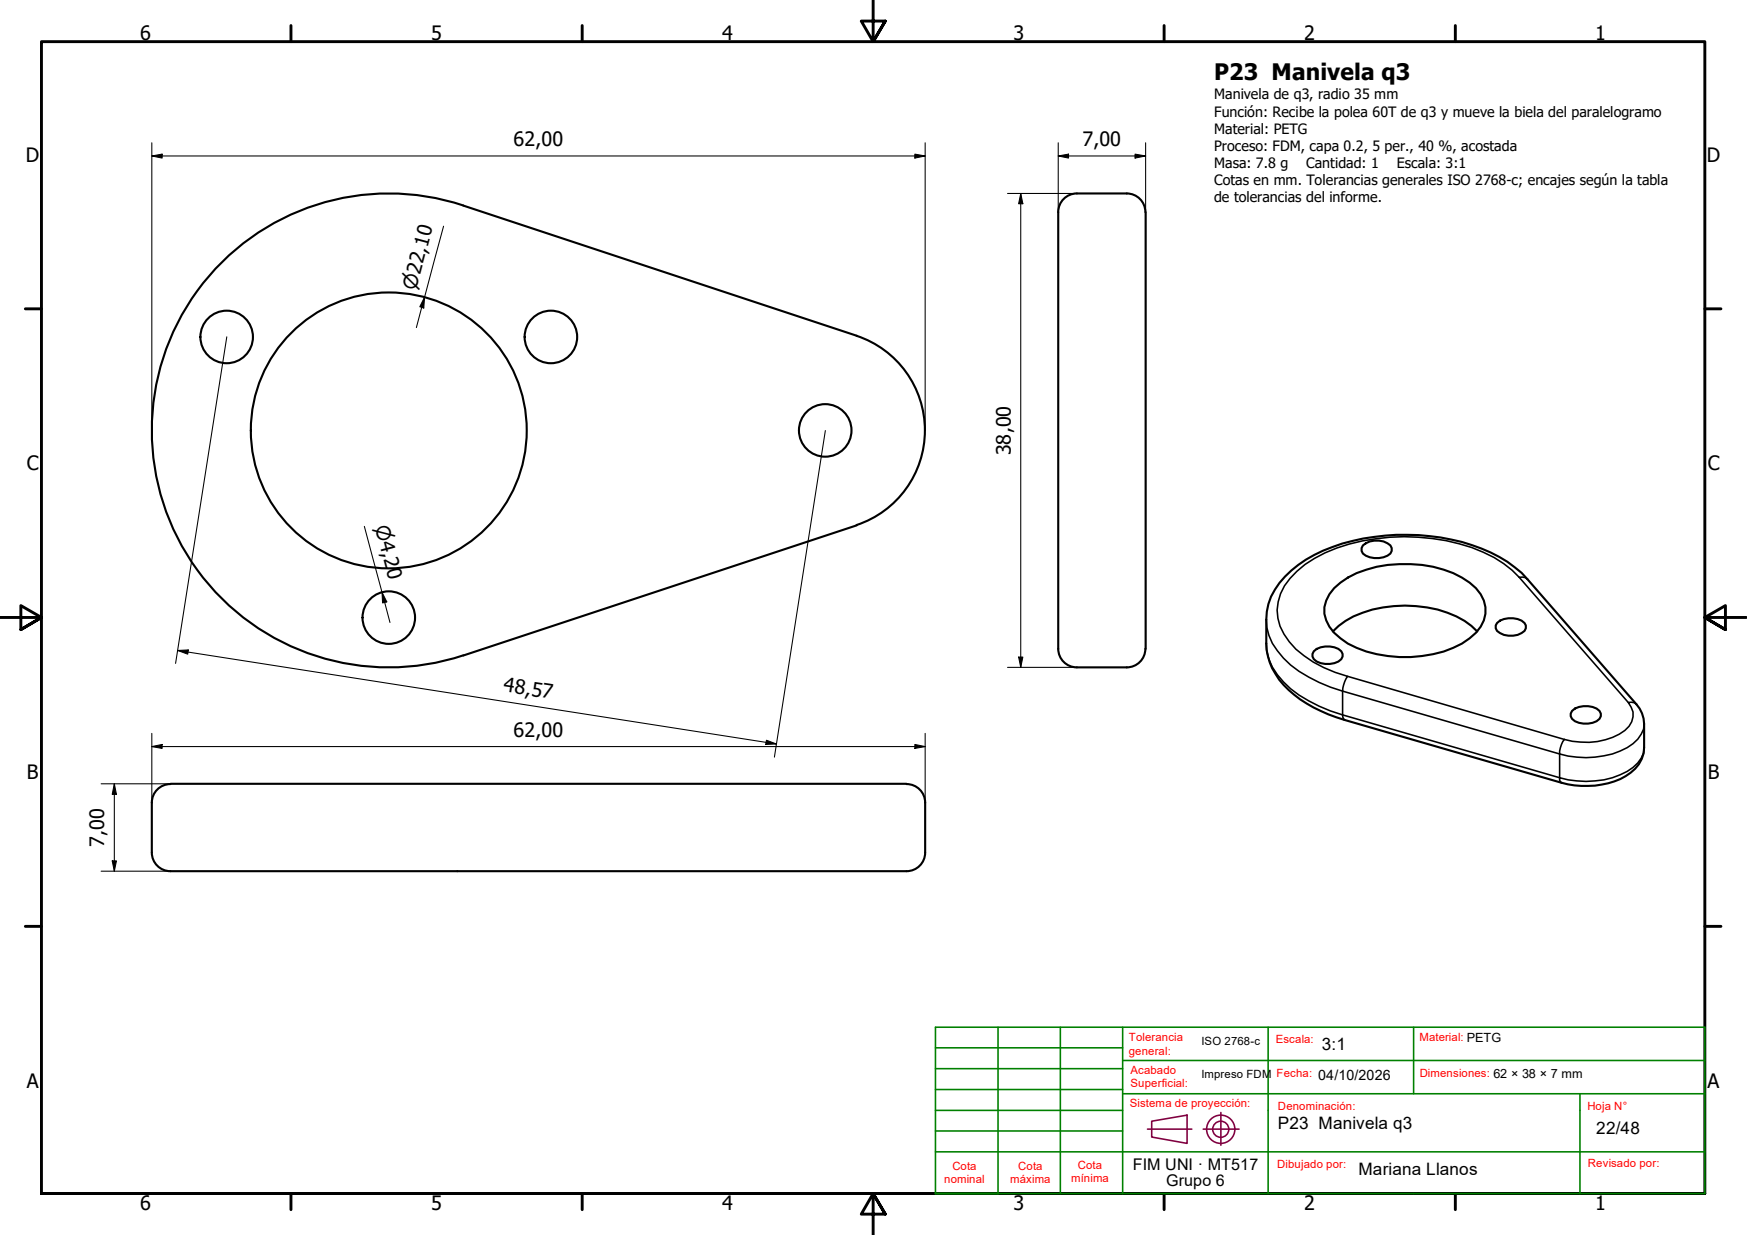
[picture p46: page 22]
Masa: 7.8 g; Cantidad: 1; Escala: 3:1

P23 Manivela q3
Manivela de q3, radio 35 mm
Función: Recibe la polea 60T de q3 y mueve la biela del paralelogramo
Material: PETG
Proceso: FDM, capa 0.2, 5 per., 40 %, acostada
Cotas en mm. Tolerancias generales ISO 2768-c; encajes según la tabla
de tolerancias del informe.

Tolerancia ISO 2768-c general: | Escala: 3:1 | Material: PETG

Acabado Impreso FDM Superficial: | Fecha: 04/10/2026 | Dimensiones: 62 × 38 × 7 mm

Sistema de proyección: | Denominación: P23 Manivela q3 | Hoja N° 22/48

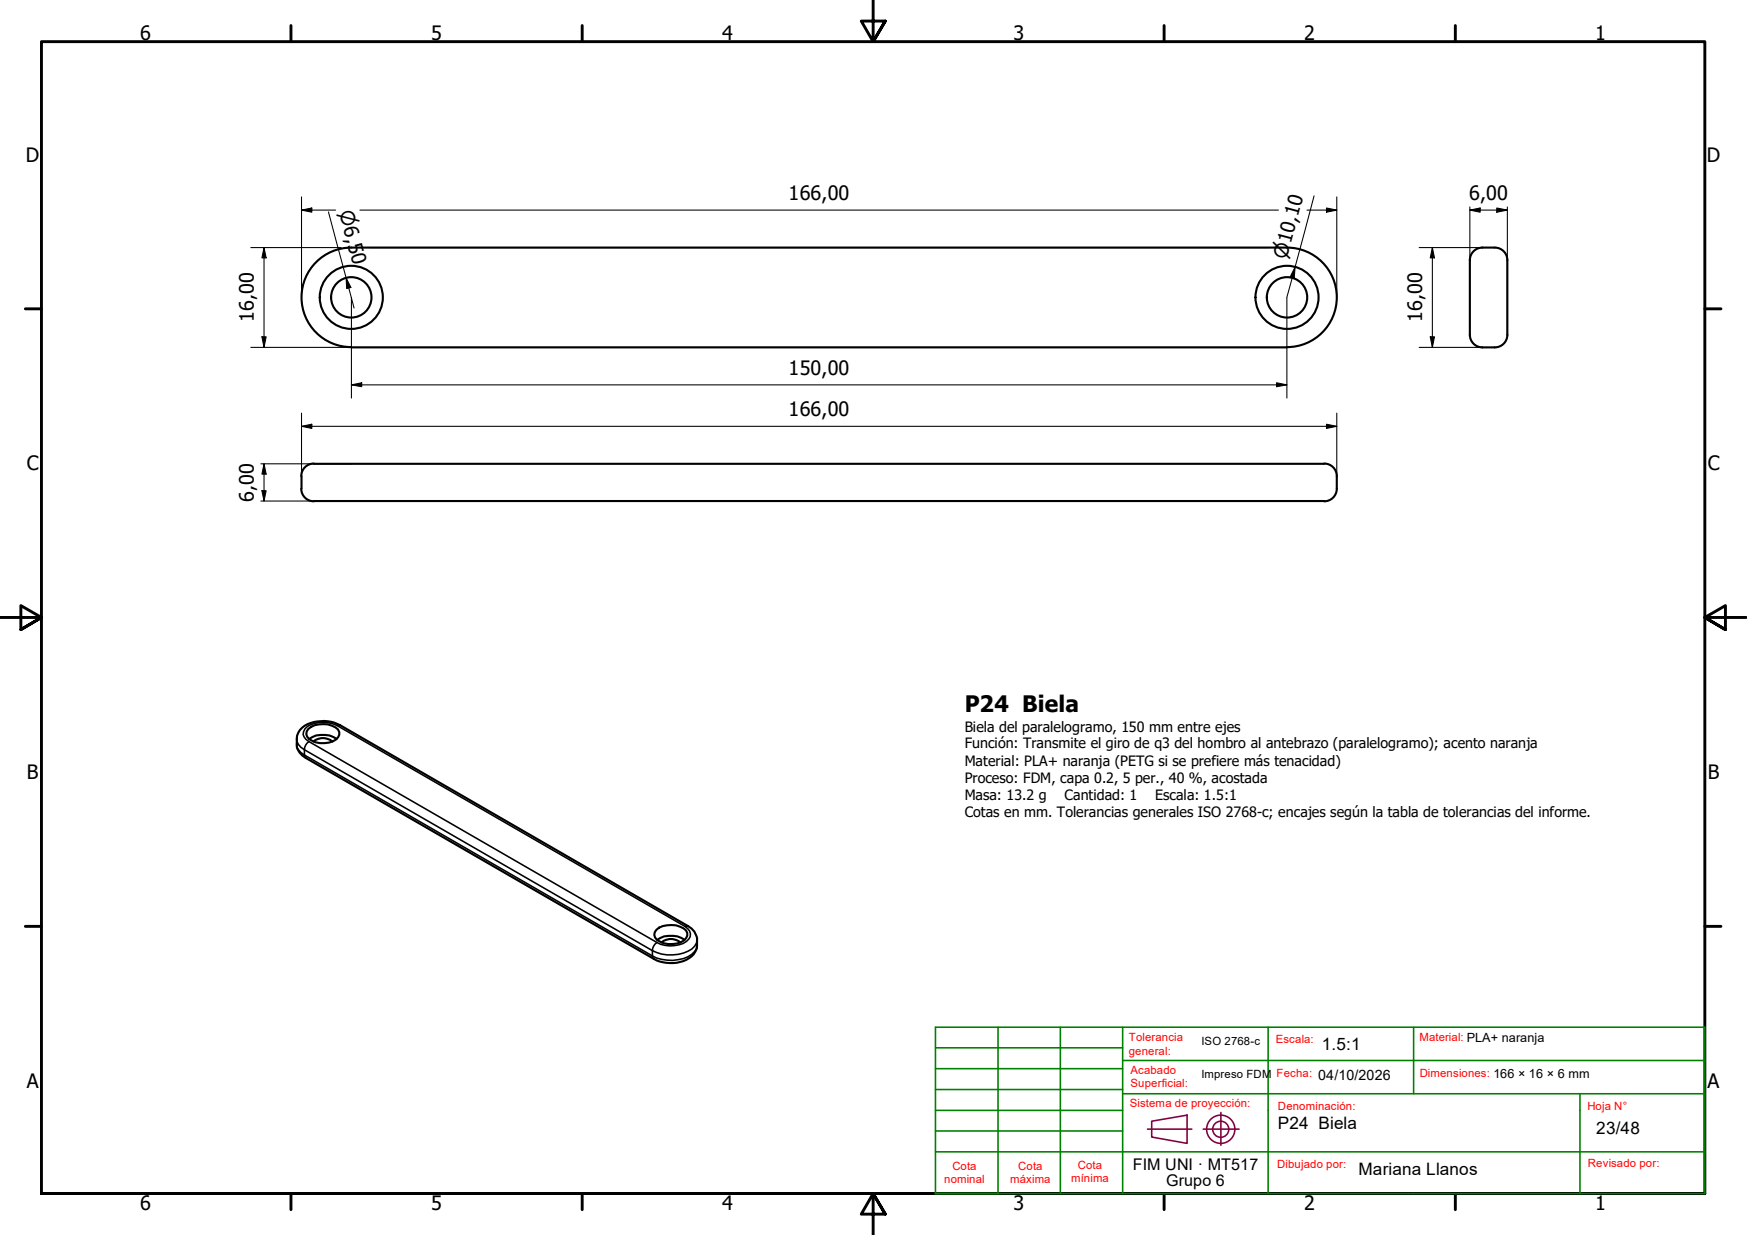
[picture p47: page 23]
Masa: 13.2 g; Cantidad: 1; Escala: 1.5:1

P24 Biela
Biela del paralelogramo, 150 mm entre ejes
Función: Transmite el giro de q3 del hombro al antebrazo (paralelogramo); acento naranja
Material: PLA+ naranja (PETG si se prefiere más tenacidad)
Proceso: FDM, capa 0.2, 5 per., 40 %, acostada
Cotas en mm. Tolerancias generales ISO 2768-c; encajes según la tabla de tolerancias del informe.

Tolerancia ISO 2768-c general: | Escala: 1.5:1 | Material: PLA+ naranja

Acabado Impreso FDM Superficial: | Fecha: 04/10/2026 | Dimensiones: 166 × 16 × 6 mm

Sistema de proyección: | Denominación: P24 Biela | Hoja N° 23/48

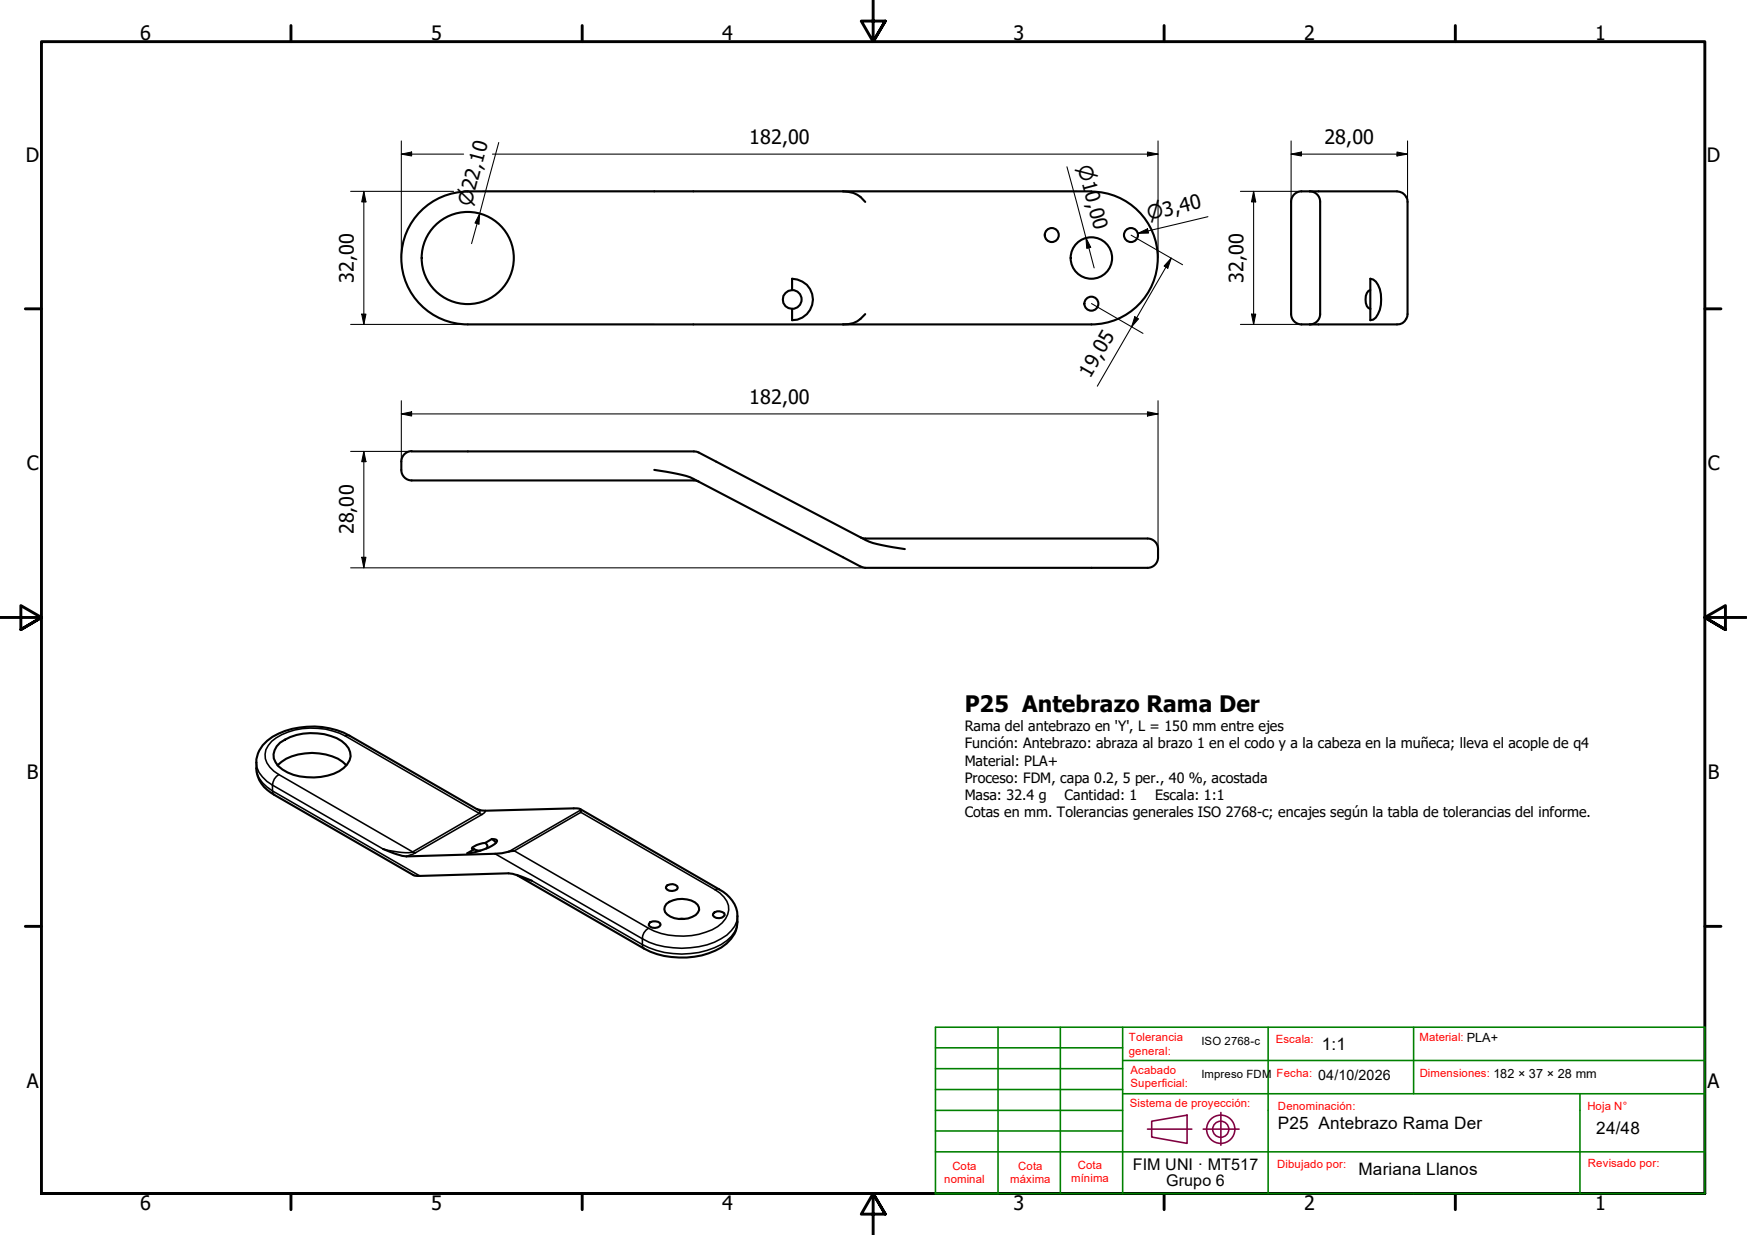
[picture p48: page 24]
Masa: 32.4 g; Cantidad: 1; Escala: 1:1

P25 Antebrazo Rama Der
Rama del antebrazo en 'Y', L = 150 mm entre ejes
Función: Antebrazo: abraza al brazo 1 en el codo y a la cabeza en la muñeca; lleva el acople de q4
Material: PLA+
Proceso: FDM, capa 0.2, 5 per., 40 %, acostada
Cotas en mm. Tolerancias generales ISO 2768-c; encajes según la tabla de tolerancias del informe.

Tolerancia ISO 2768-c general: | Escala: 1:1 | Material: PLA+

Acabado Impreso FDM Superficial: | Fecha: 04/10/2026 | Dimensiones: 182 × 37 × 28 mm

Sistema de proyección: | Denominación: P25 Antebrazo Rama Der | Hoja N° 24/48

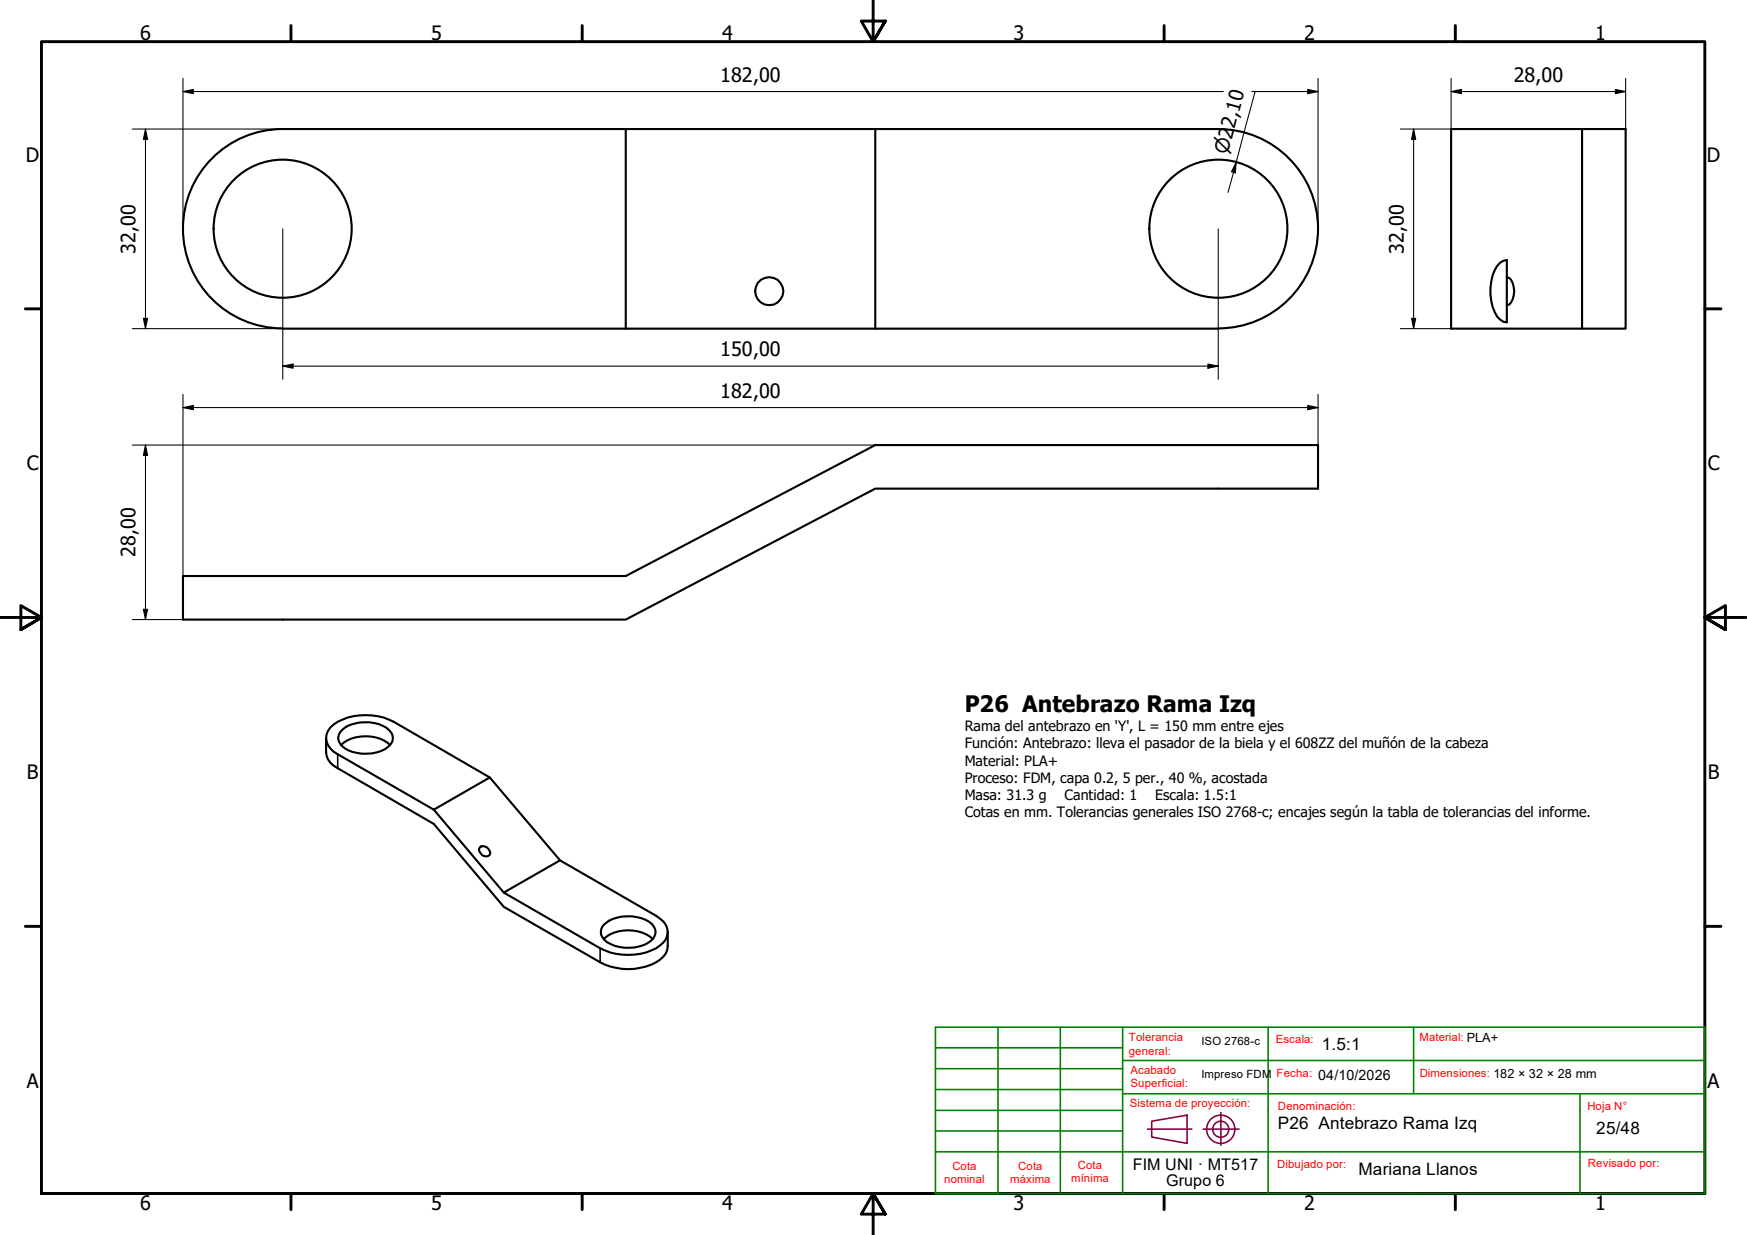
[picture p49: page 25]
Masa: 31.3 g; Cantidad: 1; Escala: 1.5:1

P26 Antebrazo Rama Izq
Rama del antebrazo en 'Y', L = 150 mm entre ejes
Función: Antebrazo: lleva el pasador de la biela y el 608ZZ del muñón de la cabeza
Material: PLA+
Proceso: FDM, capa 0.2, 5 per., 40 %, acostada
Cotas en mm. Tolerancias generales ISO 2768-c; encajes según la tabla de tolerancias del informe.

Tolerancia ISO 2768-c general: | Escala: 1.5:1 | Material: PLA+

Acabado Impreso FDM Superficial: | Fecha: 04/10/2026 | Dimensiones: 182 × 32 × 28 mm

Sistema de proyección: | Denominación: P26 Antebrazo Rama Izq | Hoja N° 25/48

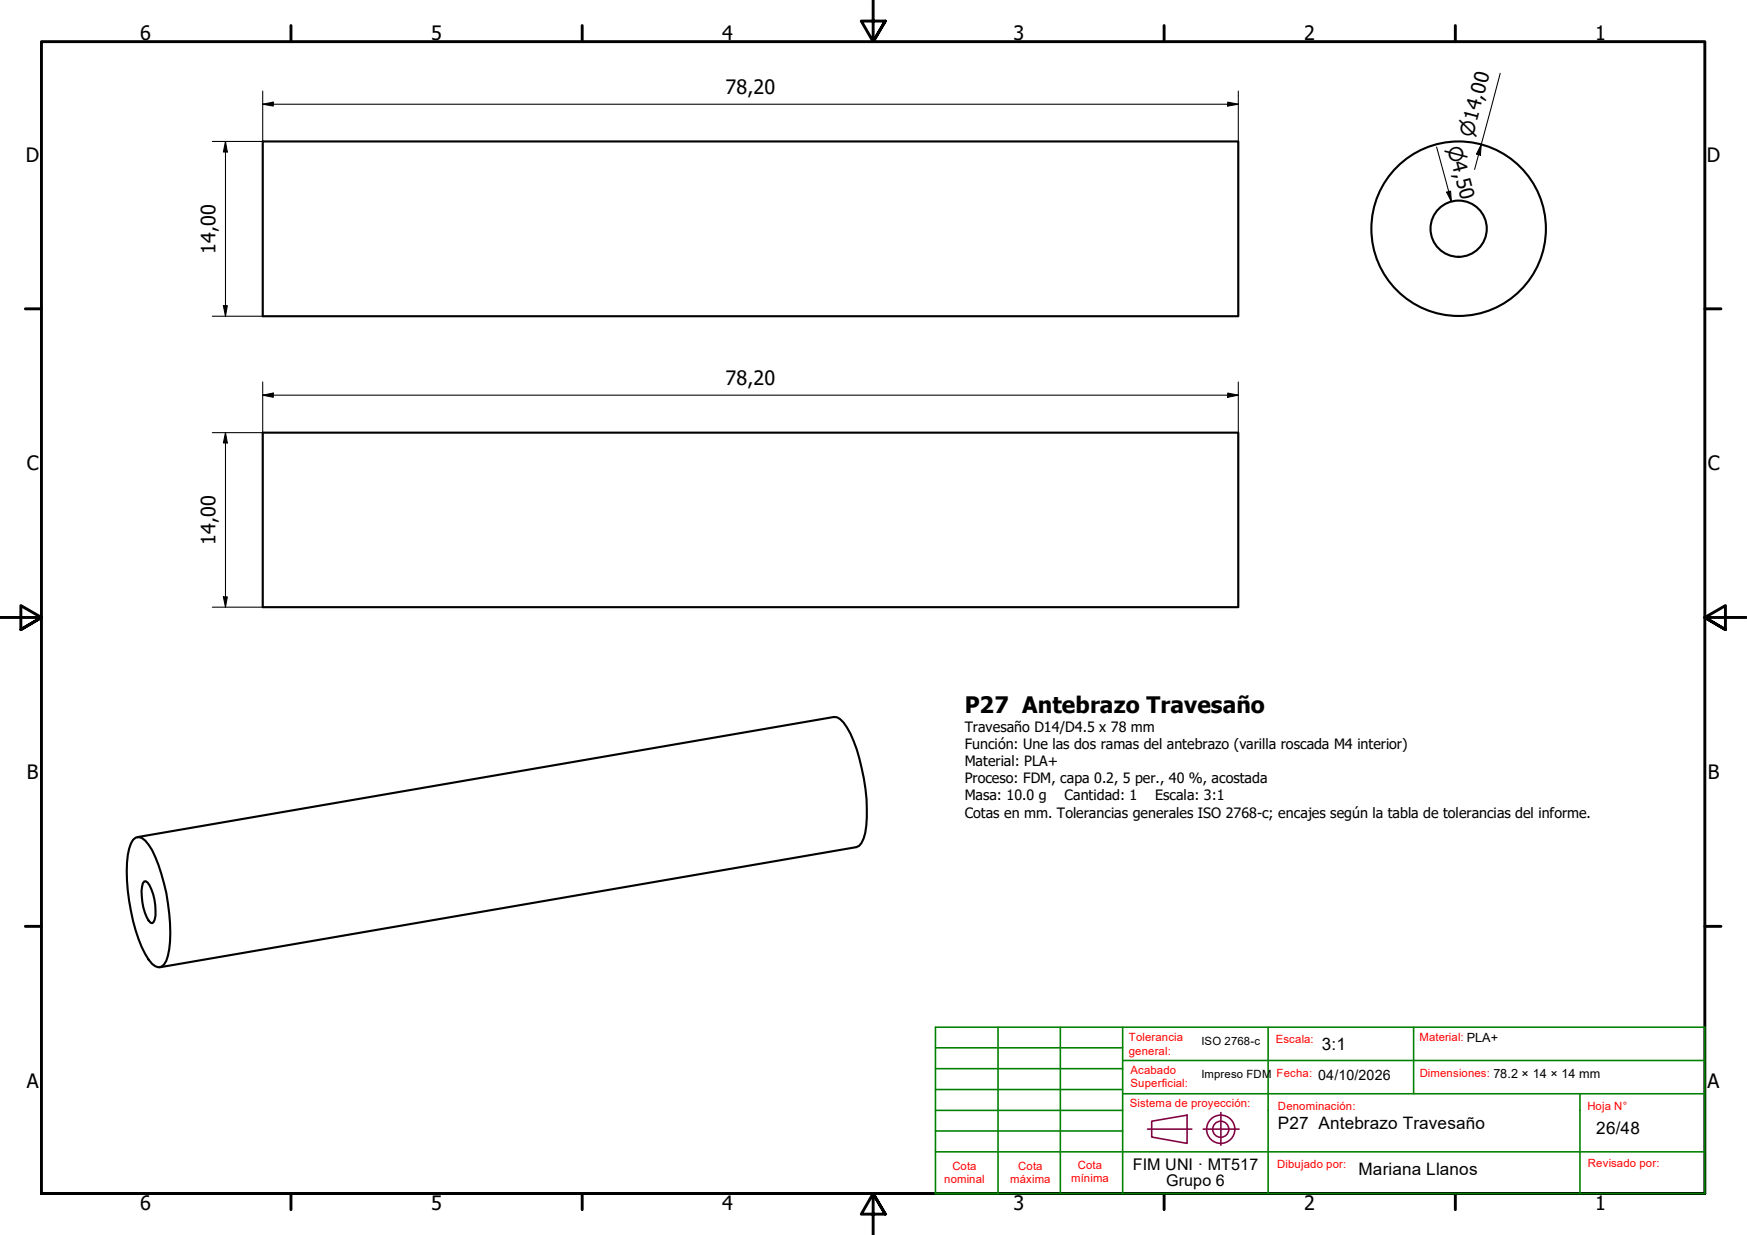
[picture p50: page 26]
Masa: 10.0 g; Cantidad: 1; Escala: 3:1

P27 Antebrazo Travesaño
Travesaño D14/D4.5 x 78 mm
Función: Une las dos ramas del antebrazo (varilla roscada M4 interior)
Material: PLA+
Proceso: FDM, capa 0.2, 5 per., 40 %, acostada
Cotas en mm. Tolerancias generales ISO 2768-c; encajes según la tabla de tolerancias del informe.

Tolerancia ISO 2768-c general: | Escala: 3:1 | Material: PLA+

Acabado Impreso FDM Superficial: | Fecha: 04/10/2026 | Dimensiones: 78.2 × 14 × 14 mm

Sistema de proyección: | Denominación: P27 Antebrazo Travesaño | Hoja N° 26/48

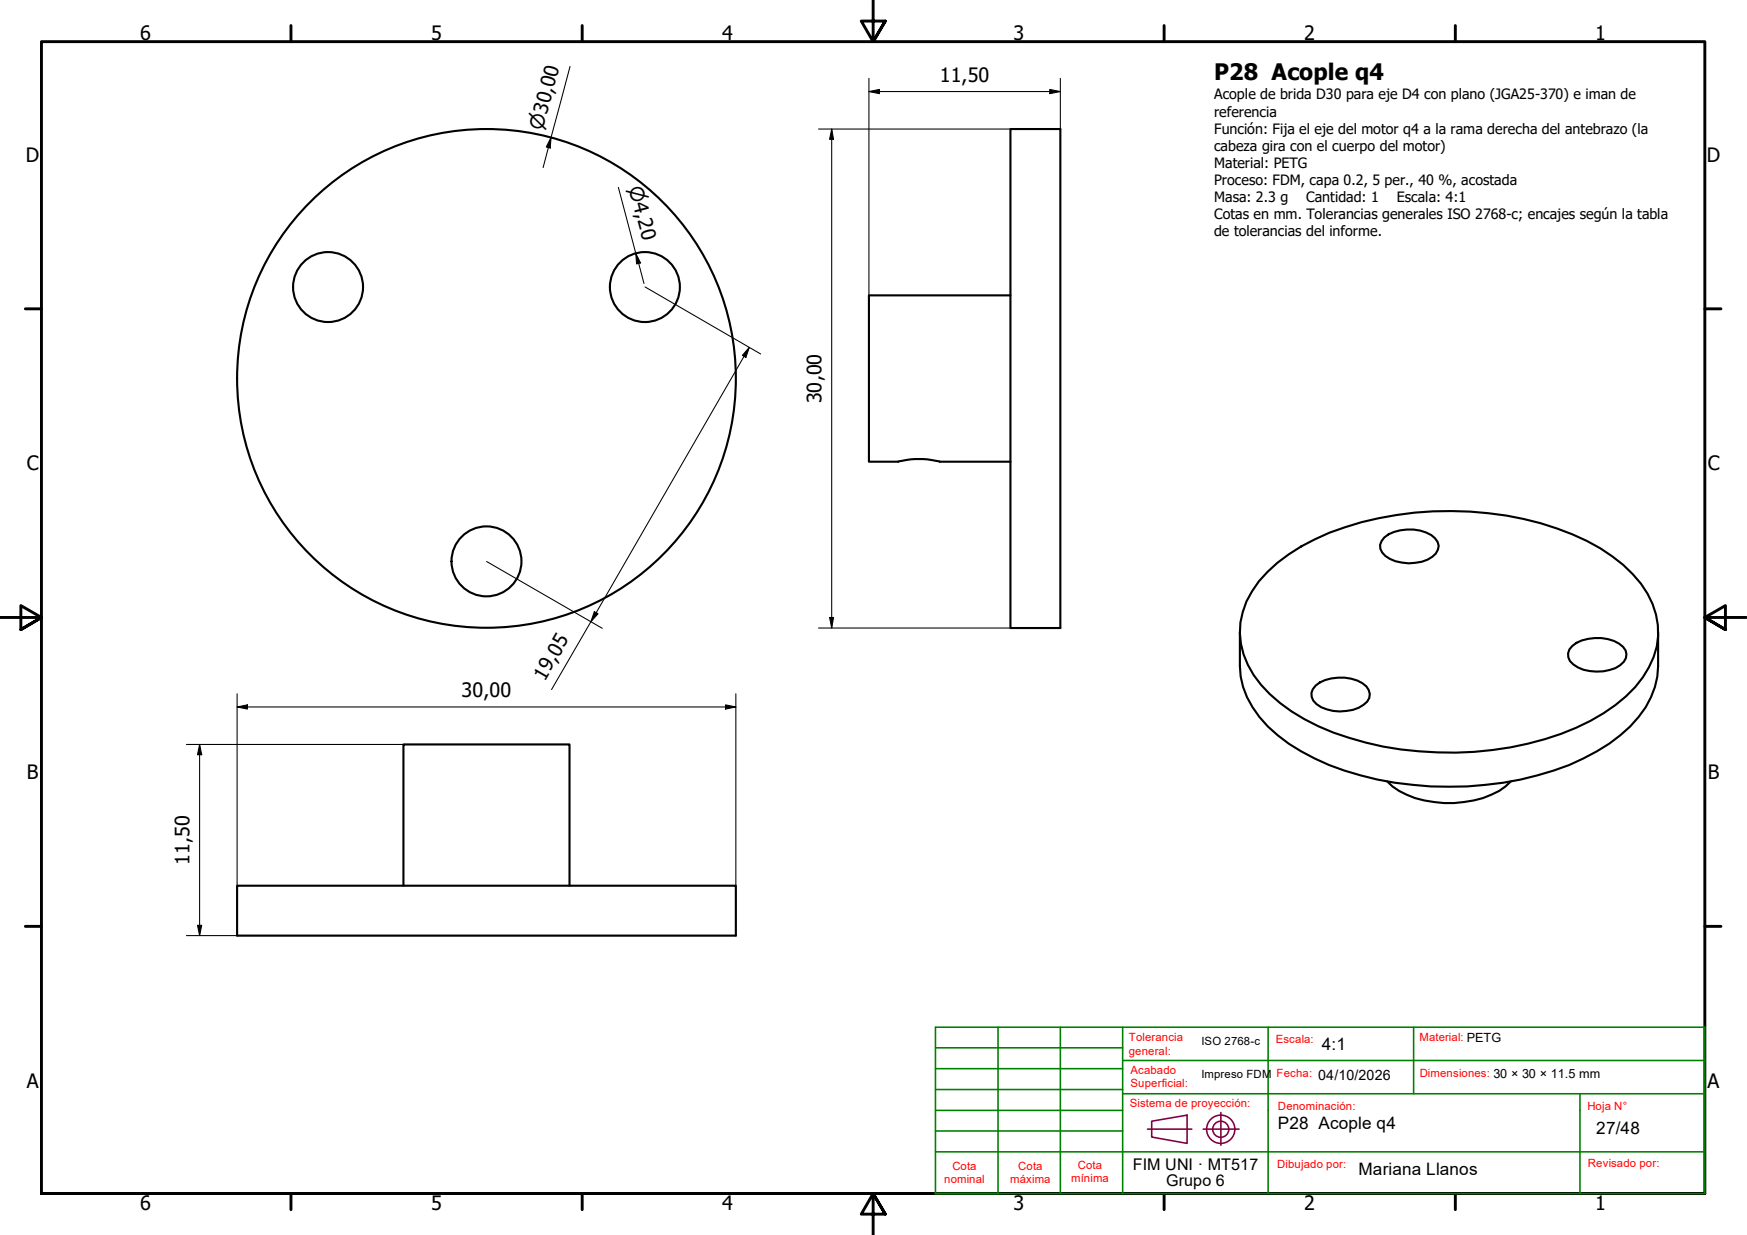
[picture p51: page 27]
Masa: 2.3 g; Cantidad: 1; Escala: 4:1

P28 Acople q4
Acople de brida D30 para eje D4 con plano (JGA25-370) e iman de
referencia
Función: Fija el eje del motor q4 a la rama derecha del antebrazo (la
cabeza gira con el cuerpo del motor)
Material: PETG
Proceso: FDM, capa 0.2, 5 per., 40 %, acostada
Cotas en mm. Tolerancias generales ISO 2768-c; encajes según la tabla
de tolerancias del informe.

Tolerancia ISO 2768-c general: | Escala: 4:1 | Material: PETG

Acabado Impreso FDM Superficial: | Fecha: 04/10/2026 | Dimensiones: 30 × 30 × 11.5 mm

Sistema de proyección: | Denominación: P28 Acople q4 | Hoja N° 27/48

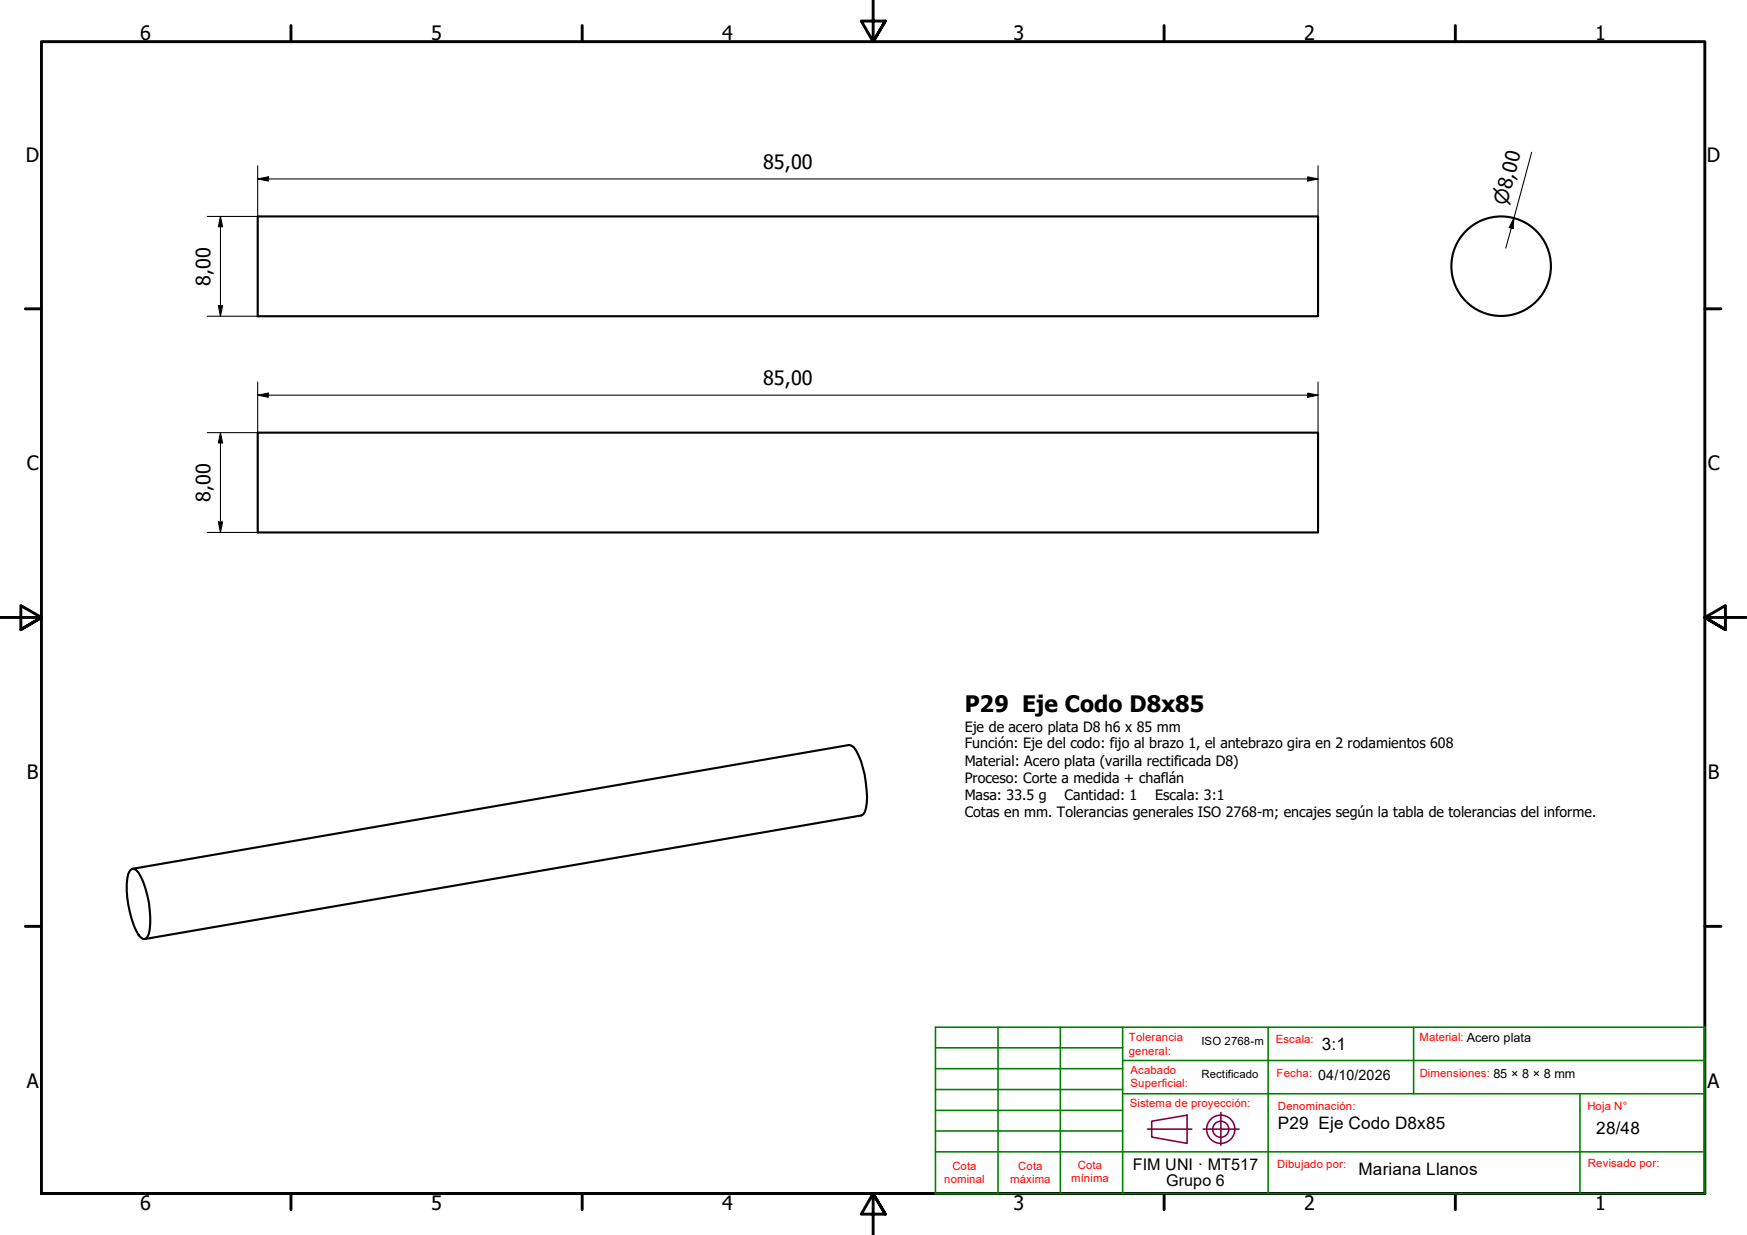
[picture p52: page 28]
Masa: 33.5 g; Cantidad: 1; Escala: 3:1

P29 Eje Codo D8x85
Eje de acero plata D8 h6 x 85 mm
Función: Eje del codo: fijo al brazo 1, el antebrazo gira en 2 rodamientos 608
Material: Acero plata (varilla rectificada D8)
Proceso: Corte a medida + chaflán
Cotas en mm. Tolerancias generales ISO 2768-m; encajes según la tabla de tolerancias del informe.

Tolerancia ISO 2768-m general: | Escala: 3:1 | Material: Acero plata

Acabado Rectificado Superficial: | Fecha: 04/10/2026 | Dimensiones: 85 × 8 × 8 mm

Sistema de proyección: | Denominación: P29 Eje Codo D8x85 | Hoja N° 28/48

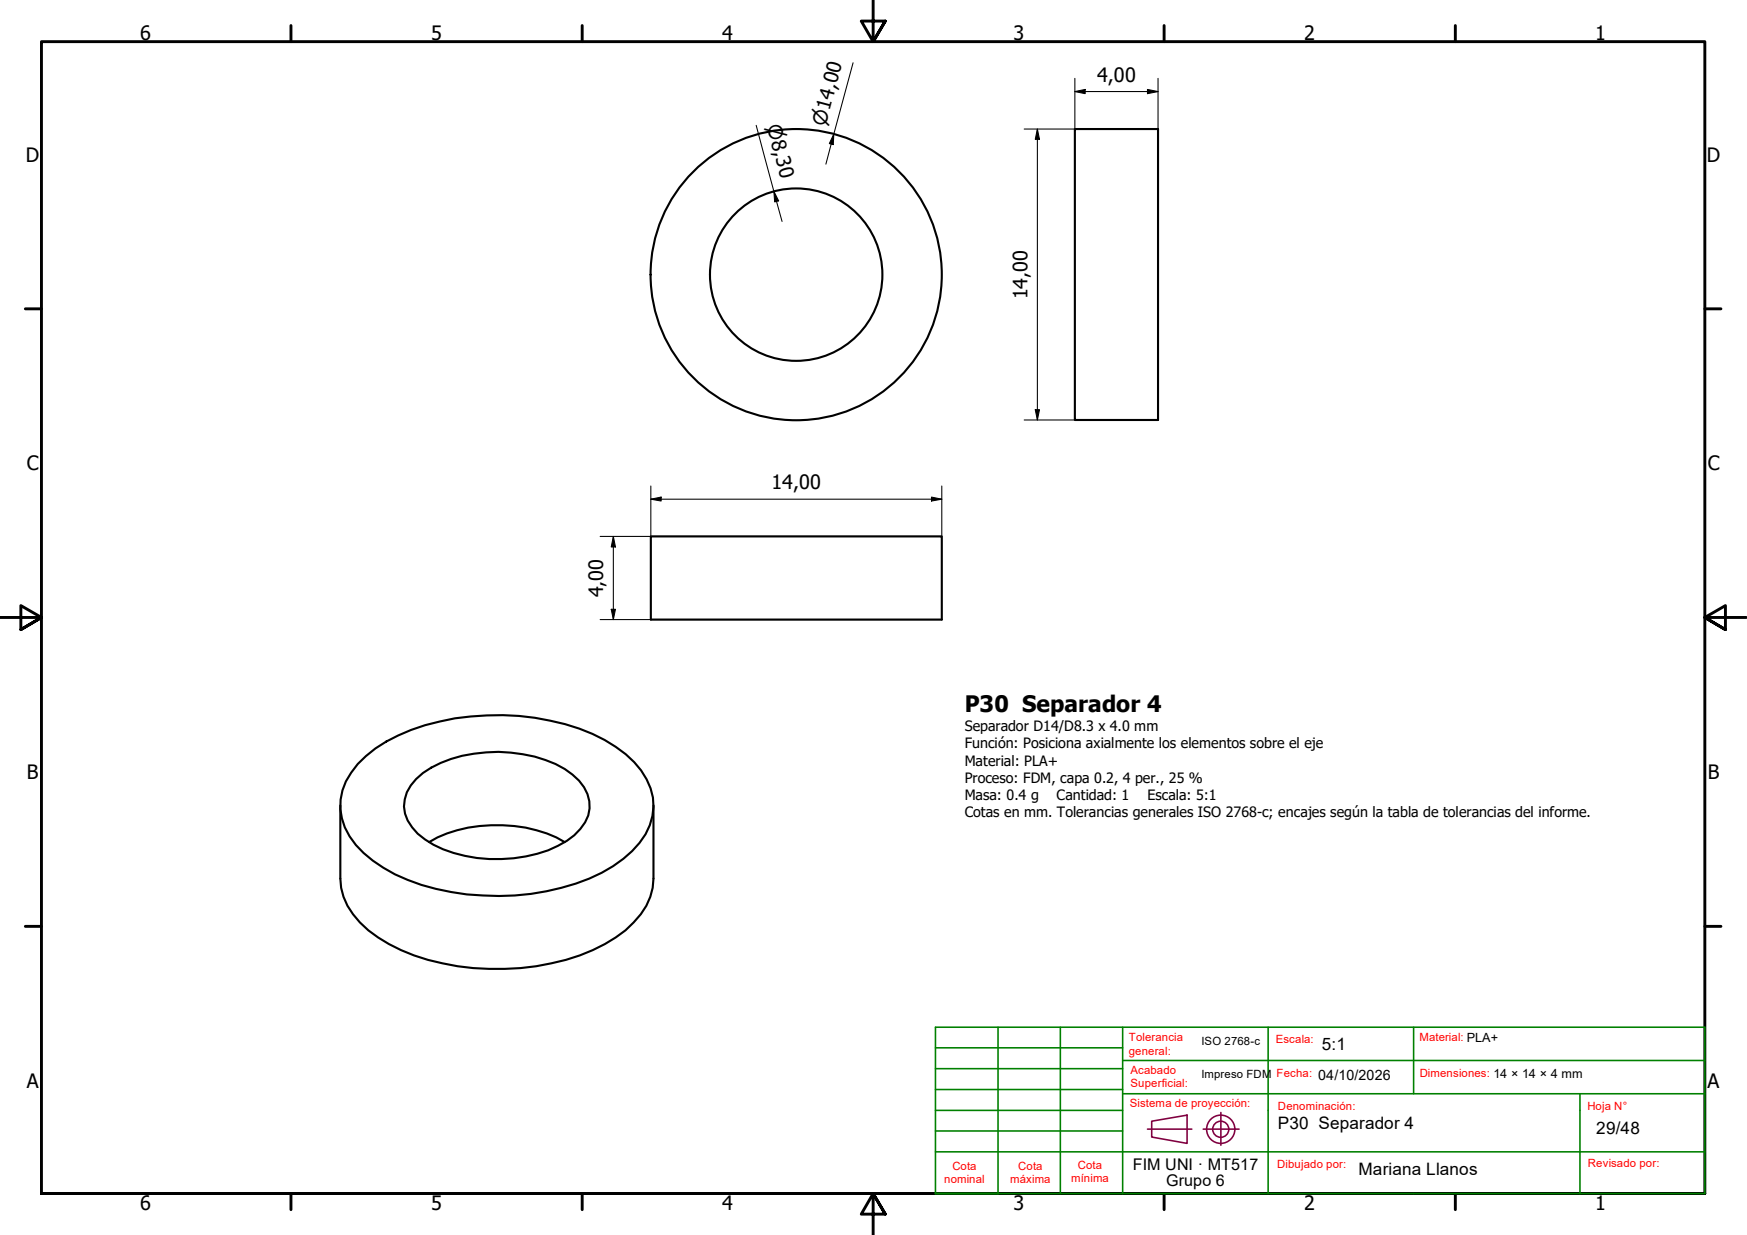
[picture p53: page 29]
Masa: 0.4 g; Cantidad: 1; Escala: 5:1

P30 Separador 4
Separador D14/D8.3 x 4.0 mm
Función: Posiciona axialmente los elementos sobre el eje
Material: PLA+
Proceso: FDM, capa 0.2, 4 per., 25 %
Cotas en mm. Tolerancias generales ISO 2768-c; encajes según la tabla de tolerancias del informe.

Tolerancia ISO 2768-c general: | Escala: 5:1 | Material: PLA+

Acabado Impreso FDM Superficial: | Fecha: 04/10/2026 | Dimensiones: 14 × 14 × 4 mm

Sistema de proyección: | Denominación: P30 Separador 4 | Hoja N° 29/48

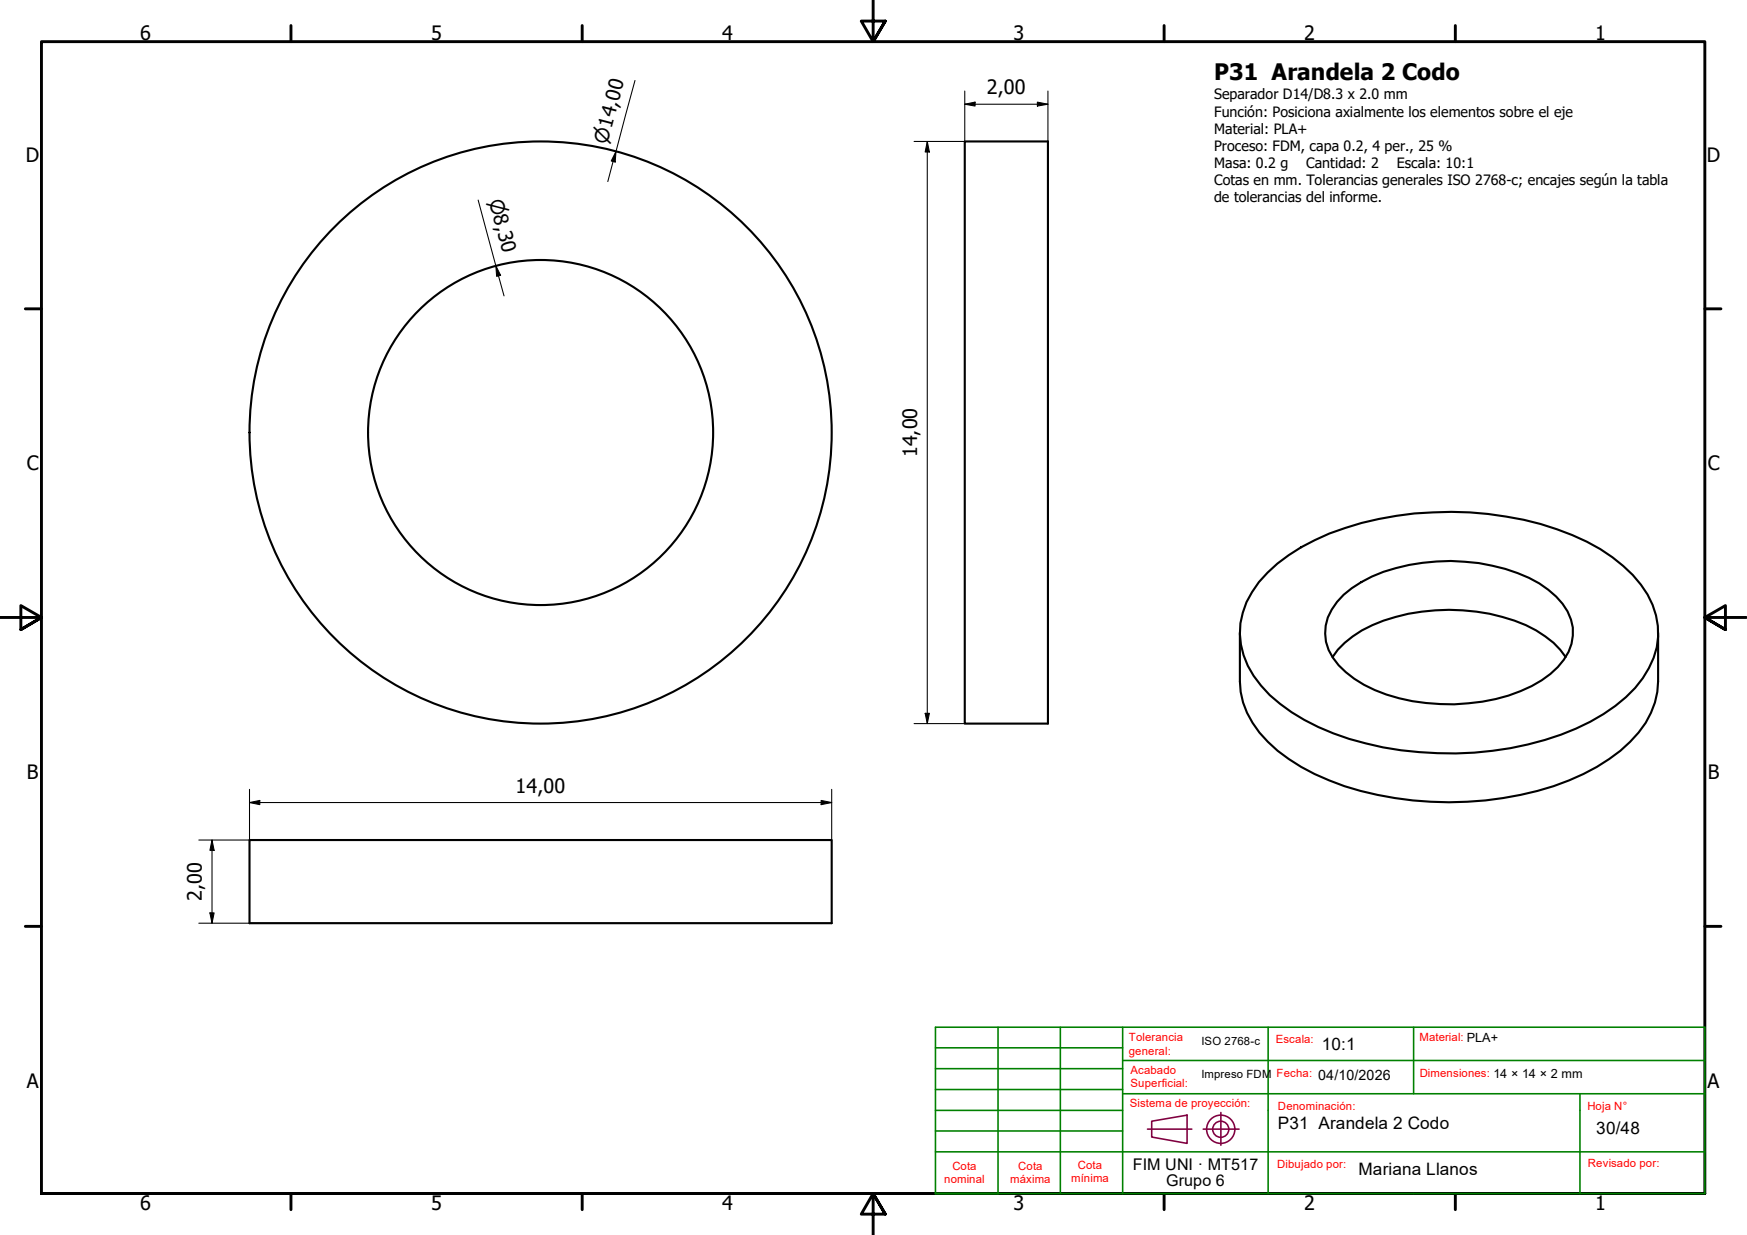
[picture p54: page 30]
Masa: 0.2 g; Cantidad: 2; Escala: 10:1

P31 Arandela 2 Codo
Separador D14/D8.3 x 2.0 mm
Función: Posiciona axialmente los elementos sobre el eje
Material: PLA+
Proceso: FDM, capa 0.2, 4 per., 25 %
Cotas en mm. Tolerancias generales ISO 2768-c; encajes según la tabla
de tolerancias del informe.

Tolerancia ISO 2768-c general: | Escala: 10:1 | Material: PLA+

Acabado Impreso FDM Superficial: | Fecha: 04/10/2026 | Dimensiones: 14 × 14 × 2 mm

Sistema de proyección: | Denominación: P31 Arandela 2 Codo | Hoja N° 30/48

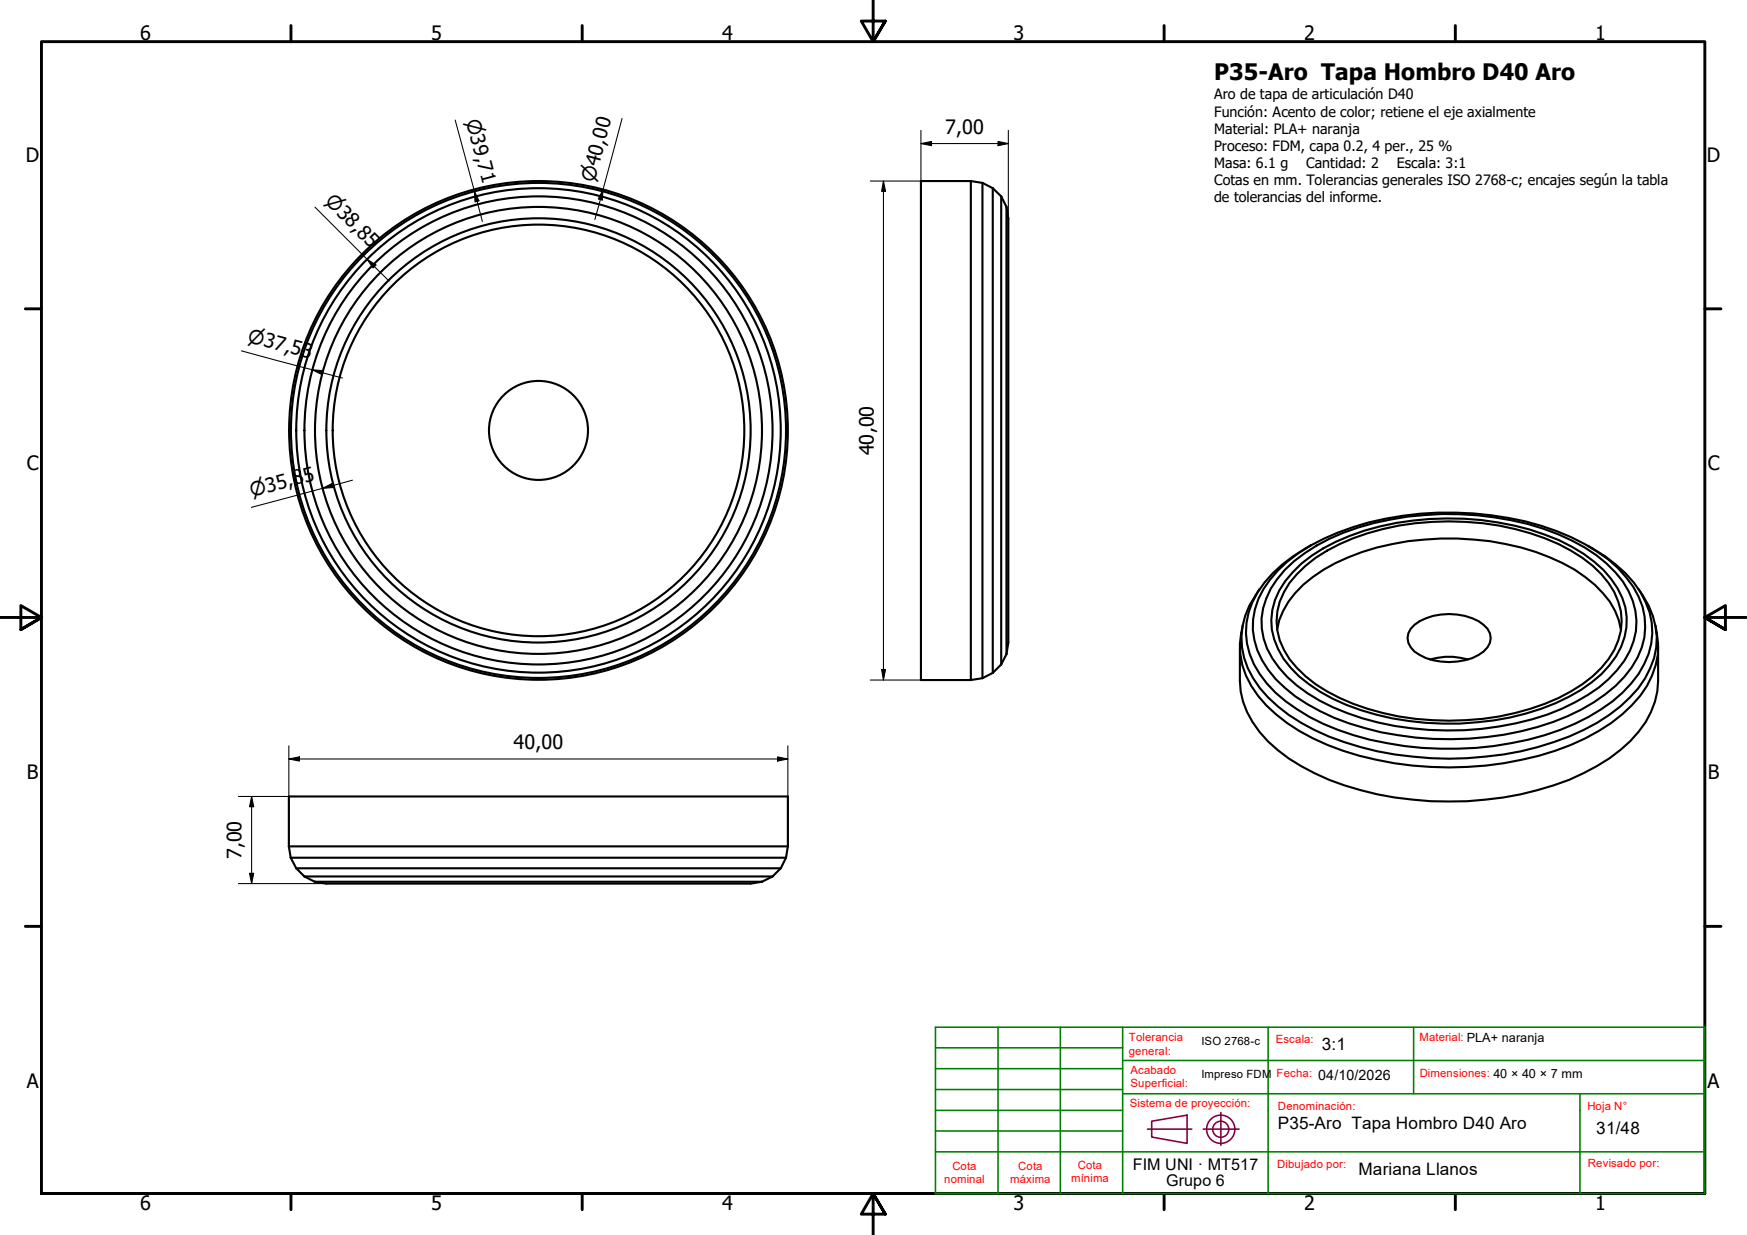
[picture p55: page 31]
Masa: 6.1 g; Cantidad: 2; Escala: 3:1

P35-Aro Tapa Hombro D40 Aro
Aro de tapa de articulación D40
Función: Acento de color; retiene el eje axialmente
Material: PLA+ naranja
Proceso: FDM, capa 0.2, 4 per., 25 %
Cotas en mm. Tolerancias generales ISO 2768-c; encajes según la tabla
de tolerancias del informe.

Tolerancia ISO 2768-c general: | Escala: 3:1 | Material: PLA+ naranja

Acabado Impreso FDM Superficial: | Fecha: 04/10/2026 | Dimensiones: 40 × 40 × 7 mm

Sistema de proyección: | Denominación: P35-Aro Tapa Hombro D40 Aro | Hoja N° 31/48

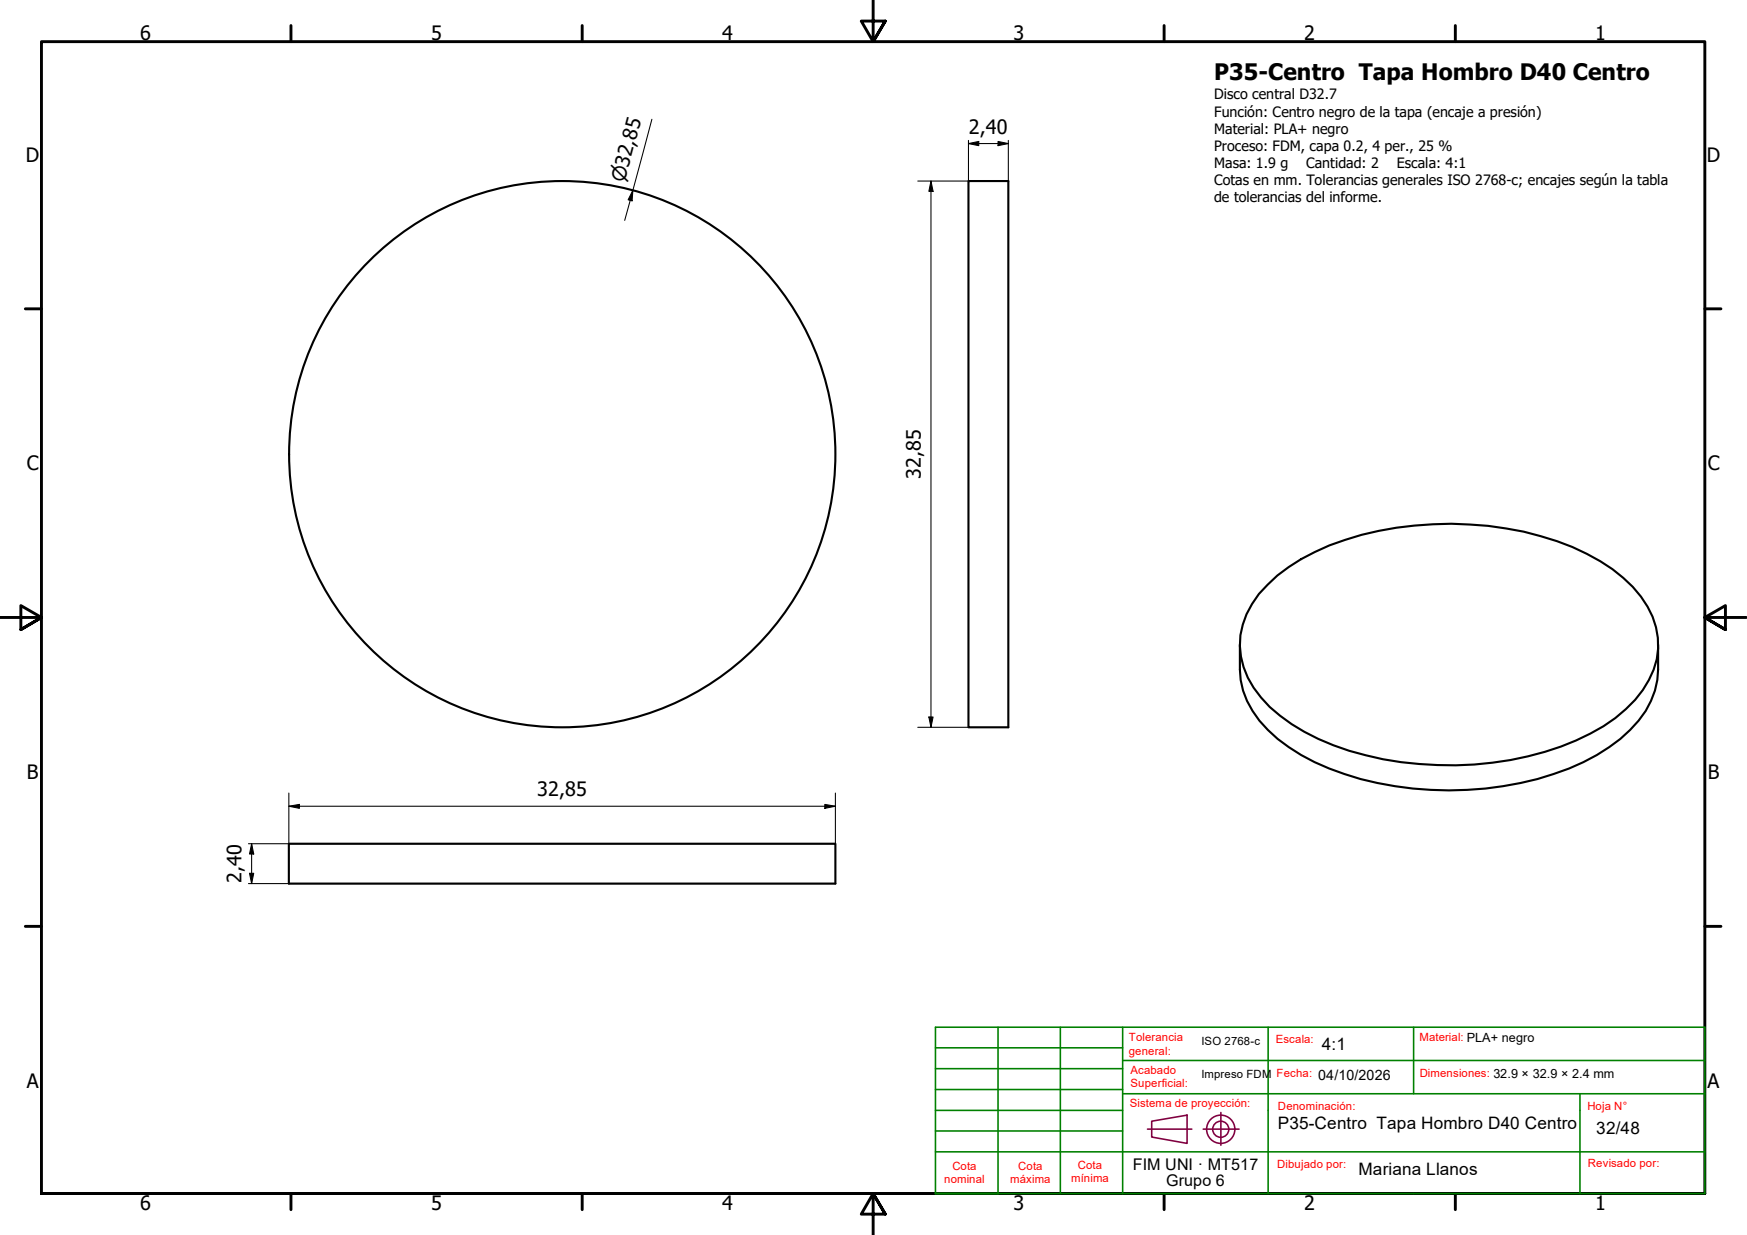
[picture p56: page 32]
Masa: 1.9 g; Cantidad: 2; Escala: 4:1

P35-Centro Tapa Hombro D40 Centro
Disco central D32.7
Función: Centro negro de la tapa (encaje a presión)
Material: PLA+ negro
Proceso: FDM, capa 0.2, 4 per., 25 %
Cotas en mm. Tolerancias generales ISO 2768-c; encajes según la tabla
de tolerancias del informe.

Tolerancia ISO 2768-c general: | Escala: 4:1 | Material: PLA+ negro

Acabado Impreso FDM Superficial: | Fecha: 04/10/2026 | Dimensiones: 32.9 × 32.9 × 2.4 mm

Sistema de proyección: | Denominación: P35-Centro Tapa Hombro D40 Centro | Hoja N° 32/48

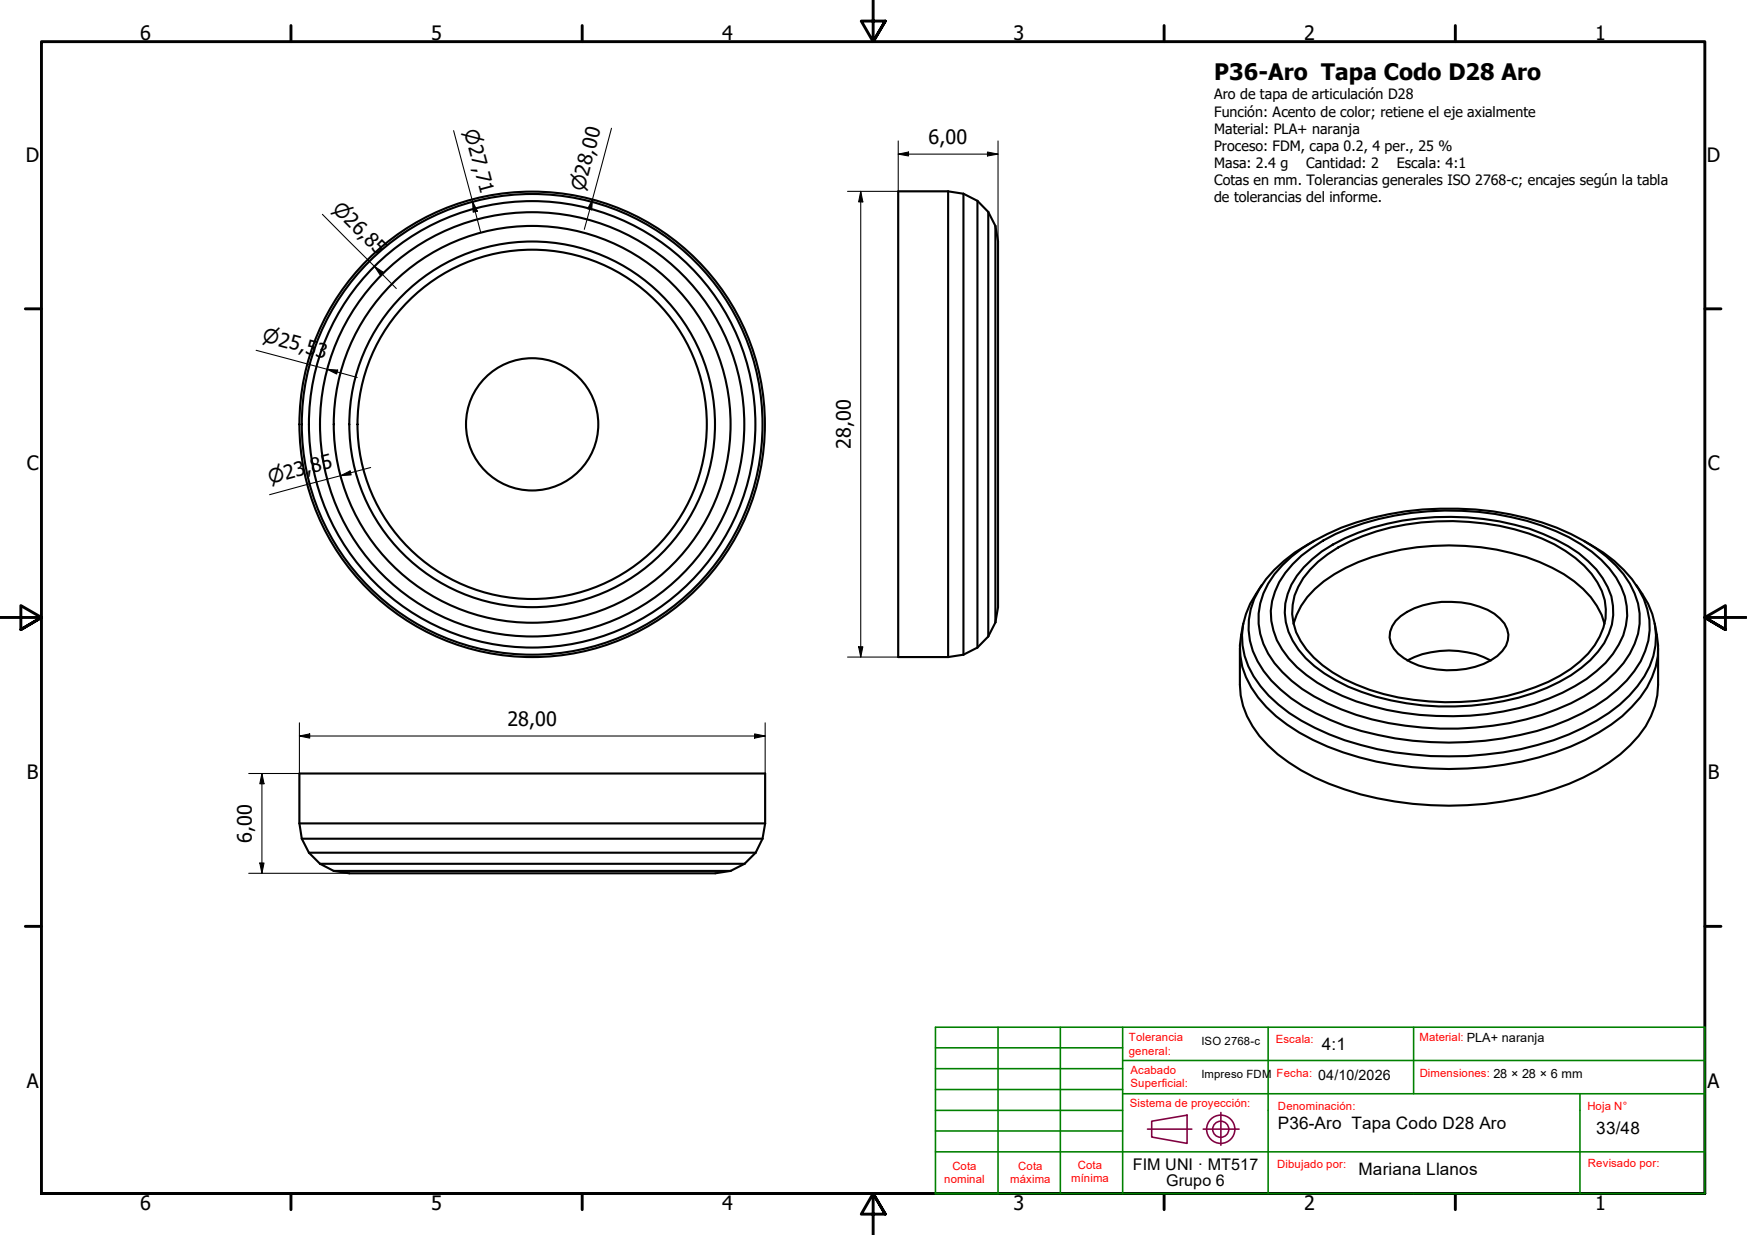
[picture p57: page 33]
Masa: 2.4 g; Cantidad: 2; Escala: 4:1

P36-Aro Tapa Codo D28 Aro
Aro de tapa de articulación D28
Función: Acento de color; retiene el eje axialmente
Material: PLA+ naranja
Proceso: FDM, capa 0.2, 4 per., 25 %
Cotas en mm. Tolerancias generales ISO 2768-c; encajes según la tabla
de tolerancias del informe.

Tolerancia ISO 2768-c general: | Escala: 4:1 | Material: PLA+ naranja

Acabado Impreso FDM Superficial: | Fecha: 04/10/2026 | Dimensiones: 28 × 28 × 6 mm

Sistema de proyección: | Denominación: P36-Aro Tapa Codo D28 Aro | Hoja N° 33/48

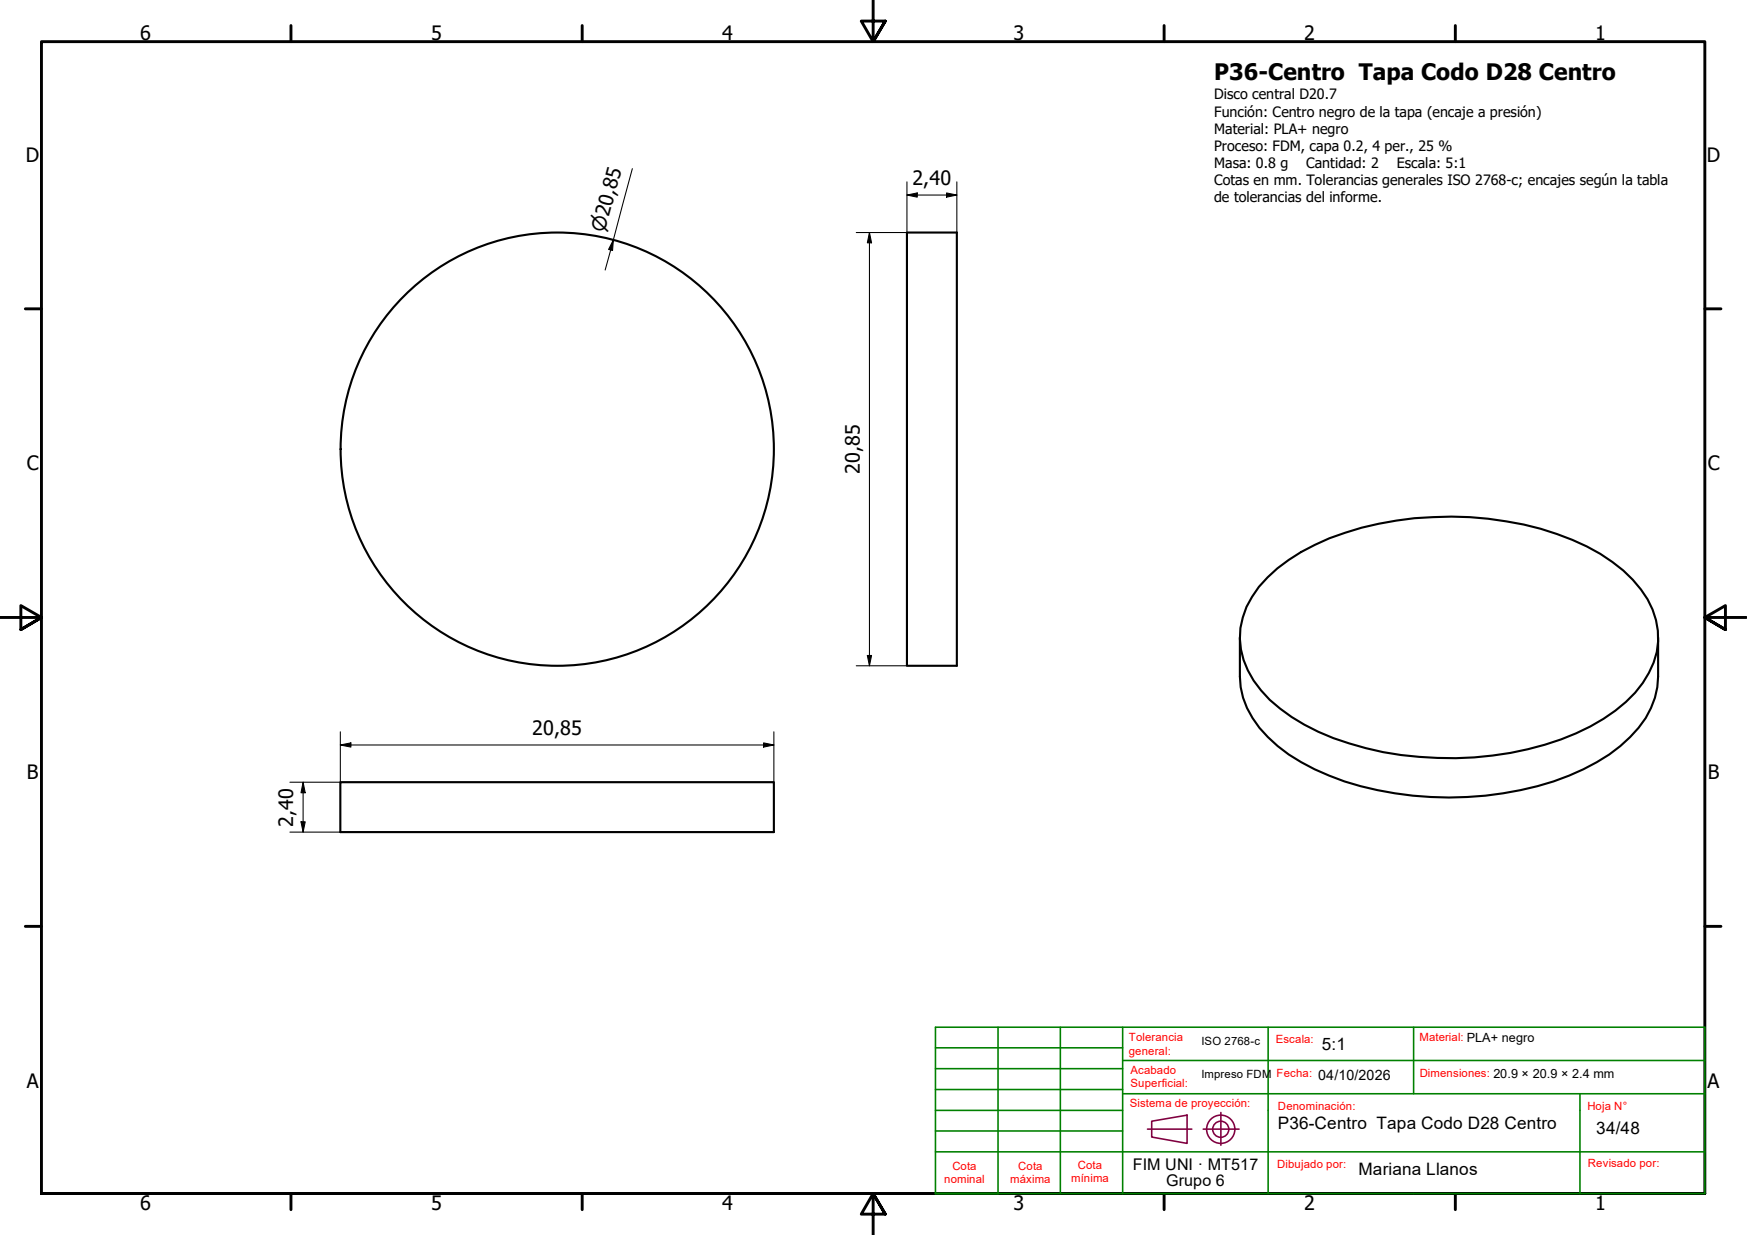
[picture p58: page 34]
Masa: 0.8 g; Cantidad: 2; Escala: 5:1

P36-Centro Tapa Codo D28 Centro
Disco central D20.7
Función: Centro negro de la tapa (encaje a presión)
Material: PLA+ negro
Proceso: FDM, capa 0.2, 4 per., 25 %
Cotas en mm. Tolerancias generales ISO 2768-c; encajes según la tabla
de tolerancias del informe.

Tolerancia ISO 2768-c general: | Escala: 5:1 | Material: PLA+ negro

Acabado Impreso FDM Superficial: | Fecha: 04/10/2026 | Dimensiones: 20.9 × 20.9 × 2.4 mm

Sistema de proyección: | Denominación: P36-Centro Tapa Codo D28 Centro | Hoja N° 34/48

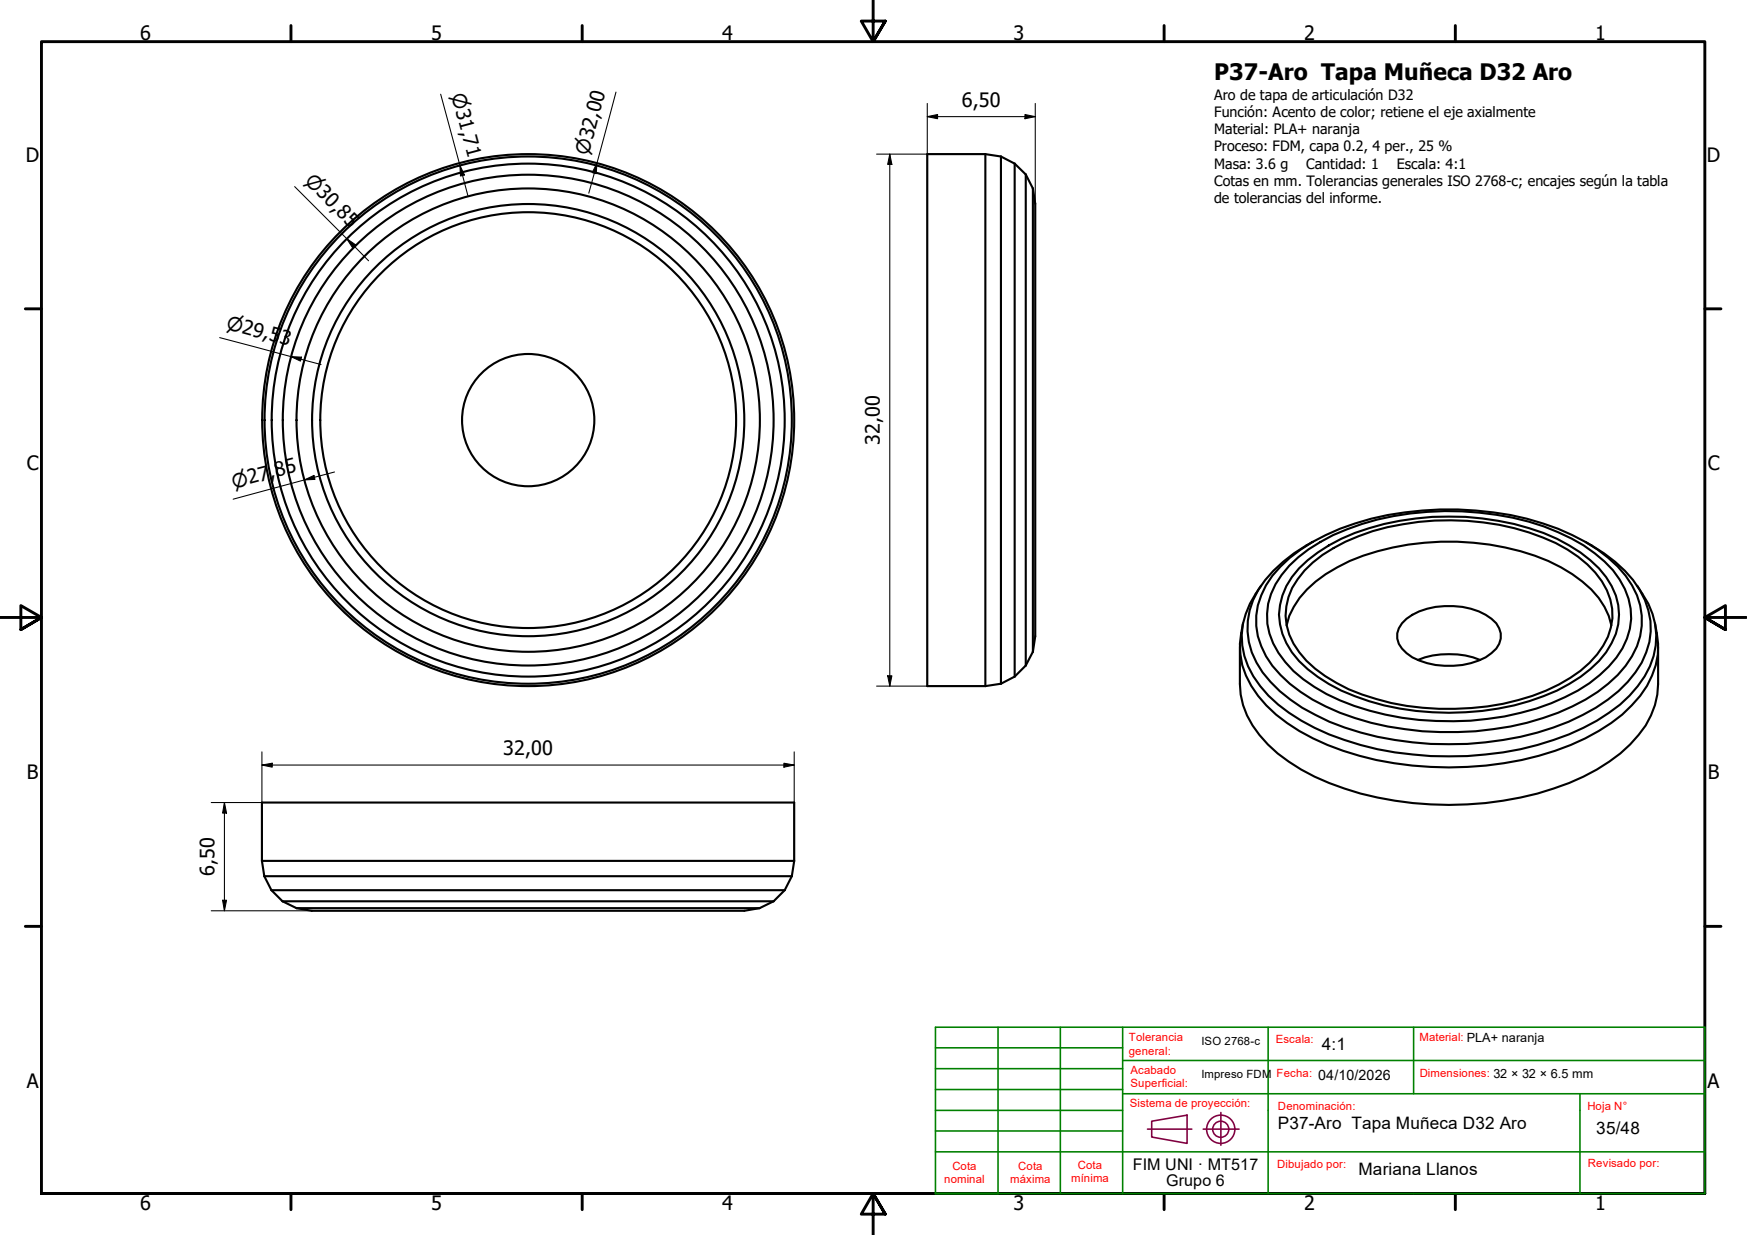
[picture p59: page 35]
Masa: 3.6 g; Cantidad: 1; Escala: 4:1

P37-Aro Tapa Muñeca D32 Aro
Aro de tapa de articulación D32
Función: Acento de color; retiene el eje axialmente
Material: PLA+ naranja
Proceso: FDM, capa 0.2, 4 per., 25 %
Cotas en mm. Tolerancias generales ISO 2768-c; encajes según la tabla
de tolerancias del informe.

Tolerancia ISO 2768-c general: | Escala: 4:1 | Material: PLA+ naranja

Acabado Impreso FDM Superficial: | Fecha: 04/10/2026 | Dimensiones: 32 × 32 × 6.5 mm

Sistema de proyección: | Denominación: P37-Aro Tapa Muñeca D32 Aro | Hoja N° 35/48

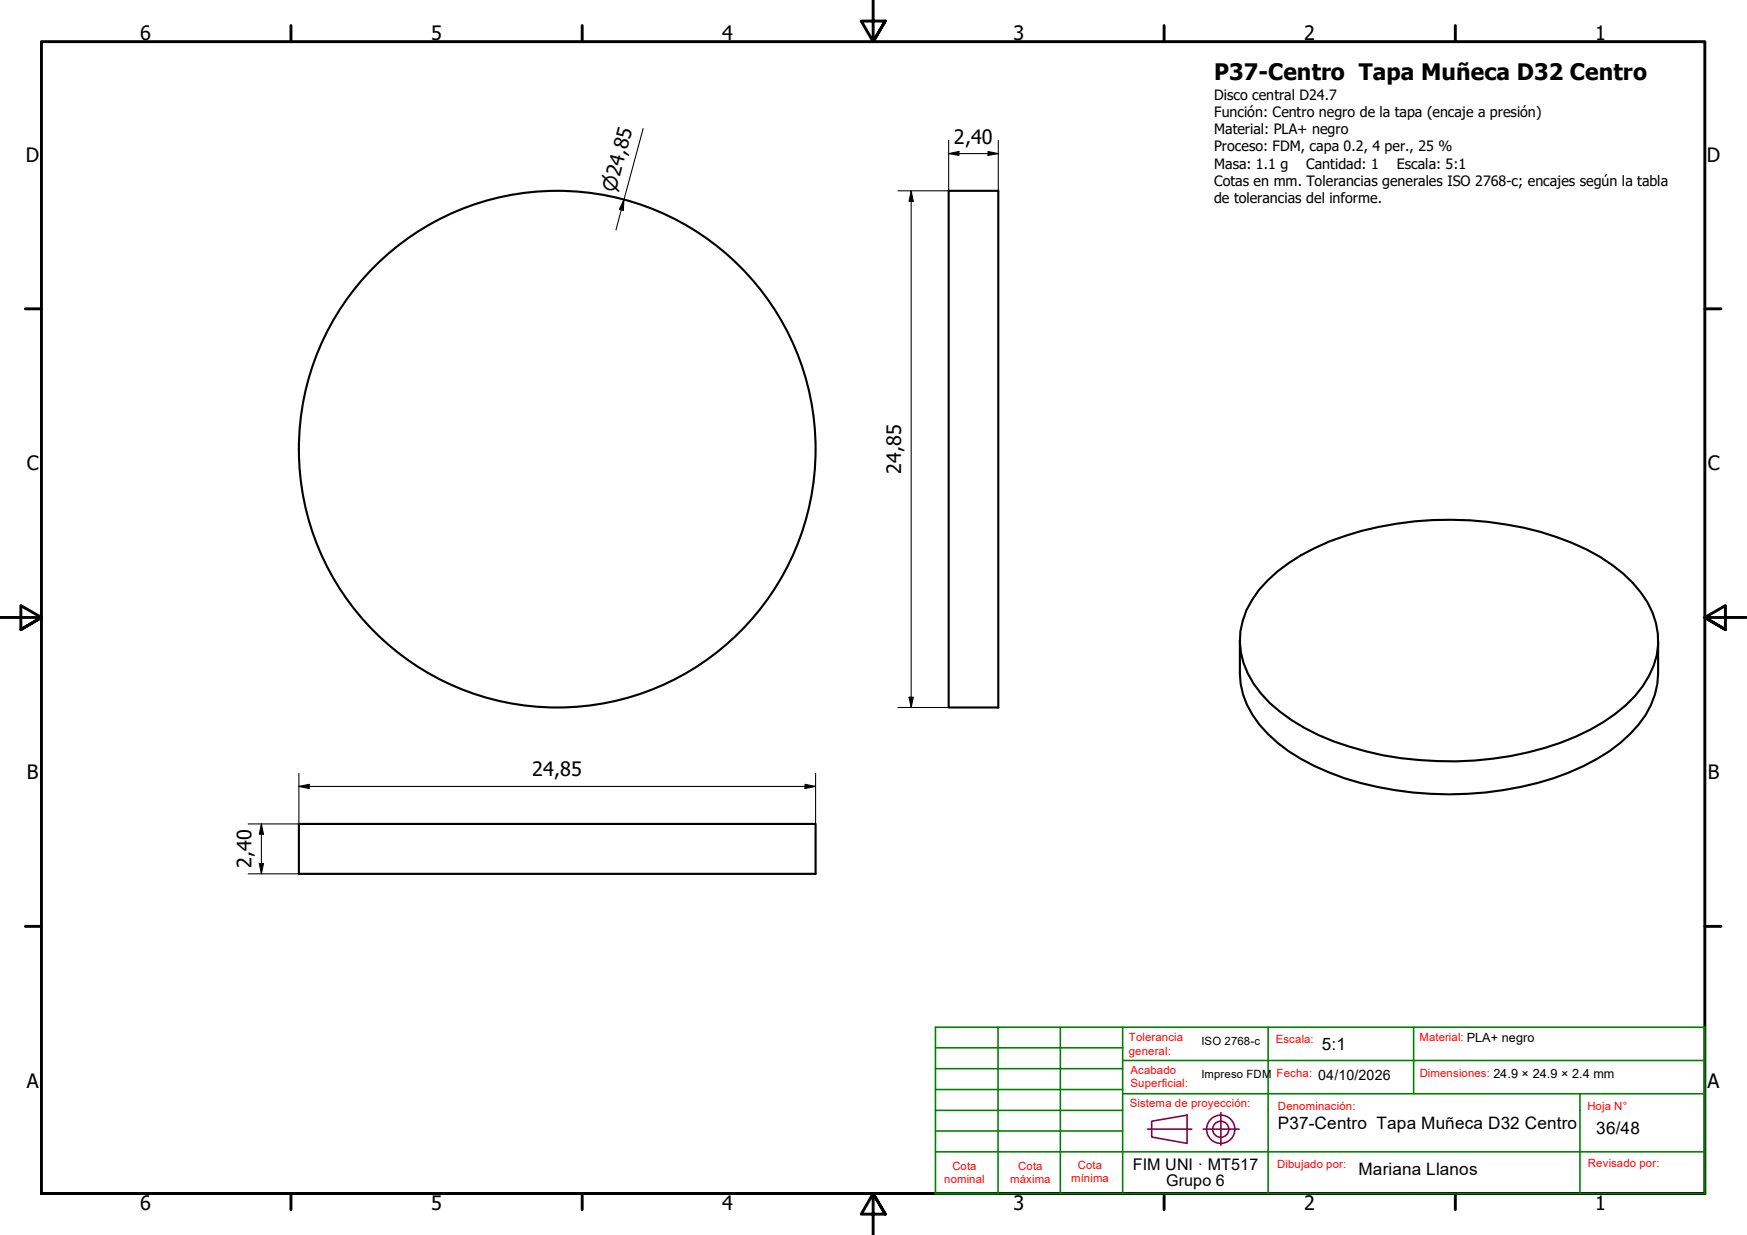
[picture p60: page 36]
Masa: 1.1 g; Cantidad: 1; Escala: 5:1

P37-Centro Tapa Muñeca D32 Centro

Disco central D24.7
Función: Centro negro de la tapa (encaje a presión)
Material: PLA+ negro
Proceso: FDM, capa 0.2, 4 per., 25 %
Cotas en mm. Tolerancias generales ISO 2768-c; encajes según la tabla
de tolerancias del informe.

Tolerancia ISO 2768-c general: | Escala: 5:1 | Material: PLA+ negro

Acabado Impreso FDM Superficial: | Fecha: 04/10/2026 | Dimensiones: 24.9 × 24.9 × 2.4 mm

Sistema de proyección: | Denominación: P37-Centro Tapa Muñeca D32 Centro | Hoja N° 36/48

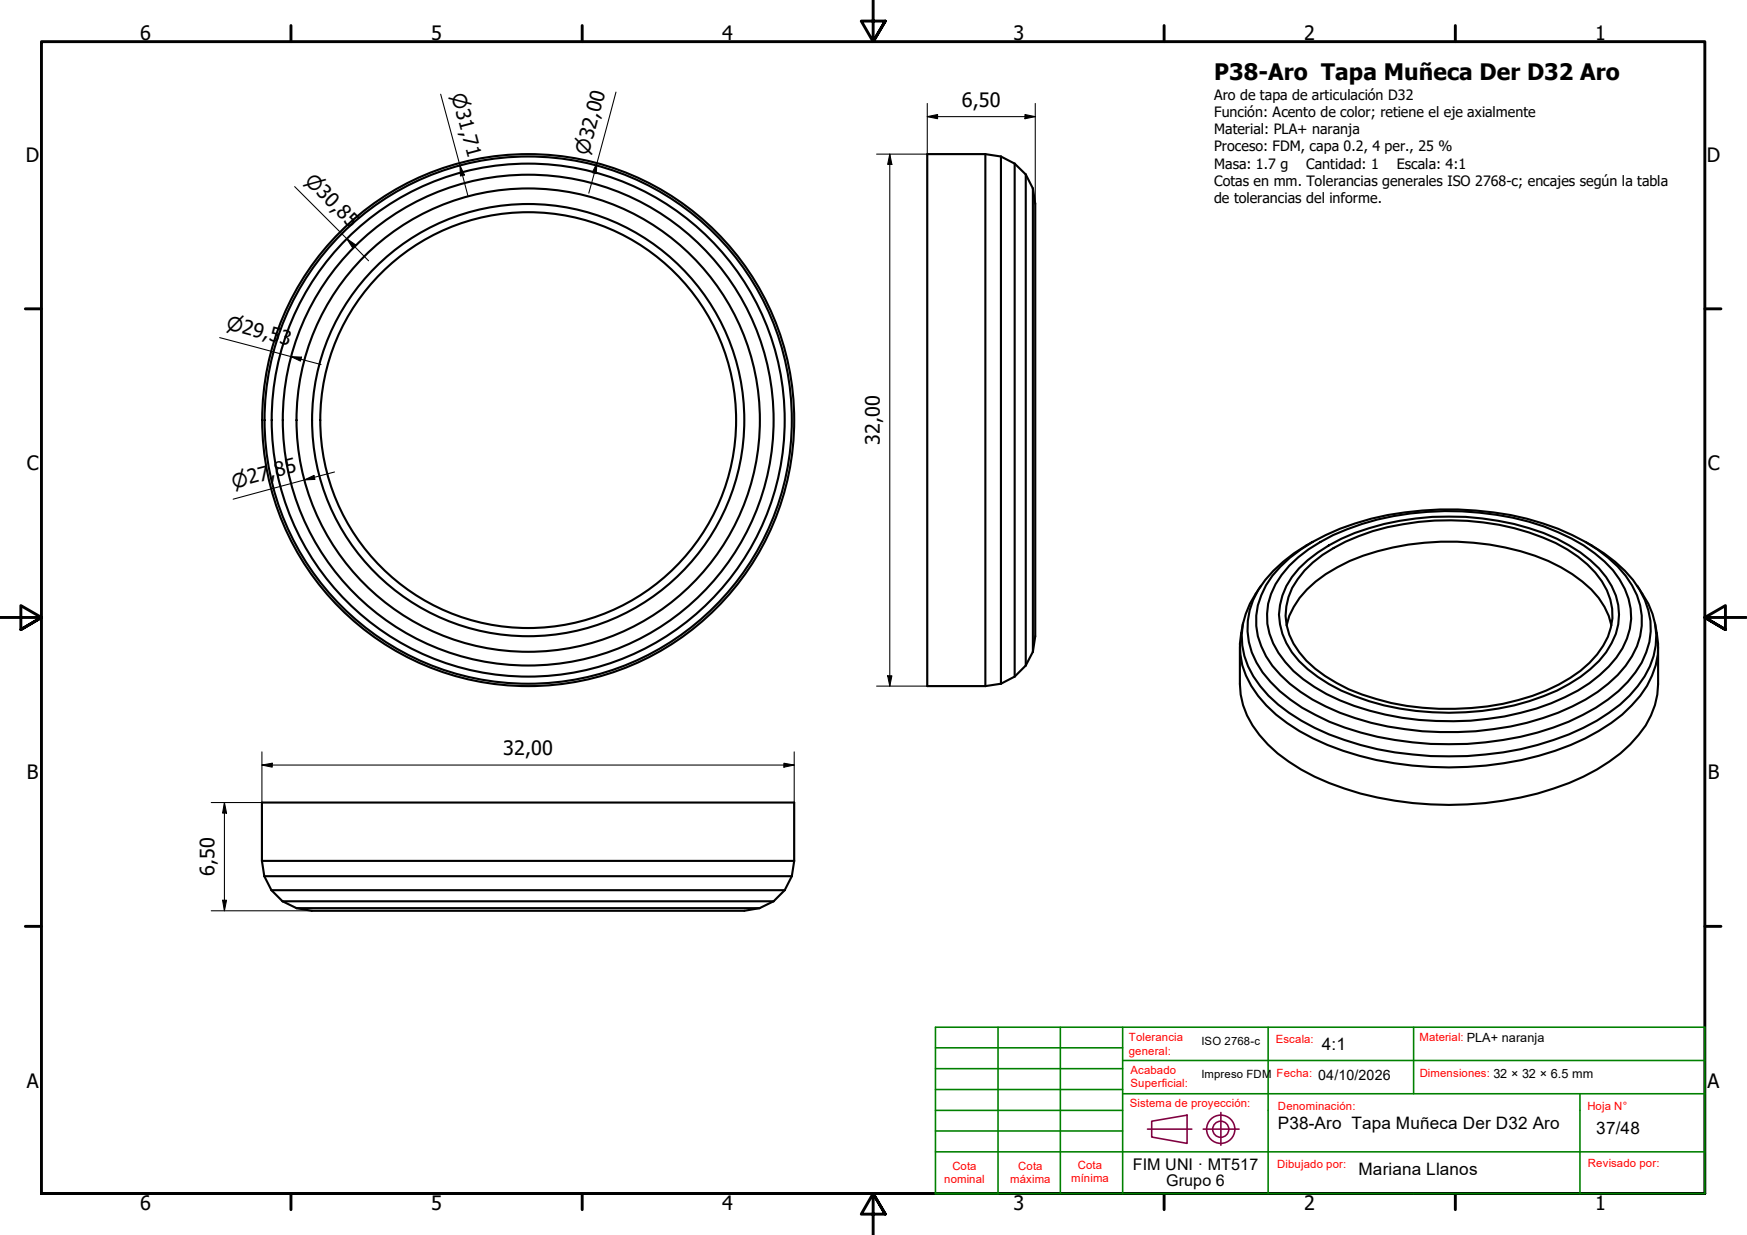
[picture p61: page 37]
Masa: 1.7 g; Cantidad: 1; Escala: 4:1

P38-Aro Tapa Muñeca Der D32 Aro
Aro de tapa de articulación D32
Función: Acento de color; retiene el eje axialmente
Material: PLA+ naranja
Proceso: FDM, capa 0.2, 4 per., 25 %
Cotas en mm. Tolerancias generales ISO 2768-c; encajes según la tabla
de tolerancias del informe.

Tolerancia ISO 2768-c general: | Escala: 4:1 | Material: PLA+ naranja

Acabado Impreso FDM Superficial: | Fecha: 04/10/2026 | Dimensiones: 32 × 32 × 6.5 mm

Sistema de proyección: | Denominación: P38-Aro Tapa Muñeca Der D32 Aro | Hoja N° 37/48

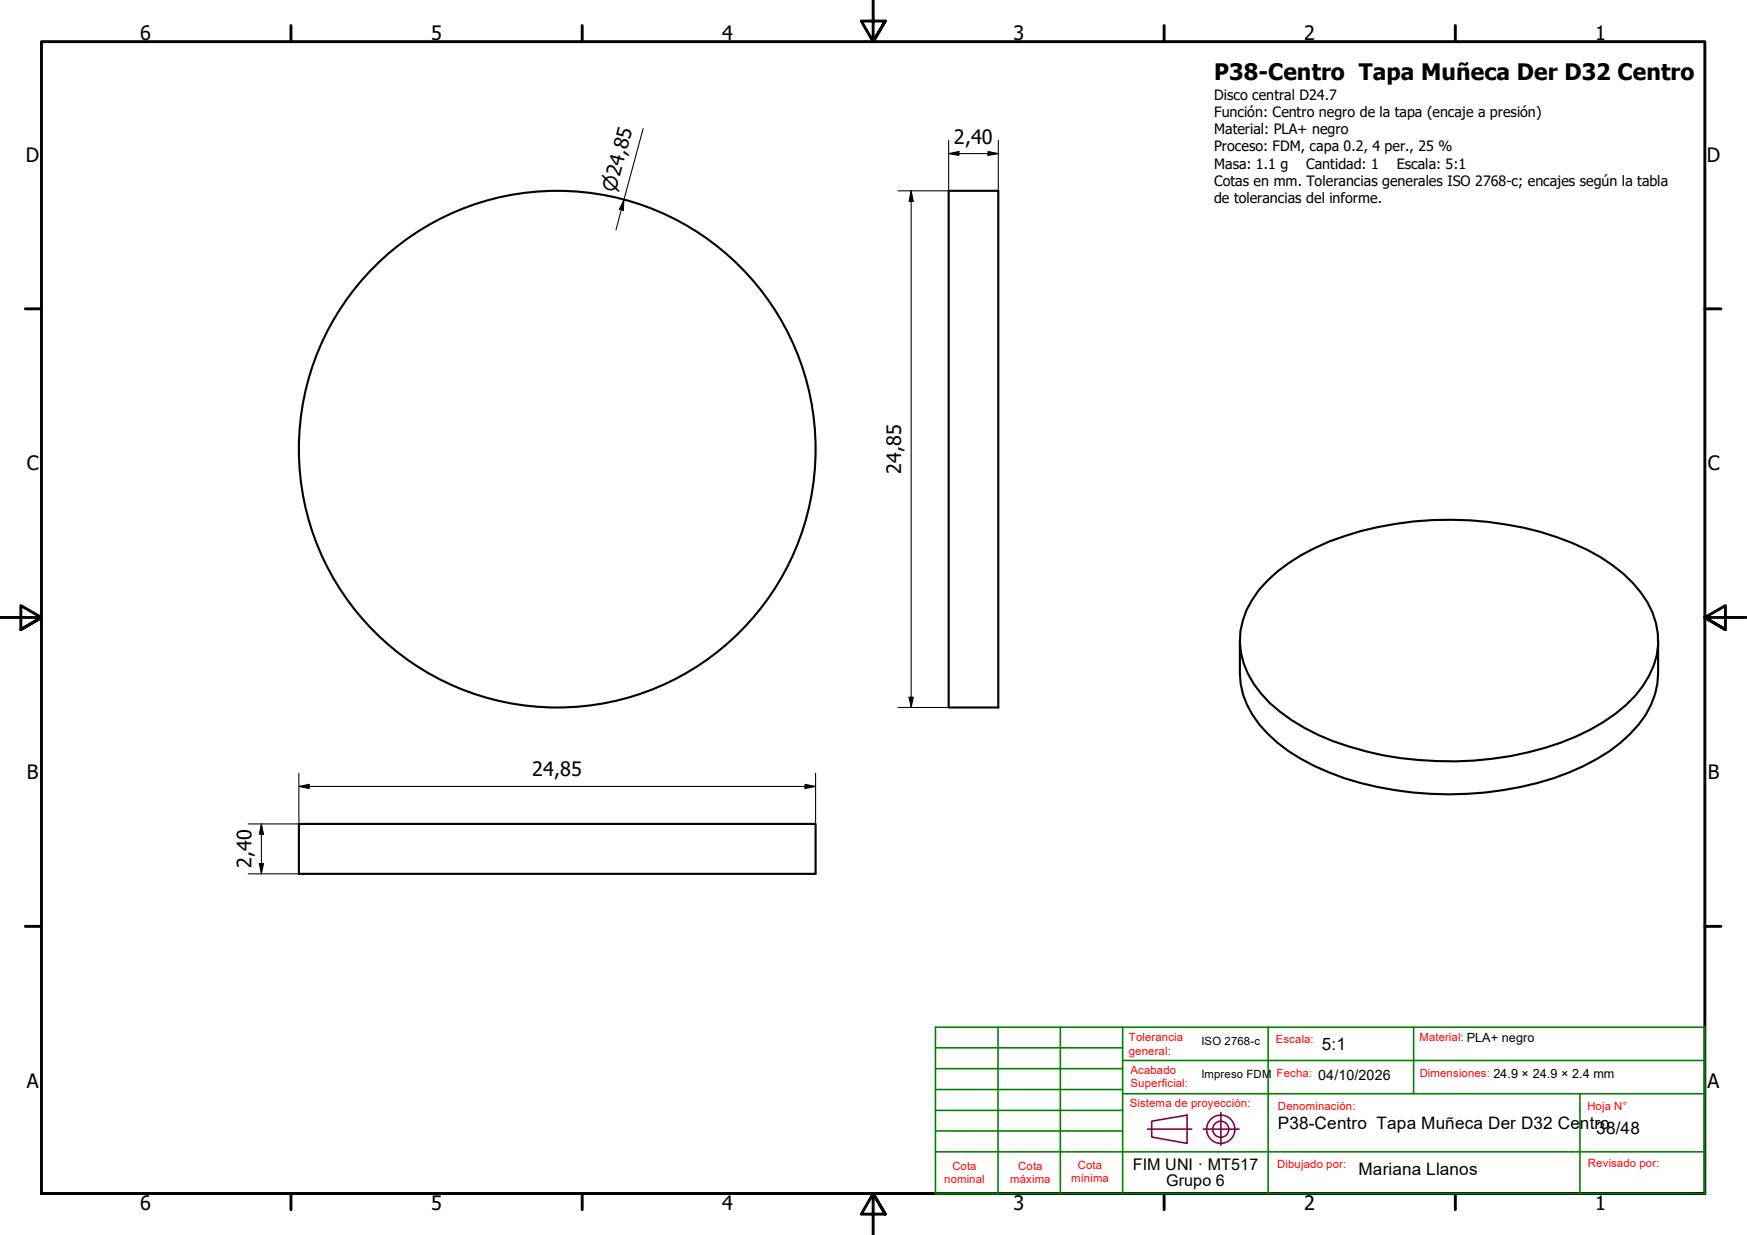
[picture p62: page 38]
Masa: 1.1 g; Cantidad: 1; Escala: 5:1

P38-Centro Tapa Muñeca Der D32 Centro

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

Tolerancia ISO 2768-c general: | Escala: 5:1 | Material: PLA+ negro

Acabado Impreso FDM Superficial: | Fecha: 04/10/2026 | Dimensiones: 24.9 × 24.9 × 2.4 mm

Sistema de proyección: | Denominación: P38-Centro Tapa Muñeca Der D32 Centro | Hoja N° 38/48

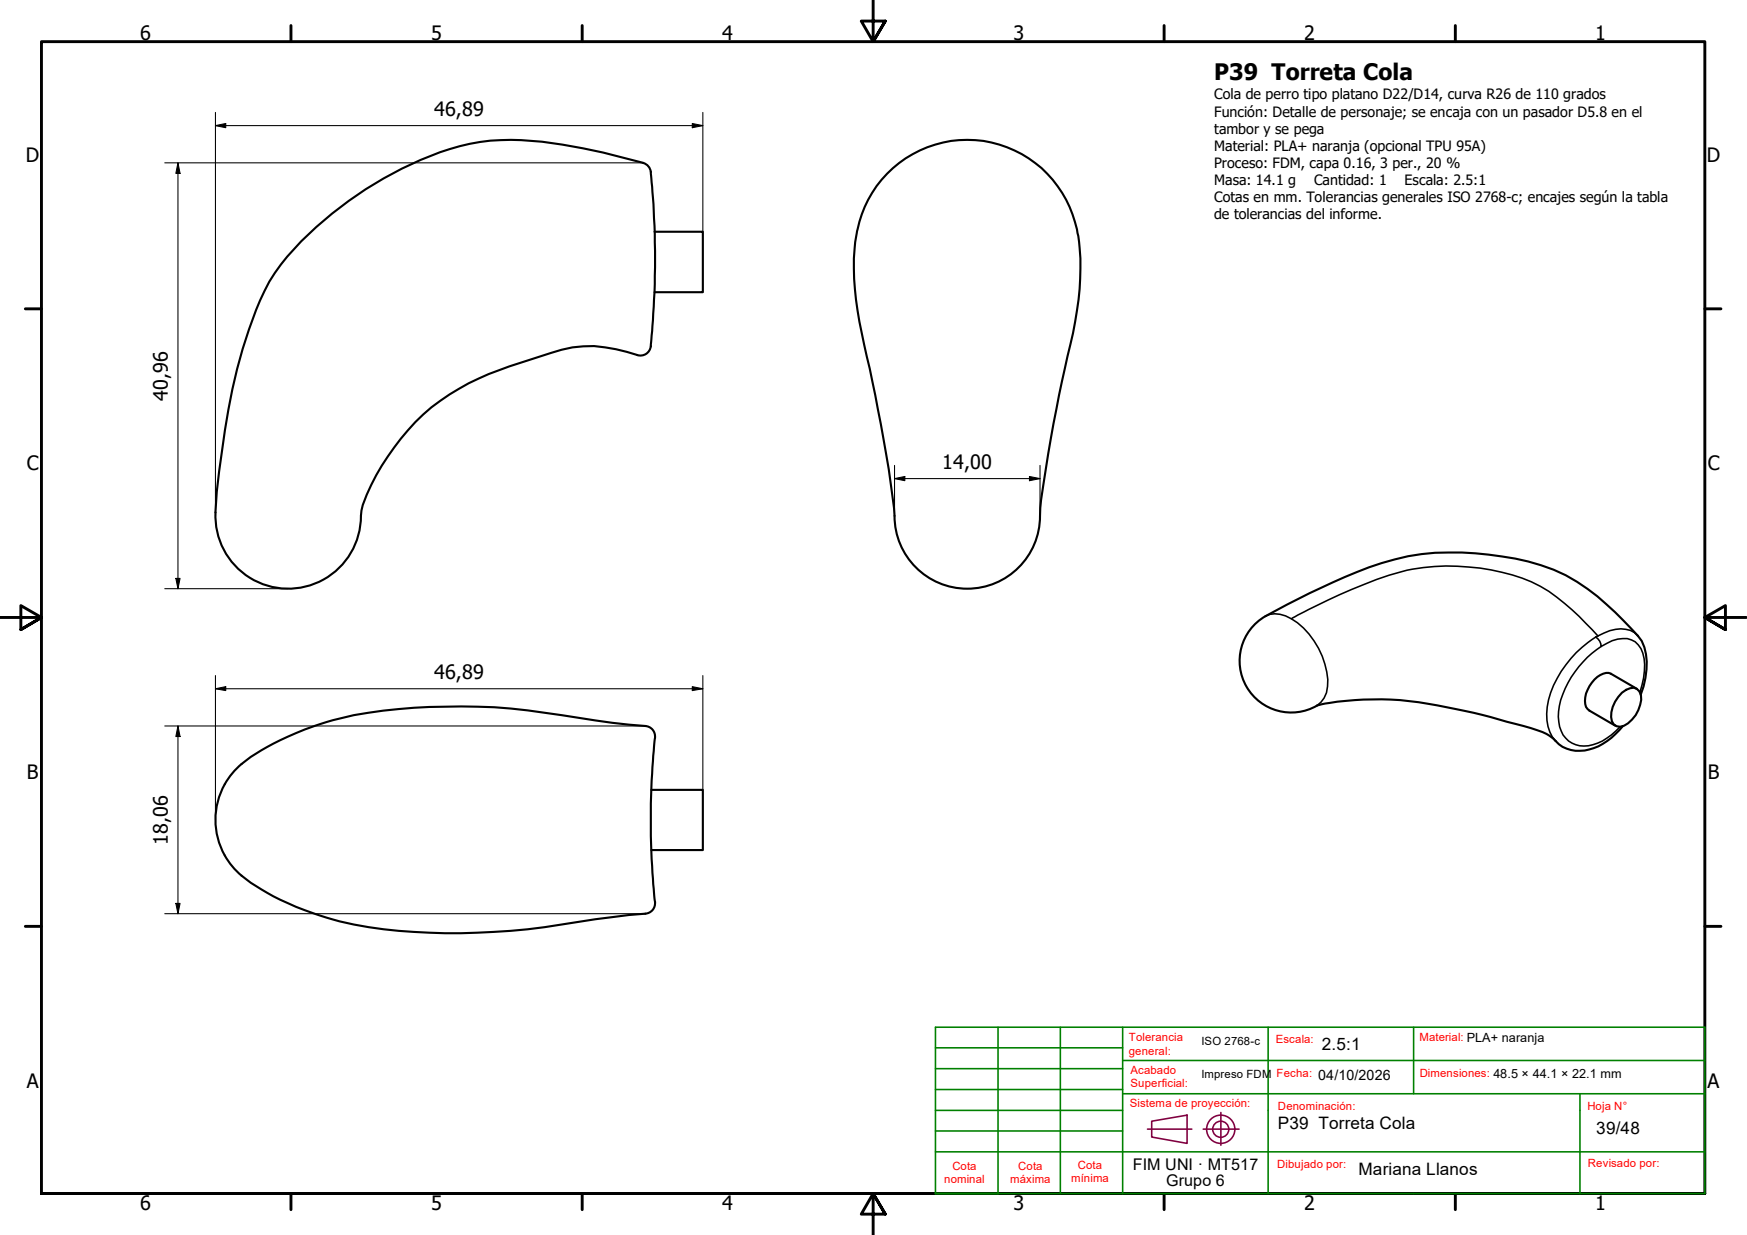
[picture p63: page 39]
Masa: 14.1 g; Cantidad: 1; Escala: 2.5:1

P39 Torreta Cola
Cola de perro tipo platano D22/D14, curva R26 de 110 grados
Función: Detalle de personaje; se encaja con un pasador D5.8 en el
tambor y se pega
Material: PLA+ naranja (opcional TPU 95A)
Proceso: FDM, capa 0.16, 3 per., 20 %
Cotas en mm. Tolerancias generales ISO 2768-c; encajes según la tabla
de tolerancias del informe.

Tolerancia ISO 2768-c general: | Escala: 2.5:1 | Material: PLA+ naranja

Acabado Impreso FDM Superficial: | Fecha: 04/10/2026 | Dimensiones: 48.5 × 44.1 × 22.1 mm

Sistema de proyección: | Denominación: P39 Torreta Cola | Hoja N° 39/48

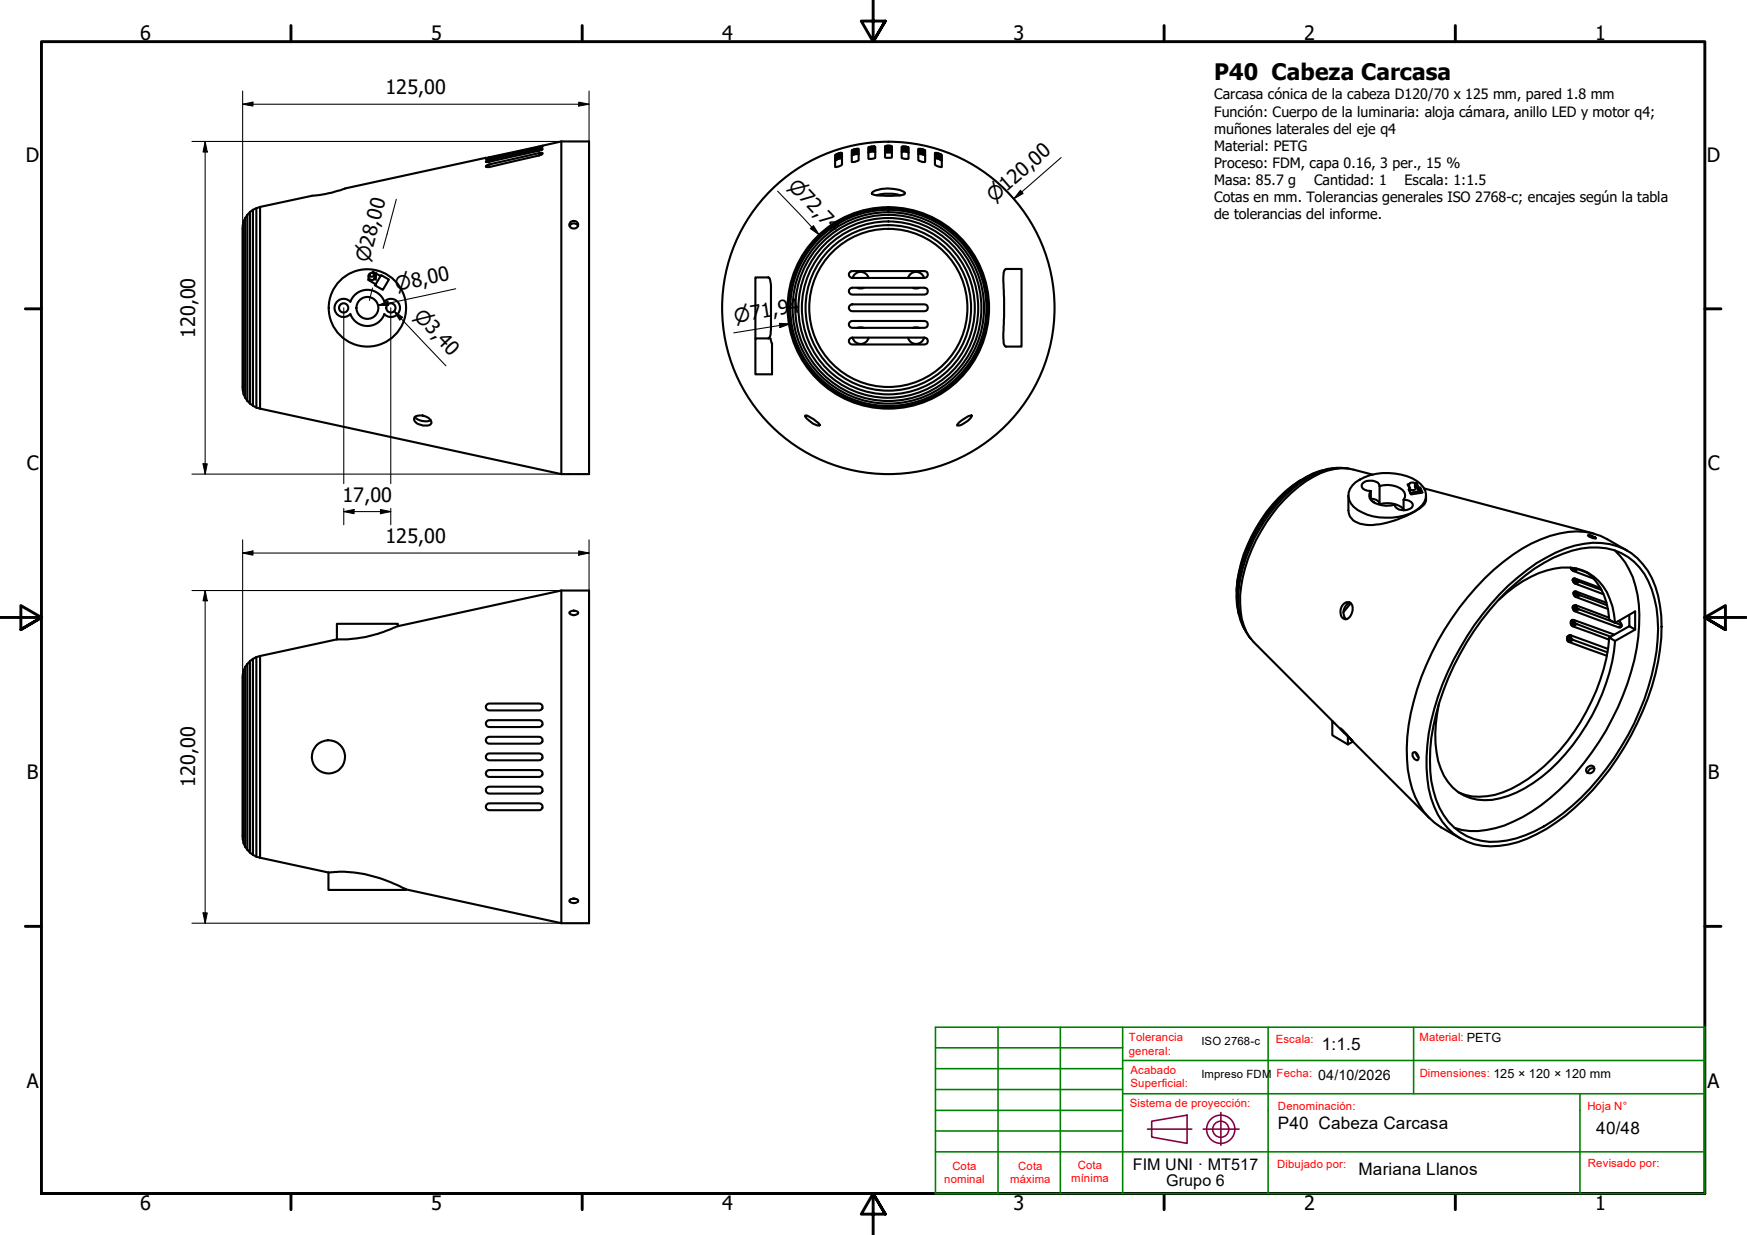
[picture p64: page 40]
Masa: 85.7 g; Cantidad: 1; Escala: 1:1.5

P40 Cabeza Carcasa
Carcasa cónica de la cabeza D120/70 x 125 mm, pared 1.8 mm
Función: Cuerpo de la luminaria: aloja cámara, anillo LED y motor q4;
muñones laterales del eje q4
Material: PETG
Proceso: FDM, capa 0.16, 3 per., 15 %
Cotas en mm. Tolerancias generales ISO 2768-c; encajes según la tabla
de tolerancias del informe.

Tolerancia ISO 2768-c general: | Escala: 1:1.5 | Material: PETG

Acabado Impreso FDM Superficial: | Fecha: 04/10/2026 | Dimensiones: 125 × 120 × 120 mm

Sistema de proyección: | Denominación: P40 Cabeza Carcasa | Hoja N° 40/48

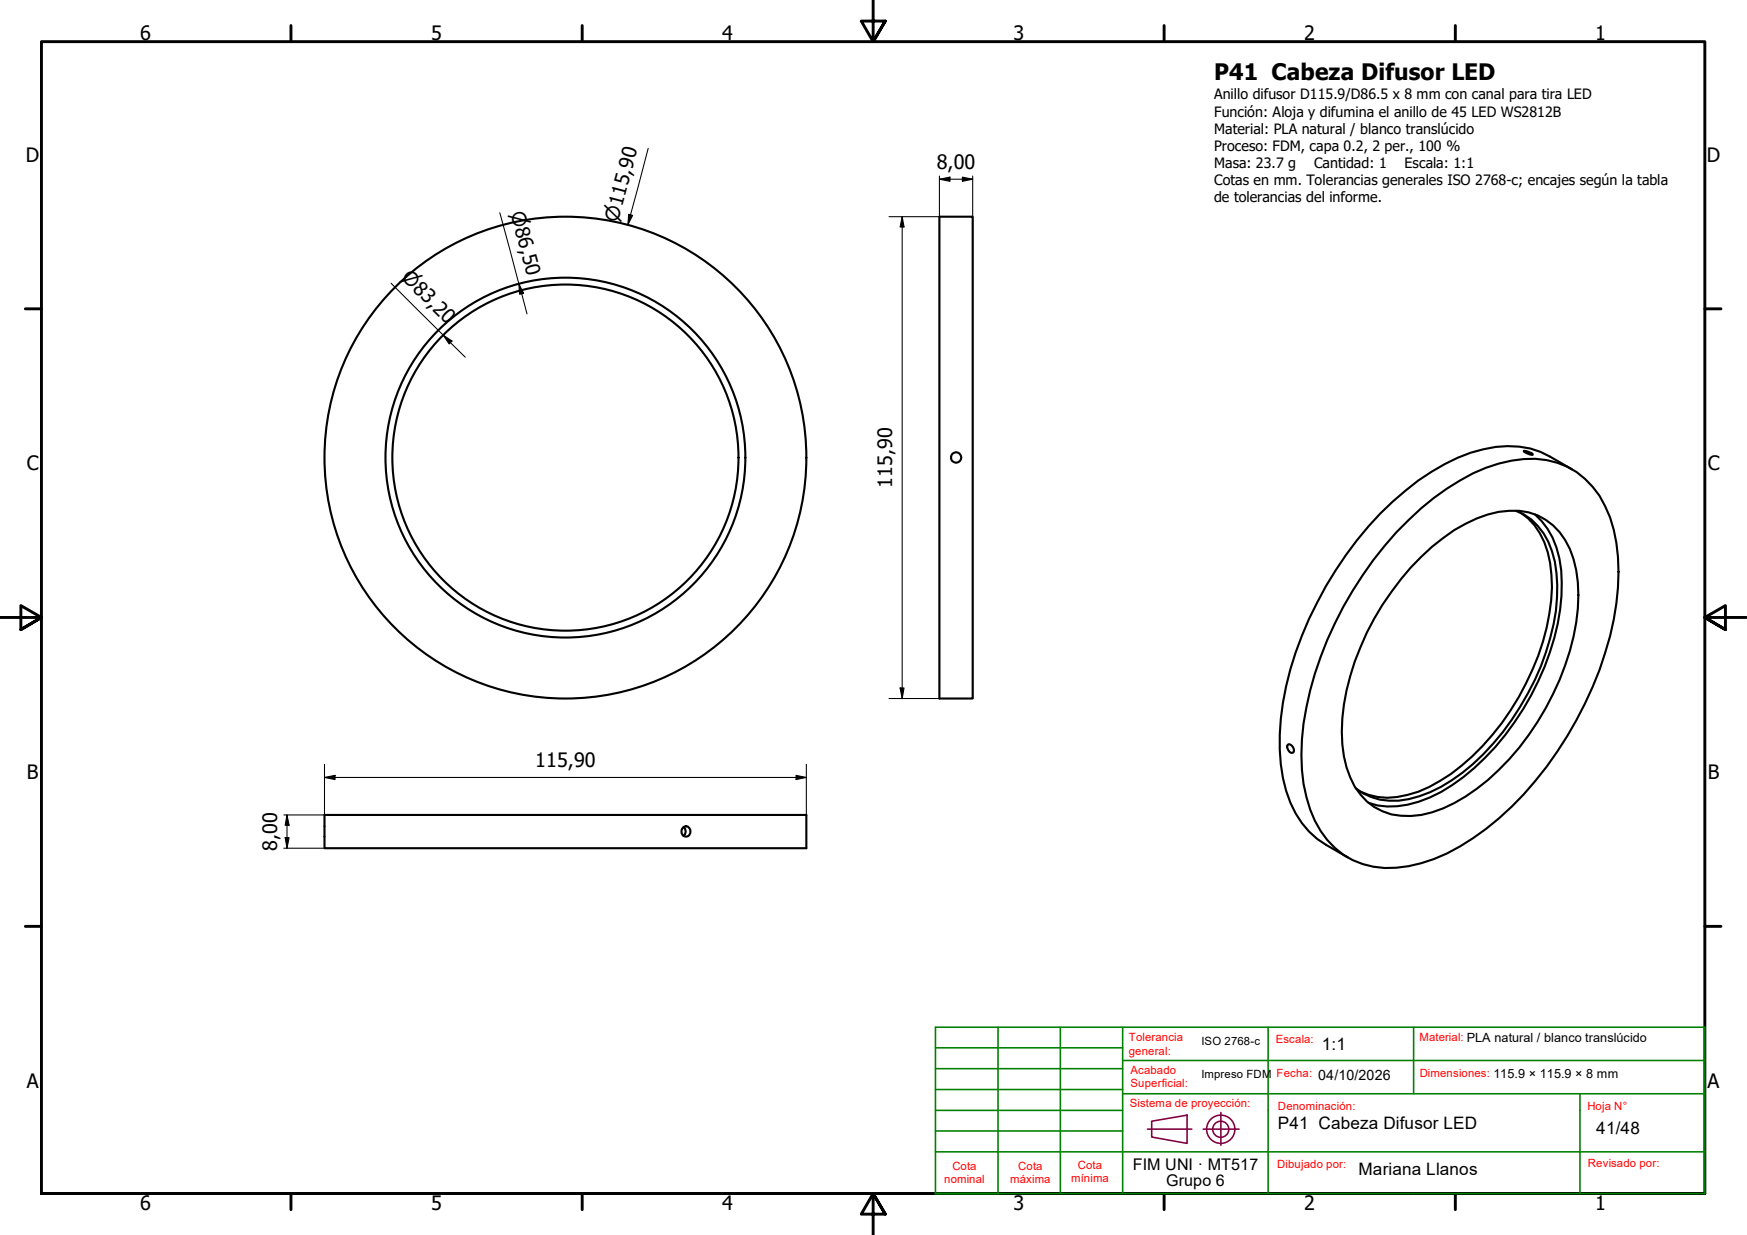
[picture p65: page 41]
Masa: 23.7 g; Cantidad: 1; Escala: 1:1

P41 Cabeza Difusor LED
Anillo difusor D115.9/D86.5 x 8 mm con canal para tira LED
Función: Aloja y difumina el anillo de 45 LED WS2812B
Material: PLA natural / blanco translúcido
Proceso: FDM, capa 0.2, 2 per., 100 %
Cotas en mm. Tolerancias generales ISO 2768-c; encajes según la tabla
de tolerancias del informe.

Tolerancia ISO 2768-c general: | Escala: 1:1 | Material: PLA natural / blanco translúcido

Acabado Impreso FDM Superficial: | Fecha: 04/10/2026 | Dimensiones: 115.9 × 115.9 × 8 mm

Sistema de proyección: | Denominación: P41 Cabeza Difusor LED | Hoja N° 41/48

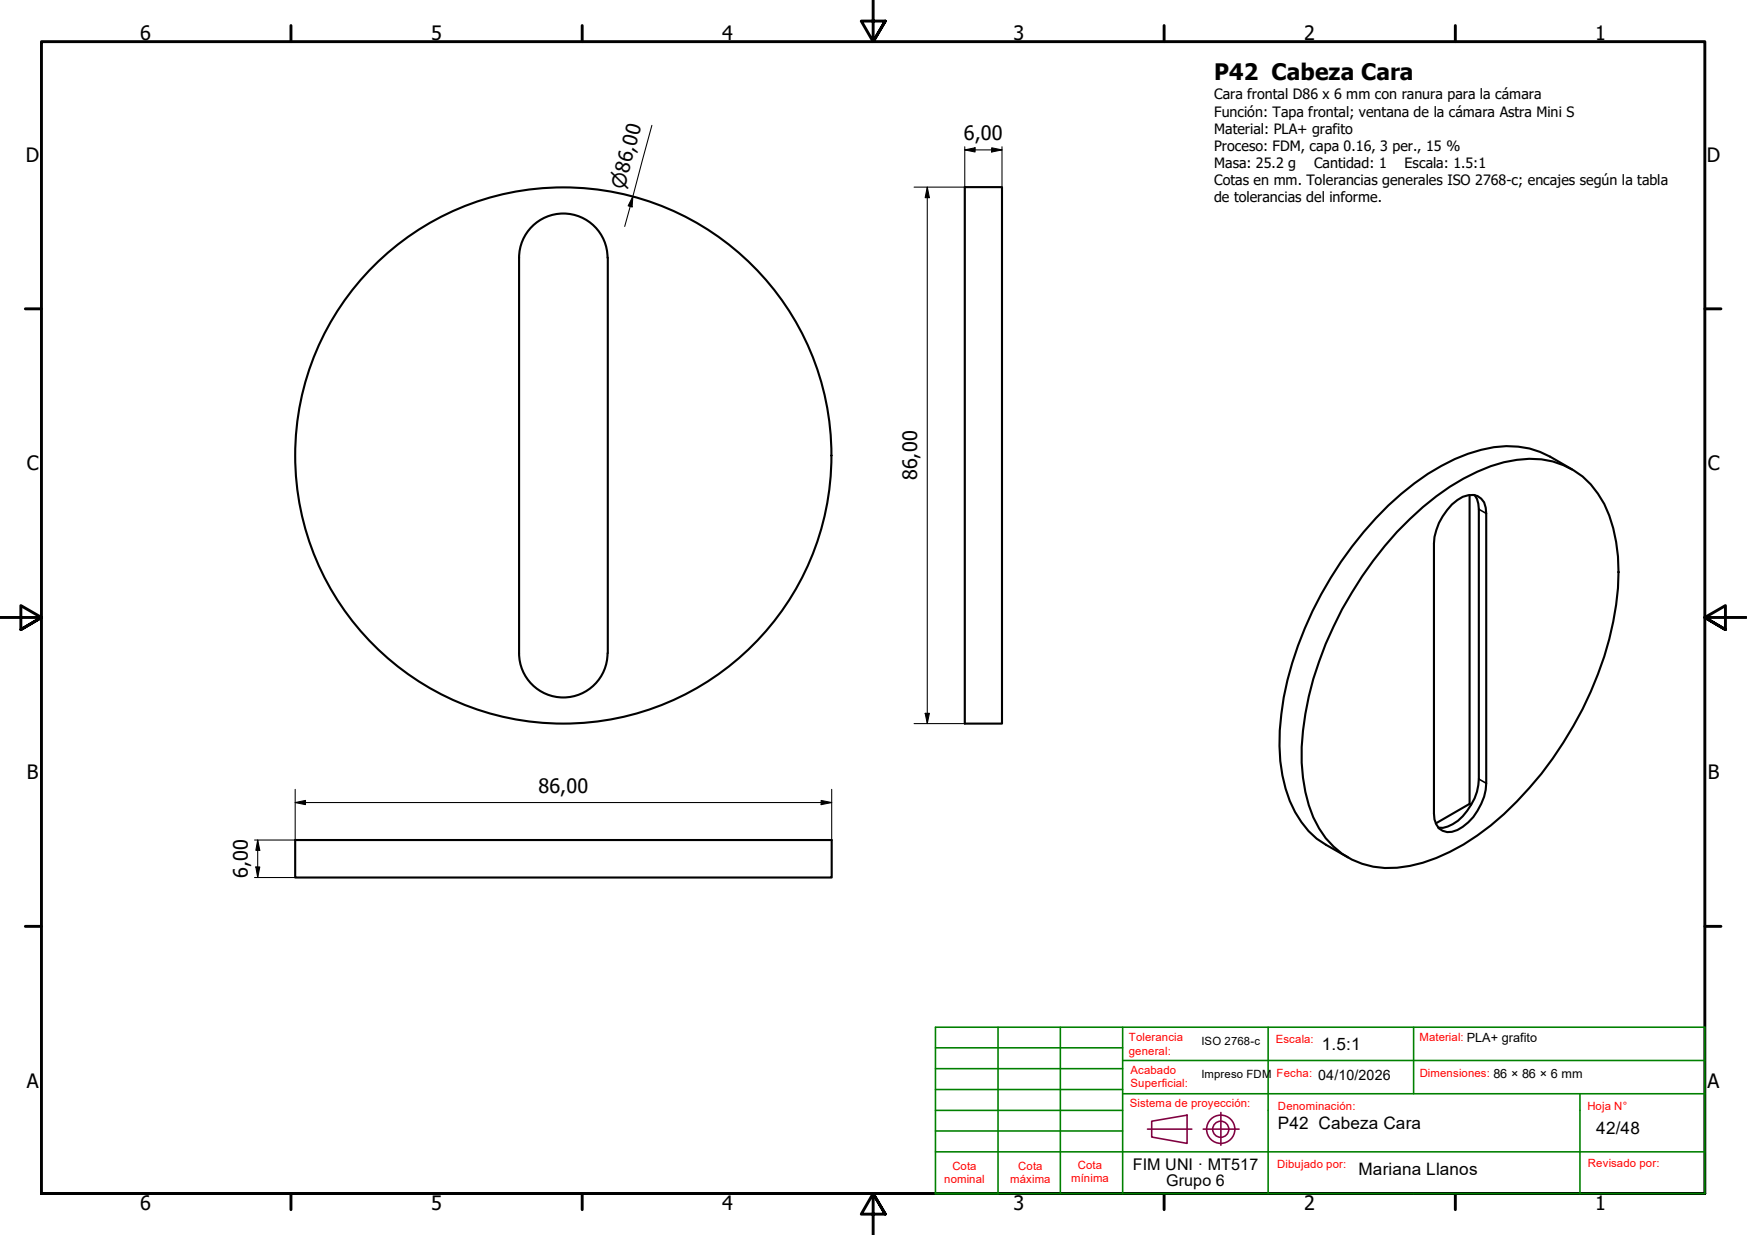
[picture p66: page 42]
Masa: 25.2 g; Cantidad: 1; Escala: 1.5:1

P42 Cabeza Cara
Cara frontal D86 x 6 mm con ranura para la cámara
Función: Tapa frontal; ventana de la cámara Astra Mini S
Material: PLA+ grafito
Proceso: FDM, capa 0.16, 3 per., 15 %
Cotas en mm. Tolerancias generales ISO 2768-c; encajes según la tabla
de tolerancias del informe.

Tolerancia ISO 2768-c general: | Escala: 1.5:1 | Material: PLA+ grafito

Acabado Impreso FDM Superficial: | Fecha: 04/10/2026 | Dimensiones: 86 × 86 × 6 mm

Sistema de proyección: | Denominación: P42 Cabeza Cara | Hoja N° 42/48

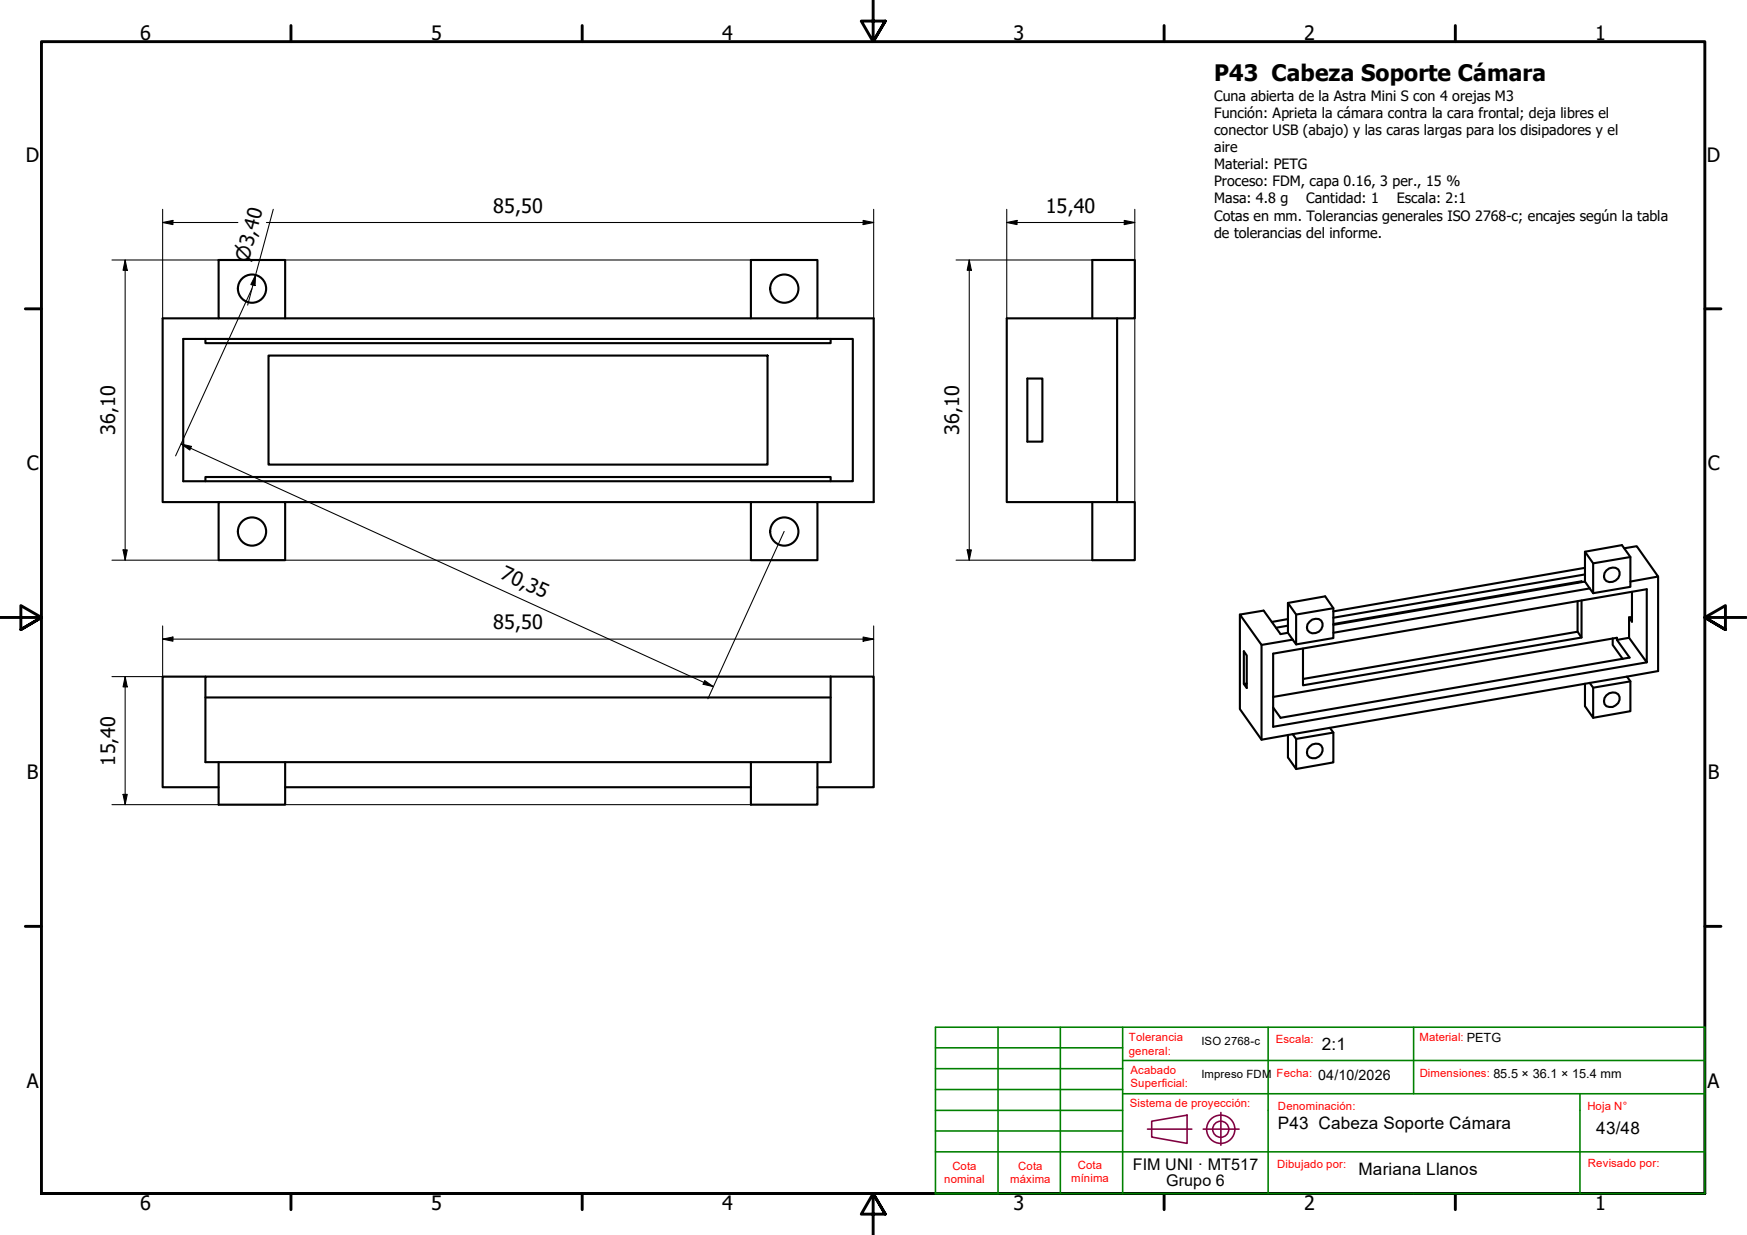
[picture p67: page 43]
Masa: 4.8 g; Cantidad: 1; Escala: 2:1

P43 Cabeza Soporte Cámara

Cuna abierta de la Astra Mini S con 4 orejas M3
Función: Aprieta la cámara contra la cara frontal; deja libres el
conector USB (abajo) y las caras largas para los disipadores y el
aire
Material: PETG
Proceso: FDM, capa 0.16, 3 per., 15 %
Cotas en mm. Tolerancias generales ISO 2768-c; encajes según la tabla
de tolerancias del informe.

Tolerancia ISO 2768-c general: | Escala: 2:1 | Material: PETG

Acabado Impreso FDM Superficial: | Fecha: 04/10/2026 | Dimensiones: 85.5 × 36.1 × 15.4 mm

Sistema de proyección: | Denominación: P43 Cabeza Soporte Cámara | Hoja N° 43/48

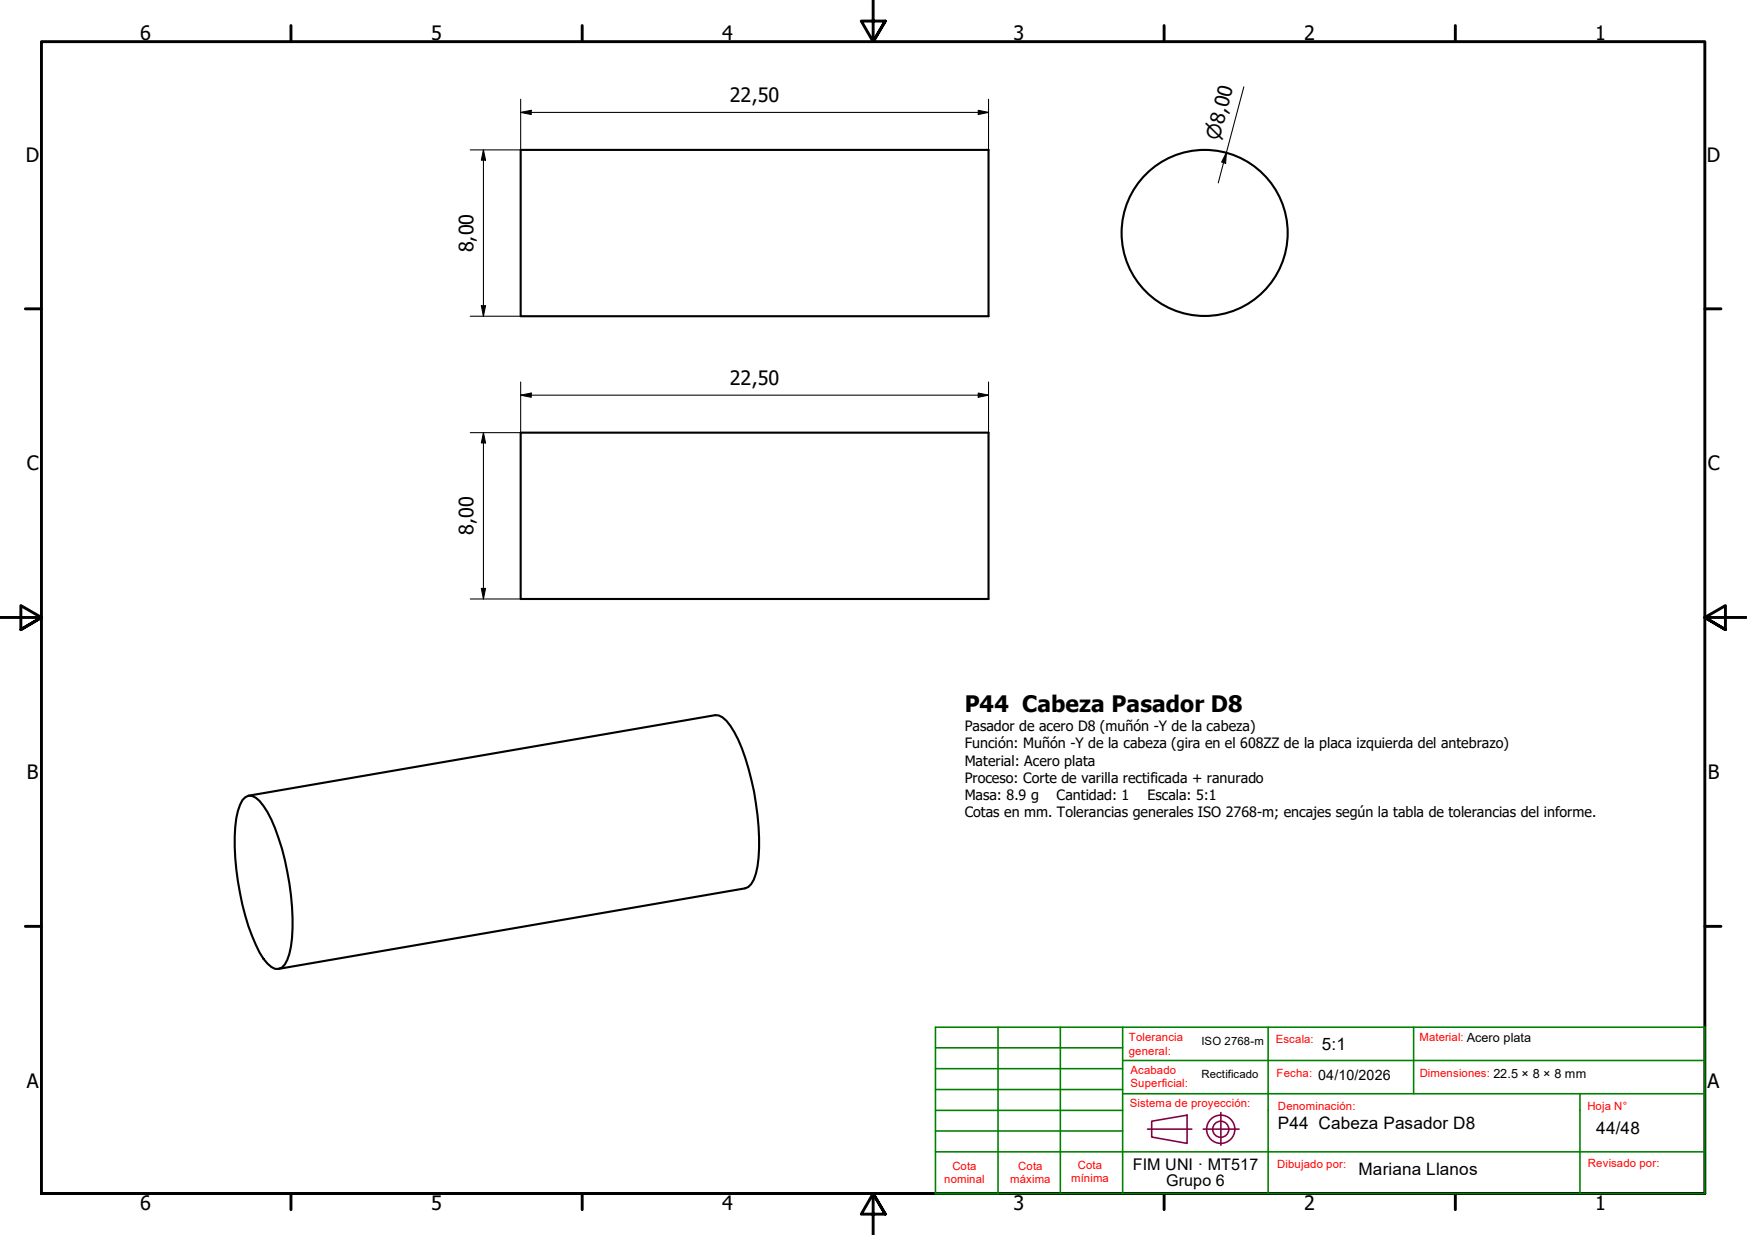
[picture p68: page 44]
Masa: 8.9 g; Cantidad: 1; Escala: 5:1

P44 Cabeza Pasador D8
Pasador de acero D8 (muñón -Y de la cabeza)
Función: Muñón -Y de la cabeza (gira en el 608ZZ de la placa izquierda del antebrazo)
Material: Acero plata
Proceso: Corte de varilla rectificada + ranurado
Cotas en mm. Tolerancias generales ISO 2768-m; encajes según la tabla de tolerancias del informe.

Tolerancia ISO 2768-m general: | Escala: 5:1 | Material: Acero plata

Acabado Rectificado Superficial: | Fecha: 04/10/2026 | Dimensiones: 22.5 × 8 × 8 mm

Sistema de proyección: | Denominación: P44 Cabeza Pasador D8 | Hoja N° 44/48

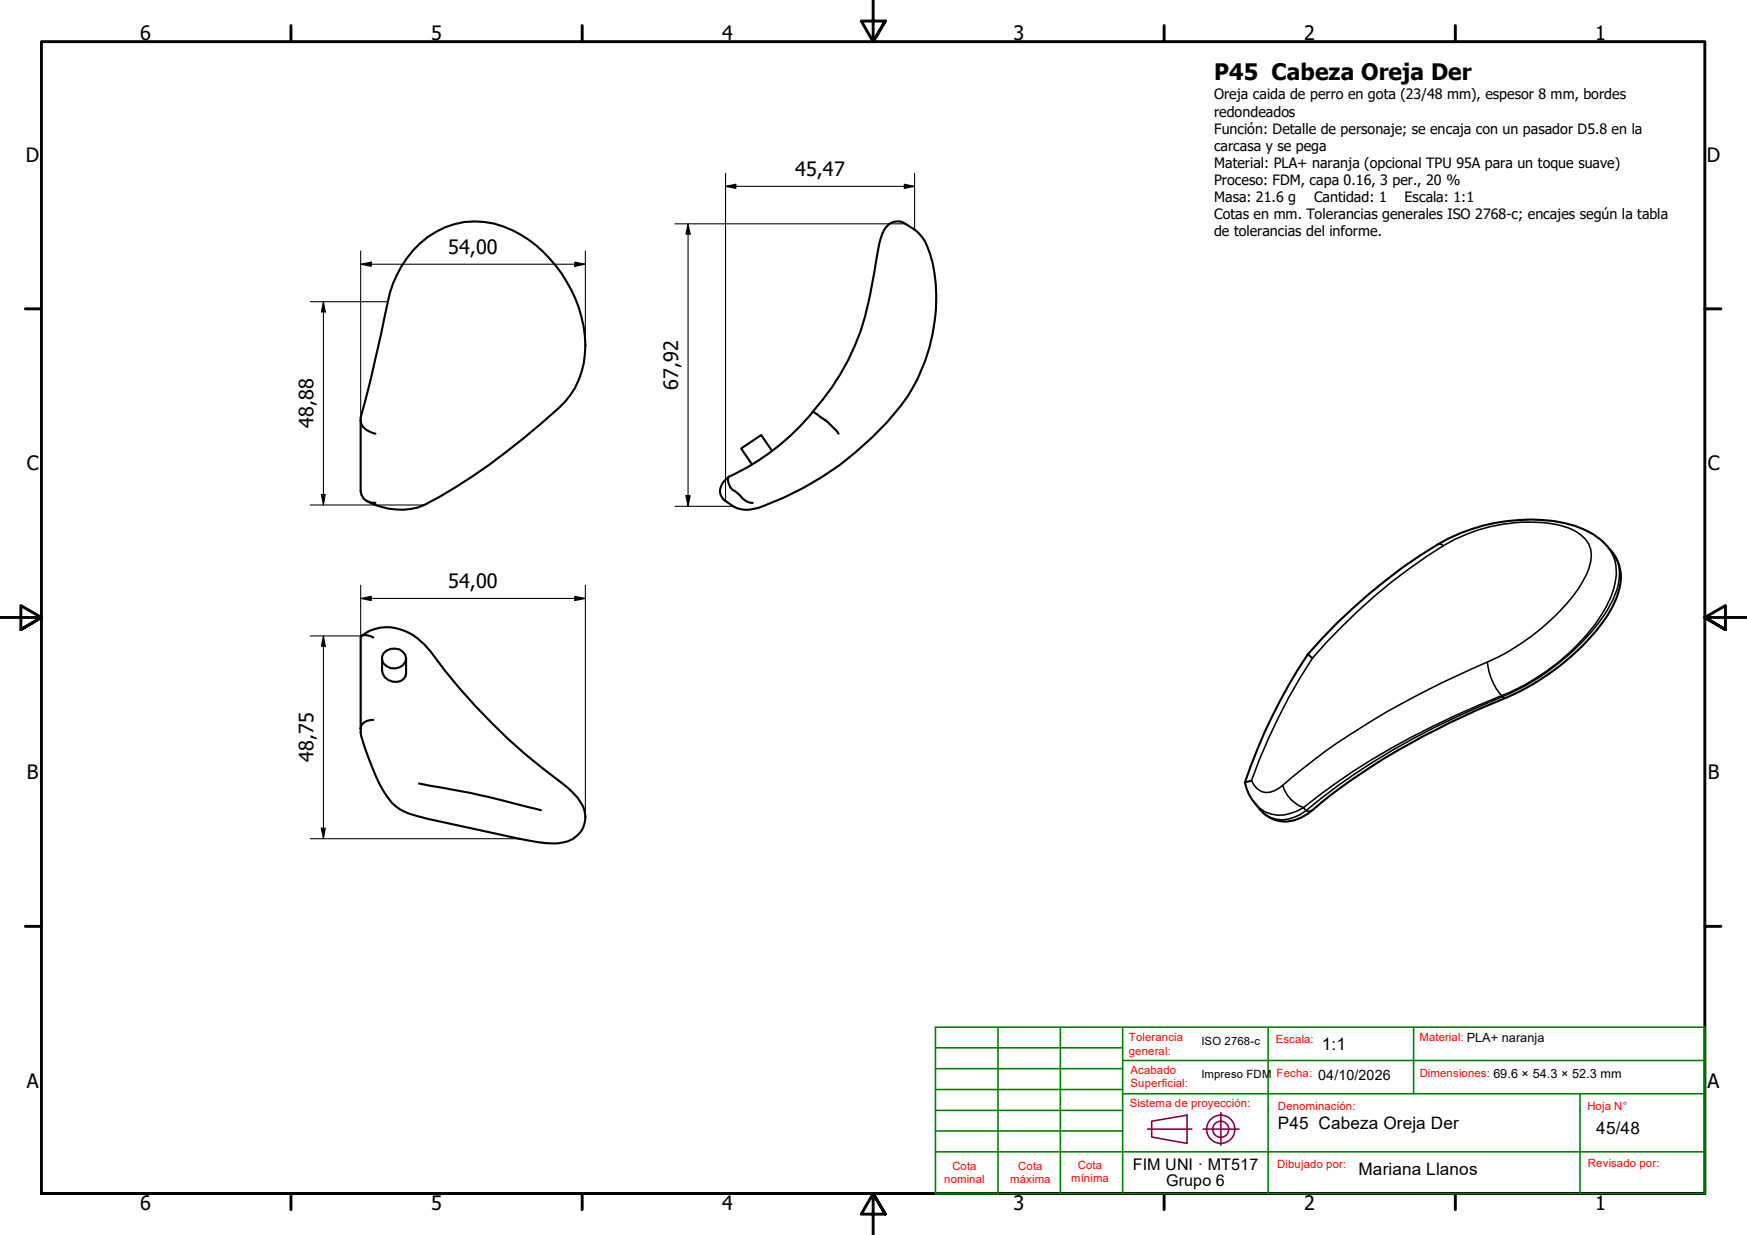
[picture p69: page 45]
Masa: 21.6 g; Cantidad: 1; Escala: 1:1

P45 Cabeza Oreja Der
Oreja caida de perro en gota (23/48 mm), espesor 8 mm, bordes
redondeados
Función: Detalle de personaje; se encaja con un pasador D5.8 en la
carcasa y se pega
Material: PLA+ naranja (opcional TPU 95A para un toque suave)
Proceso: FDM, capa 0.16, 3 per., 20 %
Cotas en mm. Tolerancias generales ISO 2768-c; encajes según la tabla
de tolerancias del informe.

Tolerancia ISO 2768-c general: | Escala: 1:1 | Material: PLA+ naranja

Acabado Impreso FDM Superficial: | Fecha: 04/10/2026 | Dimensiones: 69.6 × 54.3 × 52.3 mm

Sistema de proyección: | Denominación: P45 Cabeza Oreja Der | Hoja N° 45/48

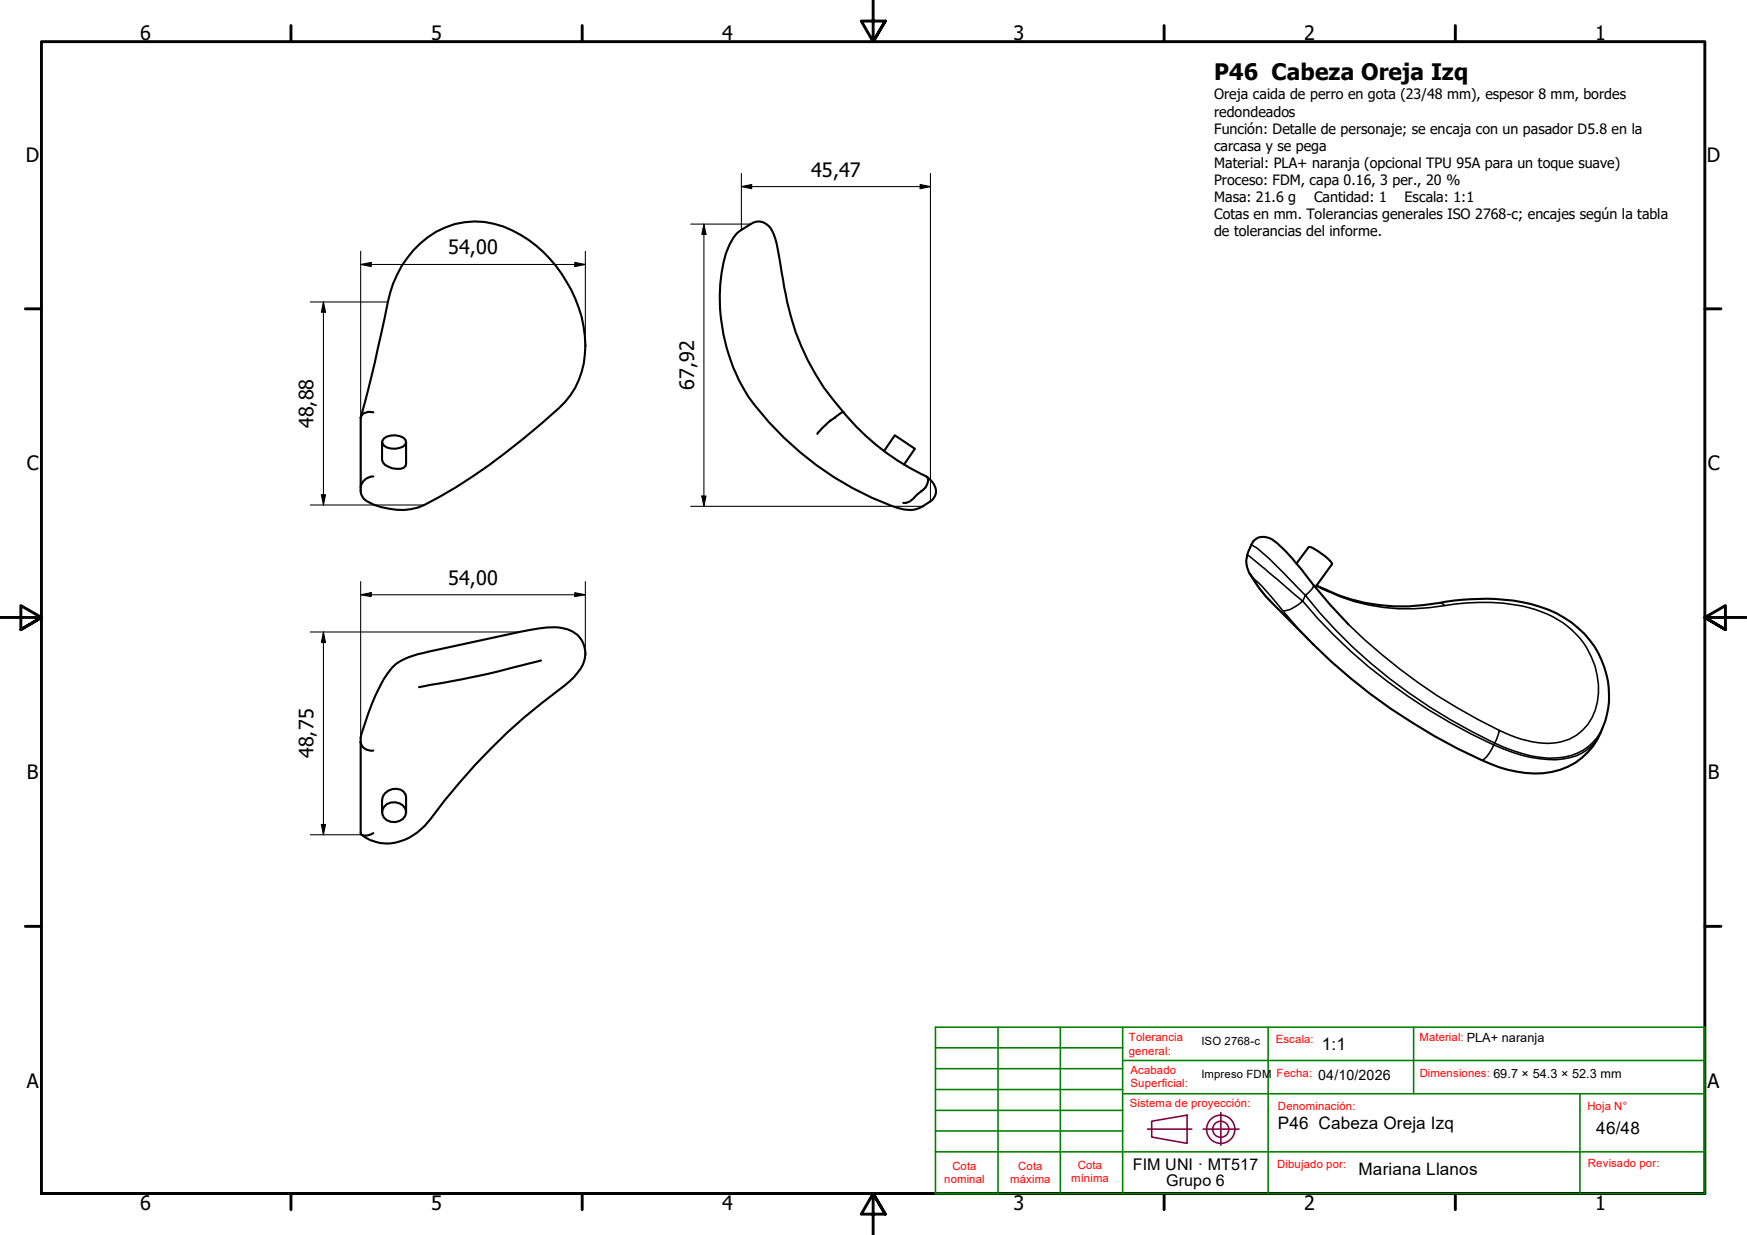
[picture p70: page 46]
Masa: 21.6 g; Cantidad: 1; Escala: 1:1

P46 Cabeza Oreja Izq
Oreja caida de perro en gota (23/48 mm), espesor 8 mm, bordes
redondeados
Función: Detalle de personaje; se encaja con un pasador D5.8 en la
carcasa y se pega
Material: PLA+ naranja (opcional TPU 95A para un toque suave)
Proceso: FDM, capa 0.16, 3 per., 20 %
Cotas en mm. Tolerancias generales ISO 2768-c; encajes según la tabla
de tolerancias del informe.

Tolerancia ISO 2768-c general: | Escala: 1:1 | Material: PLA+ naranja

Acabado Impreso FDM Superficial: | Fecha: 04/10/2026 | Dimensiones: 69.7 × 54.3 × 52.3 mm

Sistema de proyección: | Denominación: P46 Cabeza Oreja Izq | Hoja N° 46/48

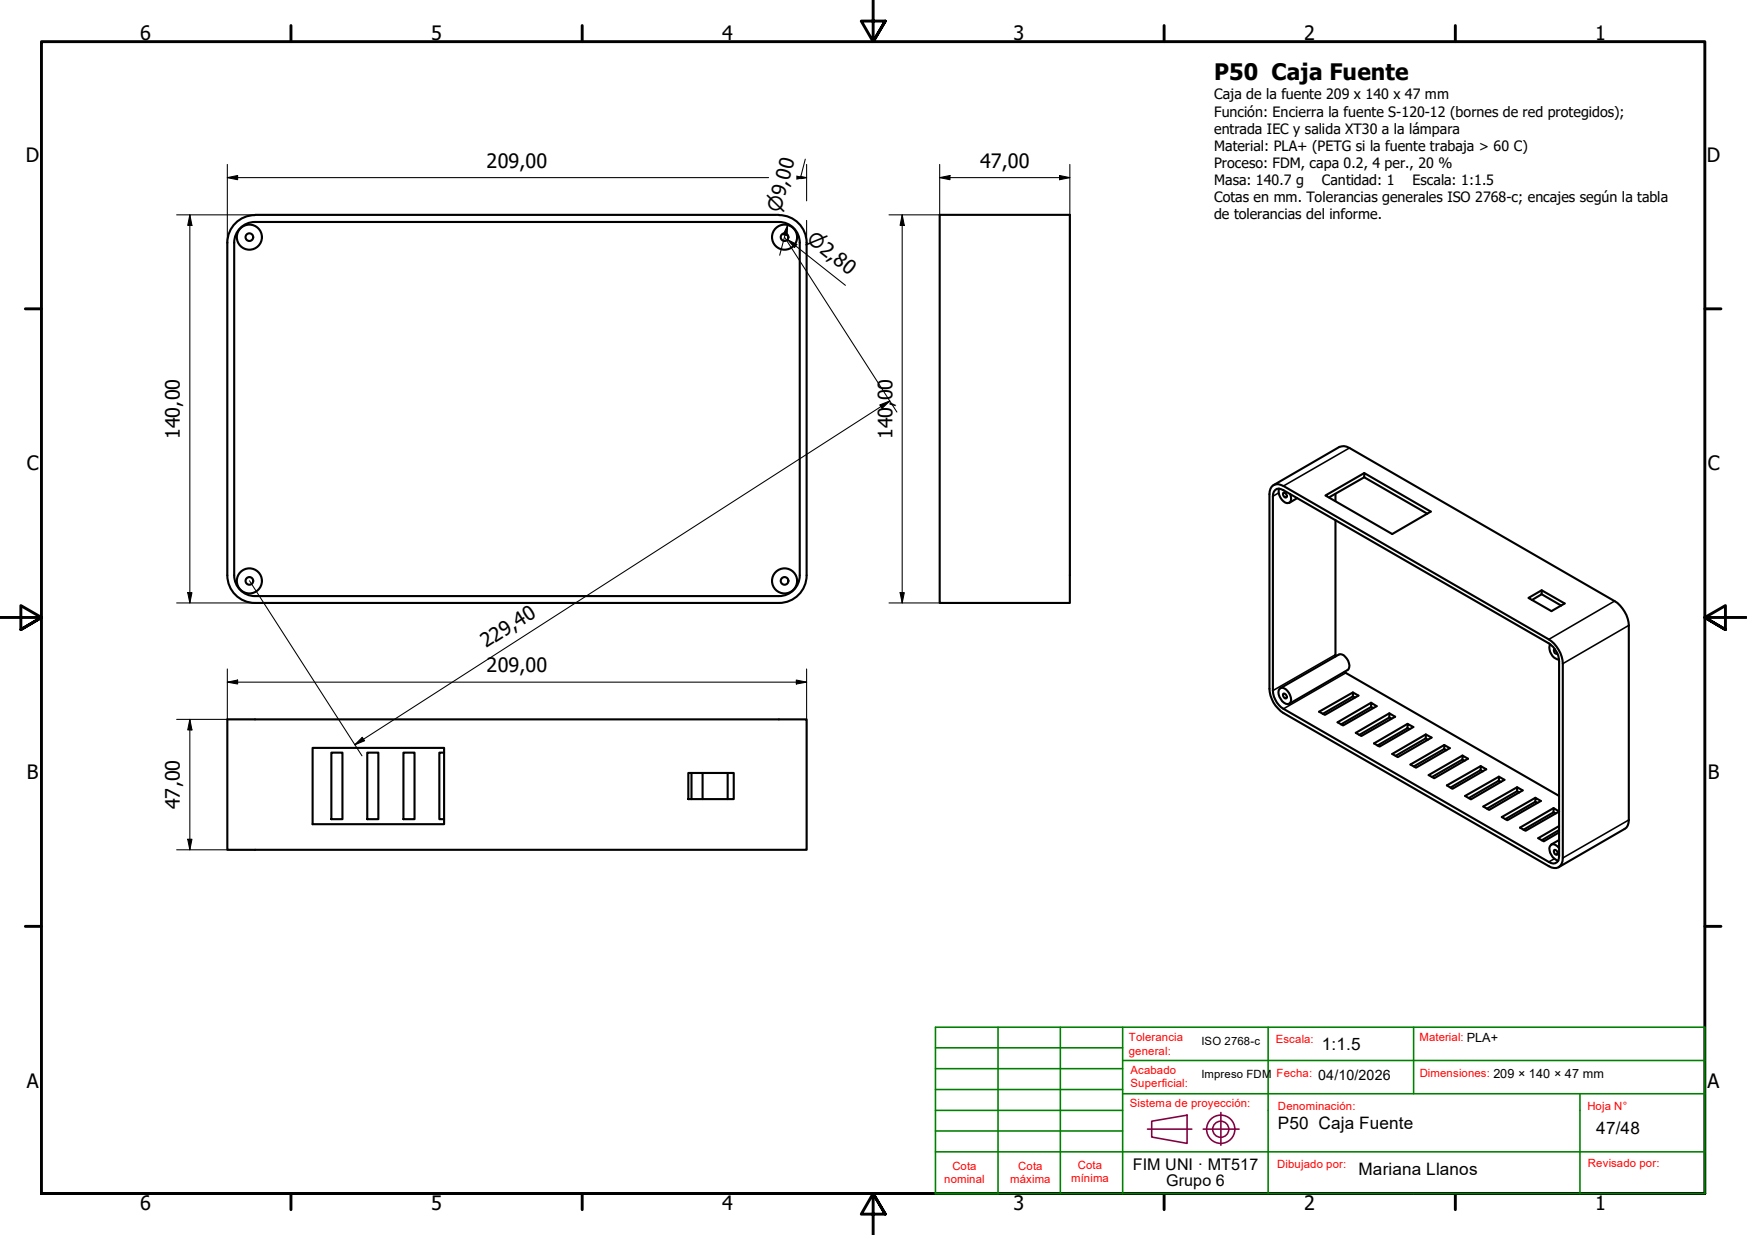
[picture p71: page 47]
Masa: 140.7 g; Cantidad: 1; Escala: 1:1.5

P50 Caja Fuente
Caja de la fuente 209 x 140 x 47 mm
Función: Encierra la fuente S-120-12 (bornes de red protegidos);
entrada IEC y salida XT30 a la lámpara
Material: PLA+ (PETG si la fuente trabaja > 60 C)
Proceso: FDM, capa 0.2, 4 per., 20 %
Cotas en mm. Tolerancias generales ISO 2768-c; encajes según la tabla
de tolerancias del informe.

Tolerancia ISO 2768-c general: | Escala: 1:1.5 | Material: PLA+

Acabado Impreso FDM Superficial: | Fecha: 04/10/2026 | Dimensiones: 209 × 140 × 47 mm

Sistema de proyección: | Denominación: P50 Caja Fuente | Hoja N° 47/48

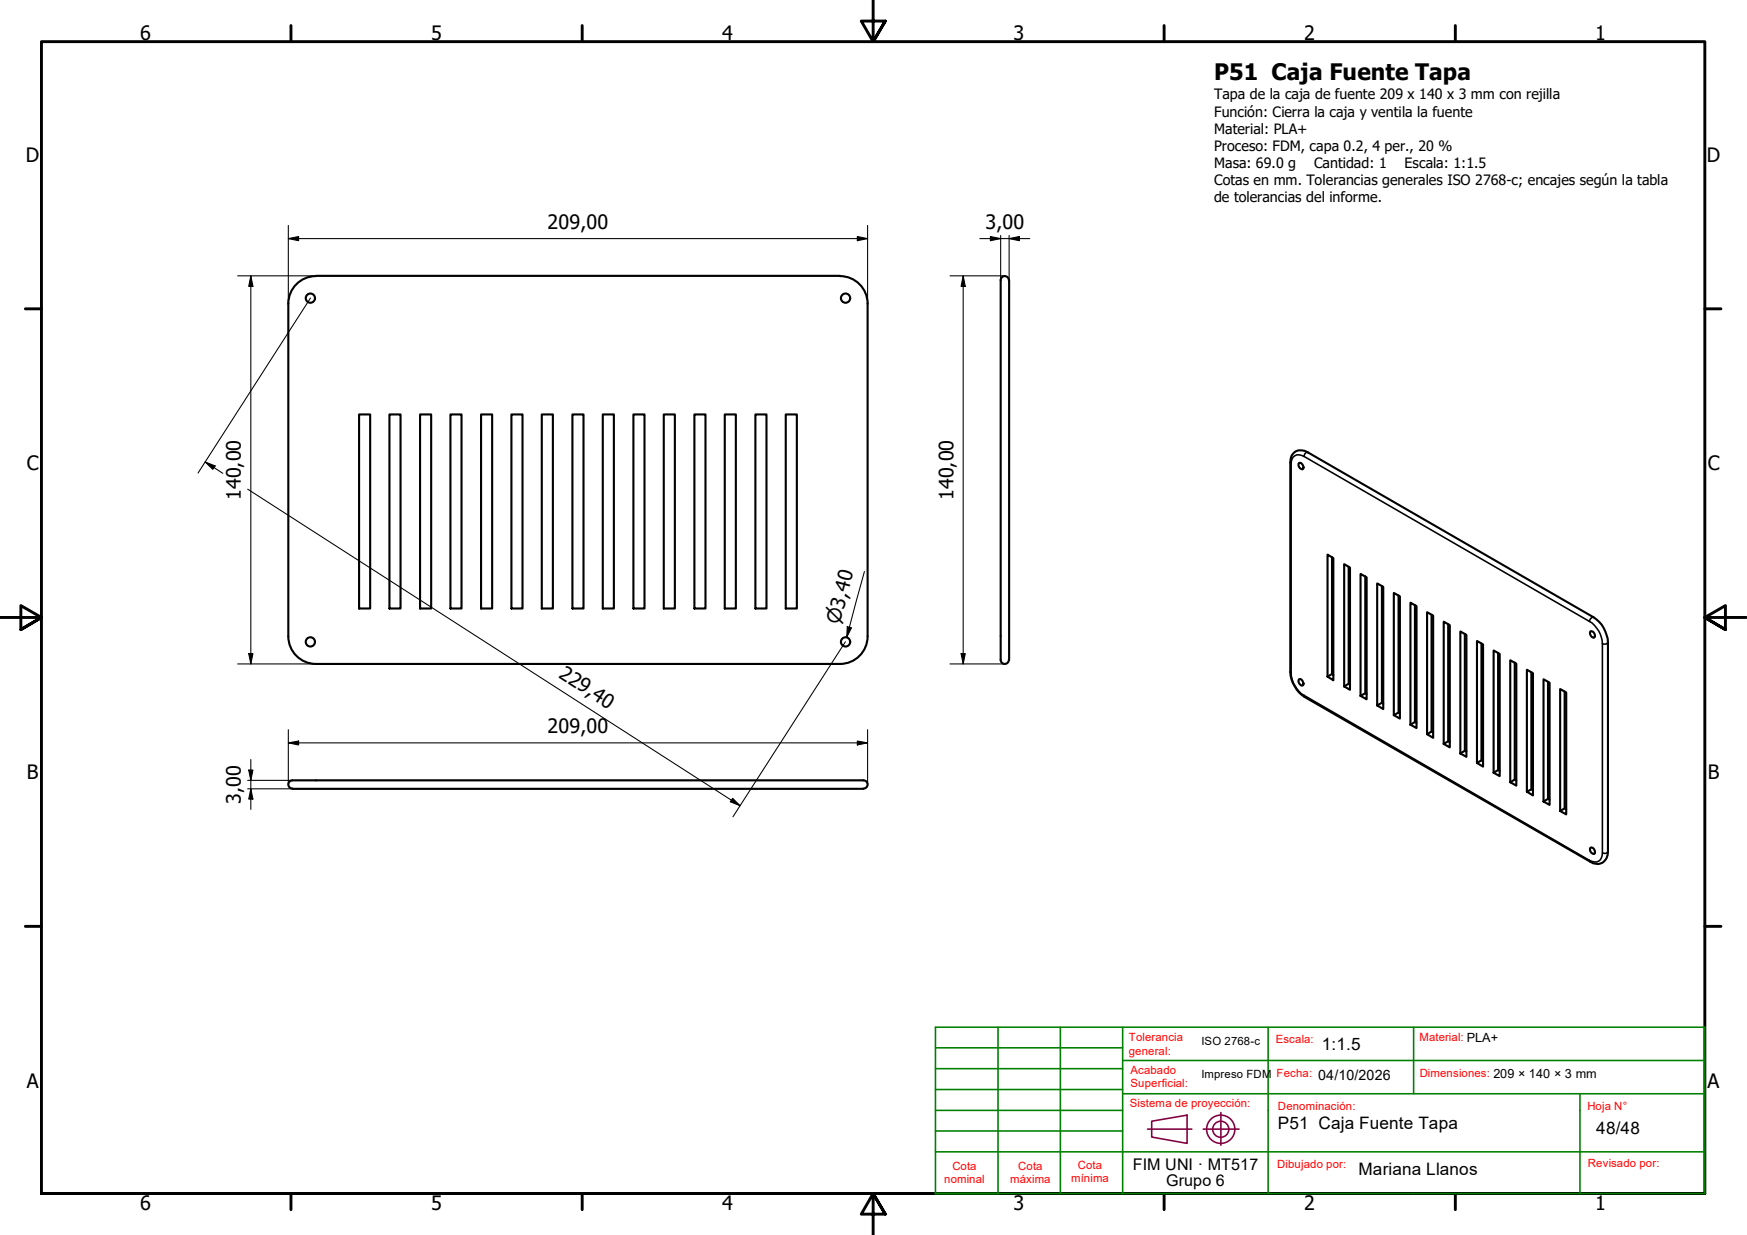
[picture p72: page 48]
Masa: 69.0 g; Cantidad: 1; Escala: 1:1.5

P51 Caja Fuente Tapa
Tapa de la caja de fuente 209 x 140 x 3 mm con rejilla
Función: Cierra la caja y ventila la fuente
Material: PLA+
Proceso: FDM, capa 0.2, 4 per., 20 %
Cotas en mm. Tolerancias generales ISO 2768-c; encajes según la tabla
de tolerancias del informe.

Tolerancia ISO 2768-c general: | Escala: 1:1.5 | Material: PLA+

Acabado Impreso FDM Superficial: | Fecha: 04/10/2026 | Dimensiones: 209 × 140 × 3 mm

Sistema de proyección: | Denominación: P51 Caja Fuente Tapa | Hoja N° 48/48
