miu-ll/robot-2/electronica/Fabricacion/Lampara_4R_capas_inf.pdf

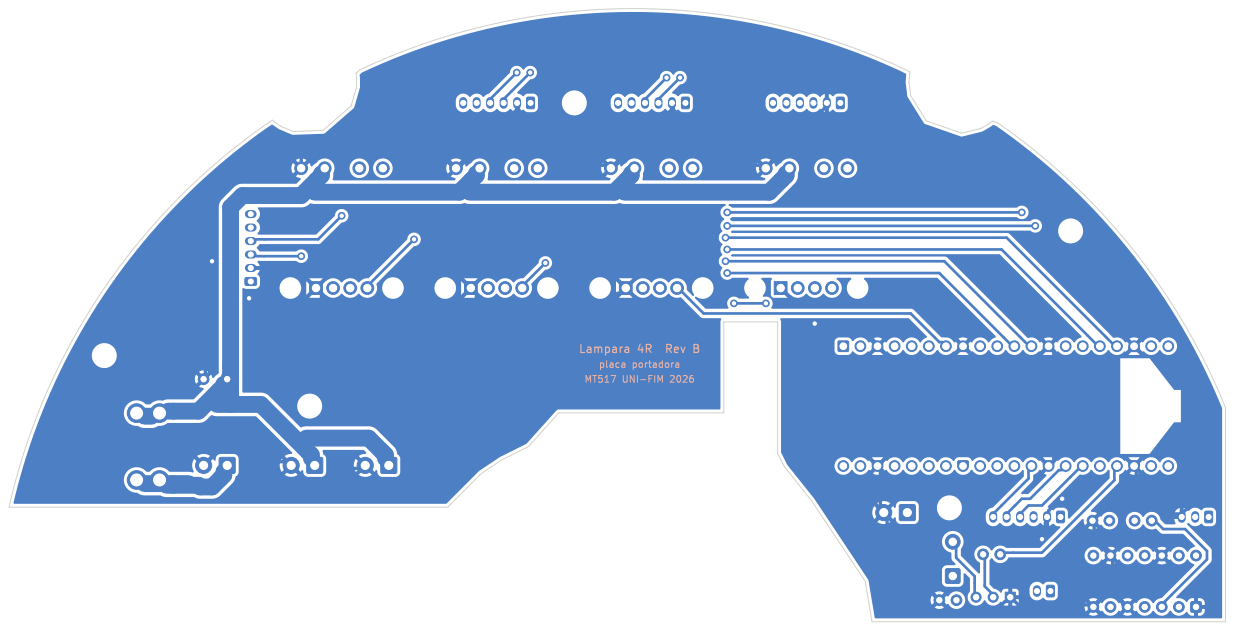
[picture p73: page 1]
