miu-ll/robot-2/electronica/Fabricacion/Lampara_4R_capas_sup.pdf

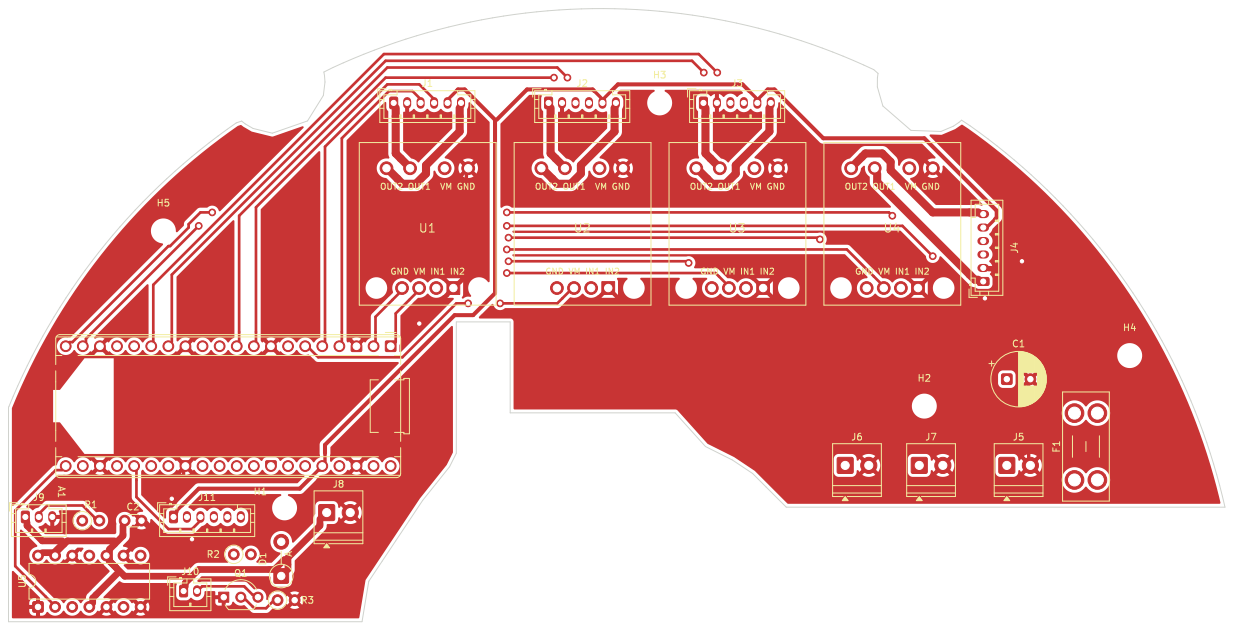
[picture p74: page 1]
