miu-ll/robot-2/electronica/Lampara_4R.kicad_pcb

## KiCad design electronica/Lampara_4R.kicad_pcb (2026-10-04)

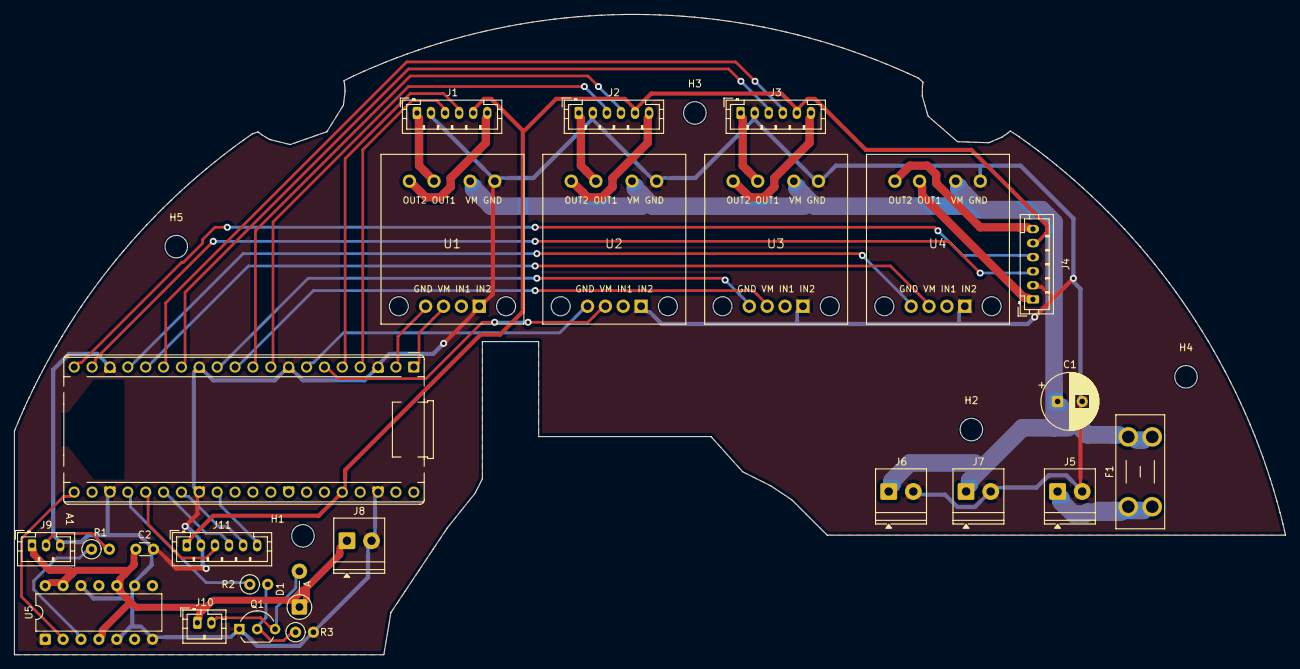
[picture p75: board Lampara_4R.kicad_pcb from above]

Board: 2 copper layers, 180.7 x 91.0 mm, 30 parts (0 on the bottom side), 39 nets.

Parts:
A1: Raspberry Pi Pico; RaspberryPi_Pico_Common_THT
C1: 470 uF 16 V; CP_Radial_D8.0mm_P3.50mm
C2: 100 nF; C_Disc_D3.0mm_W1.6mm_P2.50mm
D1: 1N5819; D_DO-41_SOD81_P5.08mm_Vertical_AnodeUp
F1: 10 A (ATM); Fuseholder_Blade_Mini_Keystone_3568
H1, H2, H3, H4, H5: M3; MountingHole_3.2mm_M3
J1: Motor q1 (PH2.0); JST_PH_B6B-PH-K_1x06_P2.00mm_Vertical
J2: Motor q2 (PH2.0); JST_PH_B6B-PH-K_1x06_P2.00mm_Vertical
J3: Motor q3 (PH2.0); JST_PH_B6B-PH-K_1x06_P2.00mm_Vertical
J4: Motor q4 (PH2.0); JST_PH_B6B-PH-K_1x06_P2.00mm_Vertical
J5: 12 V entrada; TerminalBlock_Phoenix_PT-1,5-2-3.5-H_1x02_P3.50mm_Horizontal
J6: 12 V a XL4016; TerminalBlock_Phoenix_PT-1,5-2-3.5-H_1x02_P3.50mm_Horizontal
J7: 12 V a LM2596; TerminalBlock_Phoenix_PT-1,5-2-3.5-H_1x02_P3.50mm_Horizontal
J8: 5 V desde LM2596; TerminalBlock_Phoenix_PT-1,5-2-3.5-H_1x02_P3.50mm_Horizontal
J9: Anillo LED (PH2.0); JST_PH_B3B-PH-K_1x03_P2.00mm_Vertical
J10: Ventilador (PH2.0); JST_PH_B2B-PH-K_1x02_P2.00mm_Vertical
J11: Sensores Hall (PH2.0); JST_PH_B6B-PH-K_1x06_P2.00mm_Vertical
Q1: 2N7000; TO-92_Inline_Wide
R1: 330; R_Axial_DIN0207_L6.3mm_D2.5mm_P2.54mm_Vertical
R2: 100; R_Axial_DIN0207_L6.3mm_D2.5mm_P2.54mm_Vertical
R3: 10 k; R_Axial_DIN0207_L6.3mm_D2.5mm_P2.54mm_Vertical
U1, U2, U3, U4: Adafruit DRV8871; Adafruit_DRV8871_Portadora
U5: 74AHCT125; DIP-14_W7.62mm

Connections:
+3V3: A1.36, J1.5, J2.5, J3.5, J4.5, J11.1
+5V: C2.1, D1.1, J8.1, J9.1, J10.1, U5.4, U5.10, U5.13, U5.14
+12V: C1.1, F1.2, J6.1, J7.1, U1.7, U2.7, U3.7, U4.7
/+12V_IN: F1.1, J5.1
/ENC1_A: A1.4, J1.3
/ENC1_B: A1.5, J1.4
/ENC2_A: A1.9, J2.3
/ENC2_B: A1.10, J2.4
/ENC3_A: A1.14, J3.3
/ENC3_B: A1.15, J3.4
/ENC4_A: A1.19, J4.3
/ENC4_B: A1.20, J4.4
/HALL1: A1.25, J11.3
/HALL2: A1.26, J11.4
/HALL3: A1.27, J11.5
/HALL4: A1.29, J11.6
/LED_3V3: A1.21, U5.2
/LED_5V: R1.1, U5.3
/LED_DIN: J9.2, R1.2
/M1_N: J1.6, U1.5
/M1_P: J1.1, U1.6
/M2_N: J2.6, U2.5
/M2_P: J2.1, U2.6
/M3_N: J3.6, U3.5
/M3_P: J3.1, U3.6
/M4_N: J4.6, U4.5
/M4_P: J4.1, U4.6
/PWM1_IN1: A1.1, U1.3
/PWM1_IN2: A1.2, U1.4
/PWM2_IN1: A1.6, U2.3
/PWM2_IN2: A1.7, U2.4
/PWM3_IN1: A1.11, U3.3
/PWM3_IN2: A1.12, U3.4
/PWM4_IN1: A1.16, U4.3
/PWM4_IN2: A1.17, U4.4
/VENT_G: Q1.2, R2.2, R3.1
/VENT_N: D1.2, J10.2, Q1.3
/VENT_PWM: A1.24, R2.1
GND: A1.3, A1.8, A1.13, A1.18, A1.23, A1.28, A1.38, C1.2, C2.2, J1.2, J2.2, J3.2, J4.2, J5.2, J6.2, J7.2, J8.2, J9.3, J11.2, Q1.1, R3.2, U1.1, U1.8, U2.1, U2.8, U3.1, U3.8, U4.1, U4.8, U5.1, U5.5, U5.7, U5.9, U5.12
